eoinjordan/botbuilder/docs/status.md

# Status and assumptions

One place for what has been simulated, checked or assumed. The site, the
recipes and the README do not repeat it. Each recipe carries a short tag
instead: Simulated, Assembly checked, Designed, In analysis, Needs a part or
Not possible.

Builds and parts the owner has printed and checked himself are recorded in
`config/validated.json` and marked on the site with the date. That file is
the only source of such a mark; see [admin.md](admin.md).

## What the tags mean

| Tag | Meaning |
|---|---|
| Simulated | Digitally assembled (`reports/assembly.json`) and run in MuJoCo (`reports/sim.json`). |
| Assembly checked | In the digital assembly only: fit, mass and static balance. |
| Designed | Parts and files as far as they exist for that selection; no analysis numbers. |
| In analysis | Design and analysis in progress on the walkers and two-wheeled builds. |
| Needs a part | Possible once the part the recipe names exists. |
| Not possible | A physical or electrical impossibility, with the reason and the nearest alternative. |

## The biped, as it stood in the README

The robot has never been
assembled or powered. The parts have not been printed as a set. The UNO Q
sketch has not been built or flashed. Dimensions the makers do not publish
are assumed and listed in [docs/assembly.md](assembly.md).

The pages said the same in their own words: the Flash page's commands and
the Control page's real-robot path have been exercised against the virtual
robot (the simulator behind the board's socket) only, and the sketch has not
been built.

## Unverified

- The comb feet: a proposal from simulation. Never printed or loaded; their
  stiffness is a hand calculation and is not in the simulation.
- The round display: its glass diameter, rim thickness, depth and mass, and
  the size of its battery, are assumed. The faces were not analysed on the
  turning head.
- Physical fit of anything: no part has been printed against a servo or a
  camera board.
- The pin holes and studs: no printed one has been tried with a real pin,
  beam or brick. Their nominal dimensions are from secondary sources.
- The other controllers: the masses of the Raspberry Pi boards, the hub's
  battery and the EV3 brick are estimates, and the full-size Pi's hole
  pattern and the EV3's size are not from their makers' pages.
- The turning head: the servo body, shaft position and horn height are
  assumed from SG90 data sheets, the adapter hole pattern is a guess to be
  measured, and no firmware drives it.
- The camera boards: only the ESP32-CAM outline and mass and the ESP32-S3-EYE
  outline are the makers' figures. Lens, button, connector and pin positions,
  board thickness and the other masses are assumed or scaled from pictures.
- The default camera is the ESP-EYE, mounted connector up. That its picture
  is upright with the connector down, so that VFLIP and HMIRROR are needed
  as mounted, is read from the lettering on the board. The sketchbot sketch
  has not been flashed for this robot, and how the board gets its 5 V on
  the robot is not chosen. The plug and cable above the board are not in
  the mass model.
- There is no camera firmware for an ESP32-CAM: see [docs/camera.md](camera.md).
- Every assumed dimension: servo ears, shaft position, horn size, board and
  shield mass, print density and infill.
- Holding torque, backlash, tie slip, flex of the 4 mm plates.
- Floor friction and the contact model, on which the walk and its heading
  drift depend.
- The motion study (docs/motion.md): every result is from the model. Its dead
  band, gear play, series spring, delays and stall currents are estimates;
  the soles are rigid in it.
- Power off: the model's relaxed robot sinks on to the servo travel stops
  (hip pitch 90, knee -90 degrees) and stays on its soles. Where the real
  stops are, and whether they take the weight, is not known. Between hip
  pitch 65 and 75 degrees with level soles the top of each shin grazes the
  torso in the meshes (up to 13 mm3); the model lets it pass. Switched off in
  mid stride the legs meet; where the robot then rests is not predicted.
- The leg clearance rule: checked against the meshes, not on the robot. Its
  4 mm margin is about the size of the play at a sole, so it depends on the
  horn zeros. It covers leg against leg only. Its cost on the microcontroller
  (double arithmetic) has not been measured, and the sketch must be built
  without fused multiply-add for the firmware to agree with the reference.
- The hold command `H` and `ERR CLEAR`: in the reference, the host-compiled
  core and the page; the sketch that carries them has not been built.
- Turning: the step difference does not steer the model reliably. The jump:
  a hop in the model; never to be tried before the robot has stood and
  walked.
- Servo direction and zero in the calibration table.
- The sketch: not built, not flashed. `Serial` as the header UART, relax by
  zero duty and the `String` Bridge function are to be checked at first build.
- Stall currents, and how the Braccio shield shares power with the UNO Q.

## The configurator's data

Maker figures and their sources are in `config/bases.json` and
`config/hardware.json`; every figure there is marked published (with the
URL), assumed (with the reason) or not verified. From the first pass over
the makers' documentation:

- EV3 brick dimensions and mass, and EV3 motor torque and stall current, are
  not from a LEGO document.
- The mass of the Raspberry Pi boards, the Build HAT and its outline, the
  51515 hub battery and an M5Stack Core are estimates or missing.
- That the 51515 hub has the same body as the SPIKE Prime hub whose fact
  sheet gives 88 x 56 x 32 mm and 63 g without battery is assumed.
- No specific I2C servo driver board, H-bridge board or TT motor was checked
  against a maker's page. H-bridge pin names follow the chip data sheets.
- Stall currents of the Braccio servos are assumed (2.0 A and 1.0 A); the
  maker publishes none.
- Whether the BALA-C's servos are the Servo Kit 360 part and take a PWM
  signal directly is not established.
- The free PWM pins on the UNO Q under the Braccio shield are candidates
  read from the core's overlay.
- The Pixy2 on an EV3: Charmed Labs documents the LEGO cable and the LEGO
  I2C setting for a regular Pixy2; their EV3 block and Python class have no
  servo call, and whether the Pixy2's own pan-tilt program runs while it
  answers an EV3 is not stated.
- Pixy2 libraries on the UNO Q, the Raspberry Pi and an M5Stack Core were
  not tried.
- The XIAO ESP32S3 Sense head: mount files are being designed.
- Values a builder must measure are marked "measure" in the recipes: the
  M5Stack bracket and adapter hole patterns, the Pixy pan-tilt base, horn
  screws, wheel shafts and the battery size.

## The Microduck-look biped

Report: [microduck-look.md](microduck-look.md). Generated geometry, an
assembly test and a simulation; nothing printed.

- Servo sizes: the case sizes of the SR431 and SR311 are the maker's; the
  shaft position, the mounting ears, the horn and its height above the case
  are assumed, as for the plate biped. The small servo's body is taken from
  SG90 data sheets; M5Stack gives the kit's size only. Two axes were moved
  because of the ears (hip pitch 4.75 mm, ankle 6.5 mm): if the real ears are
  smaller the moves are larger than needed, if larger the servos meet.
- The small servos: the build needs three position servos. M5Stack's Servo
  Kit 180 is one; the owner's units from a BALA-C are continuous-rotation
  servos driven there through an L9110S bridge and are not usable as joints.
- Masses: UNO Q and shield 55 g a stack, camera 8 g, both estimates. Printed
  mass is volume times 1.24 g/cm3 times 0.8 for shells and 0.6 for brackets
  (0.45 for the lower beak). Wiring is not in the model.
- The shells' walls are the source's, scaled; they were not measured part by
  part. The upper head shell prints standing on its face with supports under
  its closed end: not tried.
- Holding torque limit: half of stall, a rule of thumb. Stall currents of the
  Braccio servos are assumed (2.0 A and 1.0 A).
- Joints hang on the servo shafts; only the neck, head roll and beak have a
  second pivot. What a shaft and its plastic horn carry at the hip is not
  known. The hip yaw shaft carries the leg's weight along its axis.
- Joint ranges are from single-joint sweeps from the stand pose plus one
  sweep of both hip rolls together. Other combinations were not swept. No
  leg clearance rule exists for this build and the webs of the two feet can
  meet.
- The simulation collides parts with the floor only, uses rigid parts and an
  ideal position servo (stall torque at a 4 degree error, no dead band, no
  backlash, no supply limit), a 50 Hz command path with one tick of delay,
  and floor friction 0.6. The motion study's fuller servo model
  (docs/motion.md) was not applied to it.
- The gait is open loop and was searched on three variations of the model
  with a small budget. Whether it steps on the real floor is not known.
- The comb feet are the two feet with fingers added by
  `microduck/look/combfeet.py`: 4 mm thick, 10 mm wide, reaching 32 mm past
  the centre line, one rib each. Their stiffness and strength under the
  robot's weight were not calculated; the simulation takes them as rigid. Not
  printed.
- Walking speed on each set of feet (`reports/microduck-look/summary.json`,
  `walking_speed_by_feet`) is one seeded search and one 30 s run for each, in
  the same simple simulation. The stride the search settled on is at the
  small end of its range on both. In the simulation the two feet do not
  collide with each other; for the comb feet the search checks the feet's
  exact meshes at the commanded poses of one gait cycle instead, which is not
  the same as the poses the model reaches.
- With comb feet and both soles down, one hip turned or rolled alone brings
  the fingers together after a few degrees. No rule in any controller stops
  that; the joint table holds the limits of the plain feet.
- Firmware for fifteen joints, for two boards as one controller and for the
  I2C driver: not written. The channel map in
  `config/microduck-look/build.json` is a proposal.
- The UNO Q's header has six PWM pins, all used by a Braccio shield; that a
  second shield cannot share a board follows from the data sheet's pin table,
  not from a trial.
- The camera lies on its side: the picture needs turning a quarter, which the
  camera sketch does not do.
- The original: its servo variant is not named in Pollen Robotics' files; the
  0.96 N m limit in its simulation is above Robotis' stall figure for either
  XL330 at 5 V.
- Licence: the part pack carries no licence of its own. That it is an export
  of Pollen Robotics' model rests on its name, its part list and identical
  triangle counts with the meshes in their repository.
