eoinjordan/botbuilder/docs/images/lego-ev3-pixy2-top.png

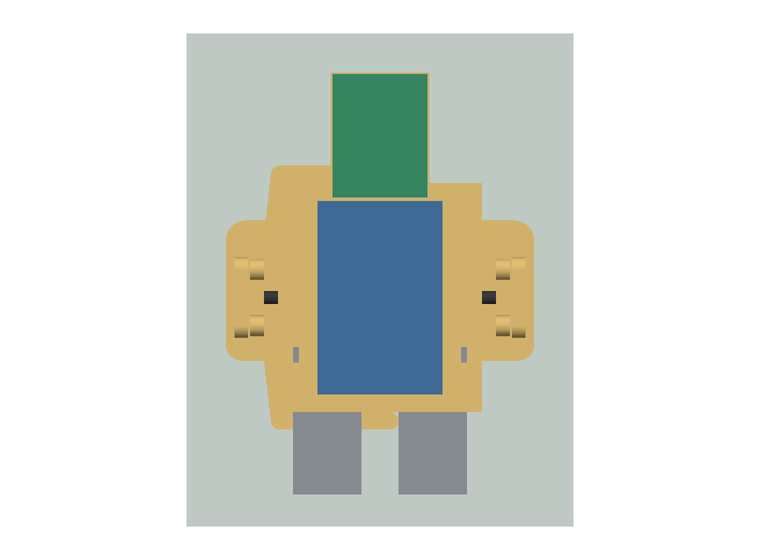
docs/images/lego-ev3-pixy2-top.png
