eoinjordan/botbuilder/site/assets/social-preview.png

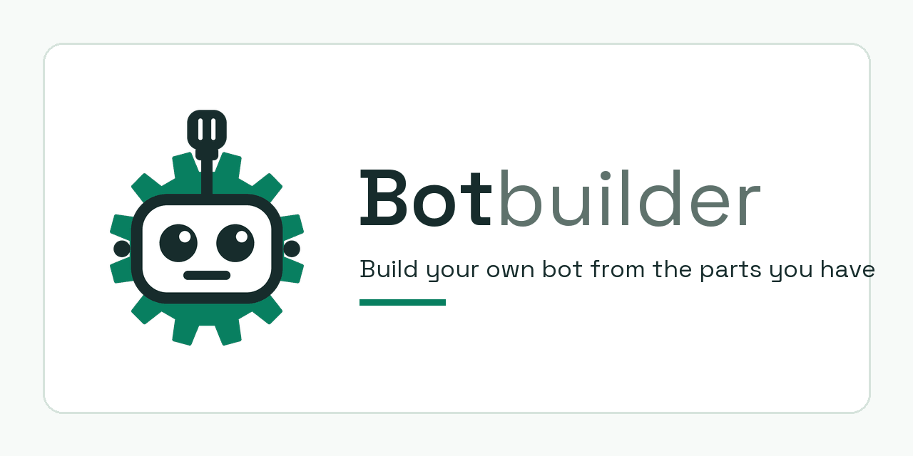
site/assets/social-preview.png
