eoinjordan/botbuilder/stl/thumbs/01_torso_hub51515_cam_esp32cam.png

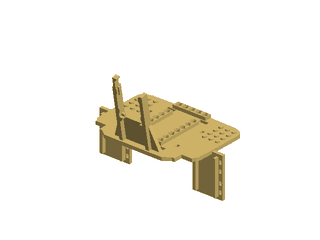
stl/thumbs/01_torso_hub51515_cam_esp32cam.png
