eoinjordan/botbuilder/stl/thumbs/01_torso_unoq_pan_head.png

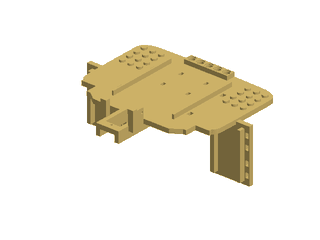
stl/thumbs/01_torso_unoq_pan_head.png
