eoinjordan/botbuilder/stl/thumbs/fit_cam_esp32_s3_eye.png

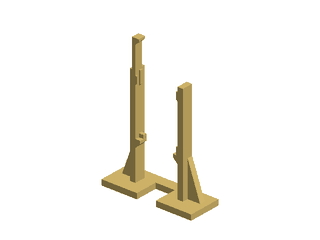
stl/thumbs/fit_cam_esp32_s3_eye.png
