eoinjordan/botbuilder/stl/thumbs/fit_cam_esp_eye.png

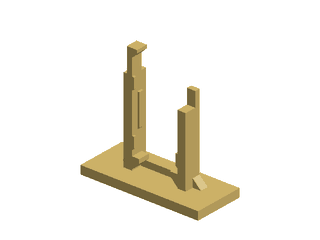
stl/thumbs/fit_cam_esp_eye.png
