eoinjordan/botbuilder/stl/thumbs/fit_horn_drill_blank.png

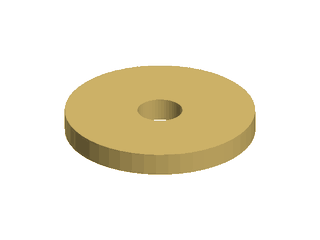
stl/thumbs/fit_horn_drill_blank.png
