eoinjordan/botbuilder/stl/thumbs/fit_lego_compatible_coupon.png

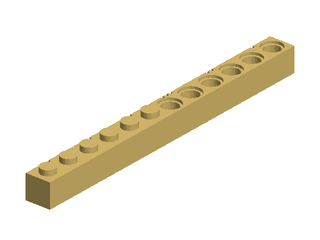
stl/thumbs/fit_lego_compatible_coupon.png
