eoinjordan/botbuilder/stl/thumbs/fit_round_display.png

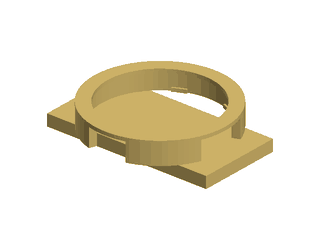
stl/thumbs/fit_round_display.png
