eoinjordan/botbuilder/stl/thumbs/fit_sg90_cradle.png

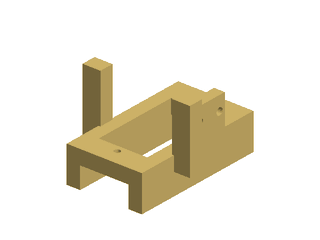
stl/thumbs/fit_sg90_cradle.png
