eoinjordan/botbuilder/stl/thumbs/fit_SR311.png

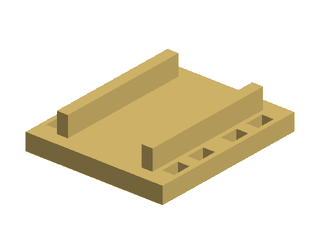
stl/thumbs/fit_SR311.png
