eoinjordan/botbuilder/stl/thumbs/fit_SR431.png

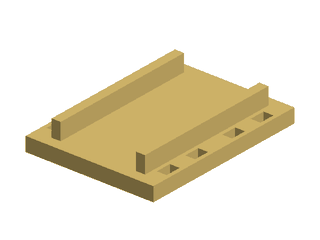
stl/thumbs/fit_SR431.png
