eoinjordan/botbuilder/stl/thumbs/head_pan_platform.png

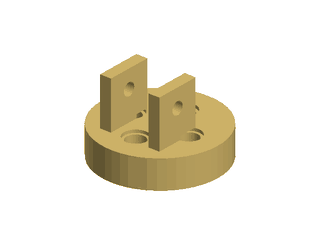
stl/thumbs/head_pan_platform.png
