eoinjordan/botbuilder/stl/thumbs/head_pixy_plate_pixy1.png

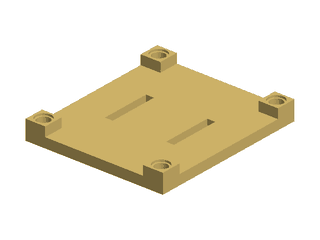
stl/thumbs/head_pixy_plate_pixy1.png
