eoinjordan/botbuilder/stl/thumbs/head_tilt_cradle_esp32cam.png

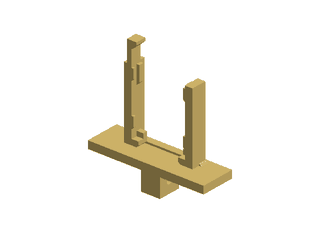
stl/thumbs/head_tilt_cradle_esp32cam.png
