eoinjordan/botbuilder/stl/thumbs/head_tilt_cradle_eyes_above_esp32cam.png

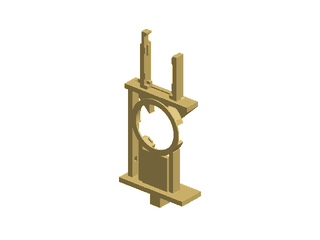
stl/thumbs/head_tilt_cradle_eyes_above_esp32cam.png
