eoinjordan/botbuilder/stl/thumbs/head_tilt_cradle_stack_camera_forward.png

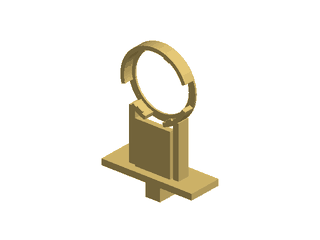
stl/thumbs/head_tilt_cradle_stack_camera_forward.png
