eoinjordan/botbuilder/stl/thumbs/left_hip_roll_pitch_yoke.png

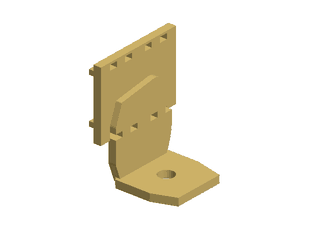
stl/thumbs/left_hip_roll_pitch_yoke.png
