eoinjordan/botbuilder/stl/thumbs/left_shin_comb_foot.png

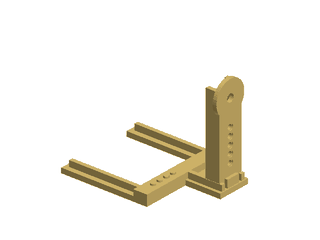
stl/thumbs/left_shin_comb_foot.png
