eoinjordan/botbuilder/stl/thumbs/left_shin_flat_foot.png

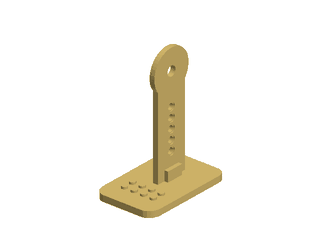
stl/thumbs/left_shin_flat_foot.png
