eoinjordan/botbuilder/stl/thumbs/left_thigh_knee_cradle.png

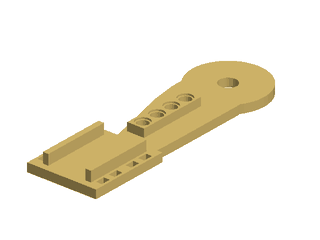
stl/thumbs/left_thigh_knee_cradle.png
