eoinjordan/botbuilder/stl/thumbs/lego/ev3-pixy2/camera_head_pantilt.png

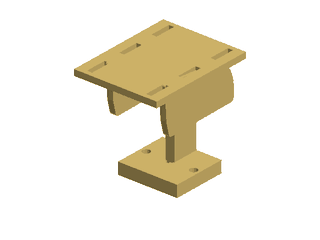
stl/thumbs/lego/ev3-pixy2/camera_head_pantilt.png
