eoinjordan/botbuilder/stl/thumbs/lego/ev3-pixy2/chassis.png

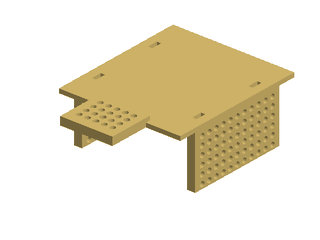
stl/thumbs/lego/ev3-pixy2/chassis.png
