eoinjordan/botbuilder/stl/thumbs/lego/ev3-pixy2/fit_coupon.png

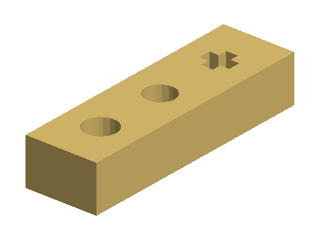
stl/thumbs/lego/ev3-pixy2/fit_coupon.png
