eoinjordan/botbuilder/stl/thumbs/lego/ev3-pixy2/left_leg.png

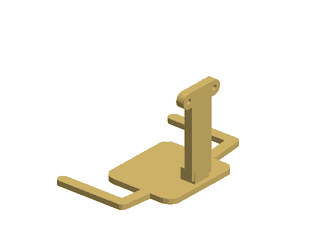
stl/thumbs/lego/ev3-pixy2/left_leg.png
