eoinjordan/botbuilder/stl/thumbs/lego/ev3-pixy2/right_leg.png

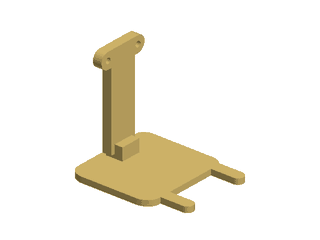
stl/thumbs/lego/ev3-pixy2/right_leg.png
