eoinjordan/botbuilder/stl/thumbs/lego/hub-51515/chassis.png

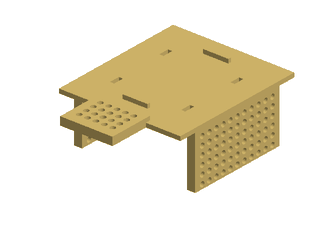
stl/thumbs/lego/hub-51515/chassis.png
