eoinjordan/botbuilder/stl/thumbs/lego/wheeled/driver_plate.png

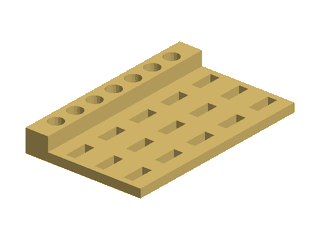
stl/thumbs/lego/wheeled/driver_plate.png
