eoinjordan/botbuilder/stl/thumbs/lego/wheeled/fit_bore_cross.png

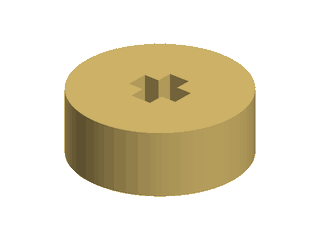
stl/thumbs/lego/wheeled/fit_bore_cross.png
