eoinjordan/botbuilder/stl/thumbs/lego/wheeled/fit_bore_tt.png

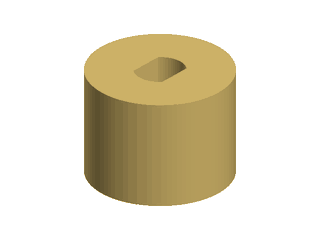
stl/thumbs/lego/wheeled/fit_bore_tt.png
