eoinjordan/botbuilder/stl/thumbs/lego/wheeled/fit_servo_cradle.png

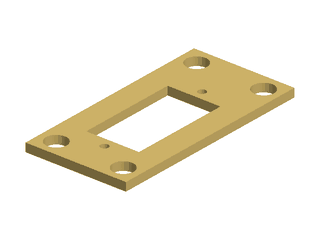
stl/thumbs/lego/wheeled/fit_servo_cradle.png
