eoinjordan/botbuilder/stl/thumbs/lego/wheeled/fit_tt_cradle.png

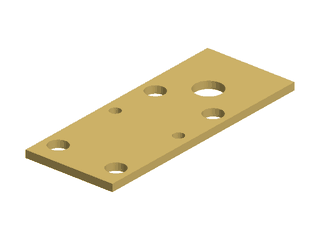
stl/thumbs/lego/wheeled/fit_tt_cradle.png
