eoinjordan/botbuilder/stl/thumbs/lego/wheeled/hub_tpu_cross_d56.png

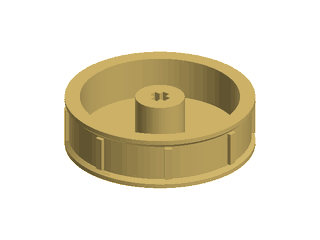
stl/thumbs/lego/wheeled/hub_tpu_cross_d56.png
