eoinjordan/botbuilder/stl/thumbs/lego/wheeled/idler_hub.png

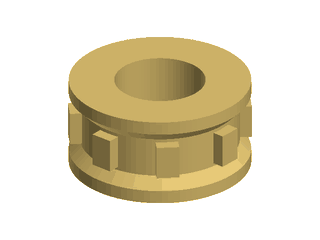
stl/thumbs/lego/wheeled/idler_hub.png
