eoinjordan/botbuilder/stl/thumbs/lego/wheeled/idler_tyre_tpu.png

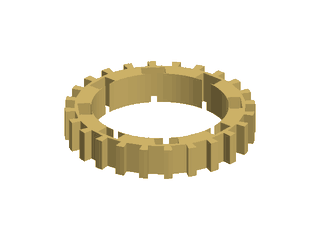
stl/thumbs/lego/wheeled/idler_tyre_tpu.png
