eoinjordan/botbuilder/stl/thumbs/lego/wheeled/post_d43.png

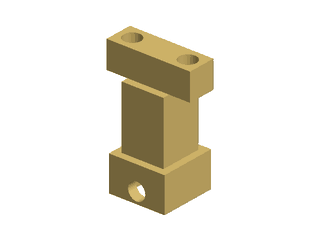
stl/thumbs/lego/wheeled/post_d43.png
