eoinjordan/botbuilder/stl/thumbs/lego/wheeled/tip_idler_fork.png

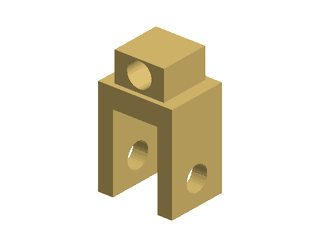
stl/thumbs/lego/wheeled/tip_idler_fork.png
