eoinjordan/botbuilder/stl/thumbs/lego/wheeled/tyre_tpu_d43.png

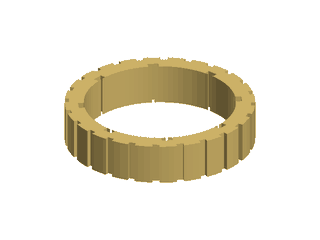
stl/thumbs/lego/wheeled/tyre_tpu_d43.png
