eoinjordan/botbuilder/stl/thumbs/microduck-look/beak_jaw.png

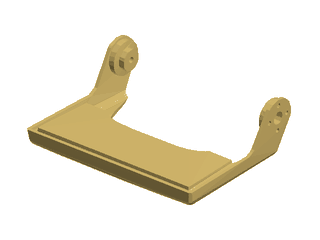
stl/thumbs/microduck-look/beak_jaw.png
