eoinjordan/botbuilder/stl/thumbs/microduck-look/beak_top.png

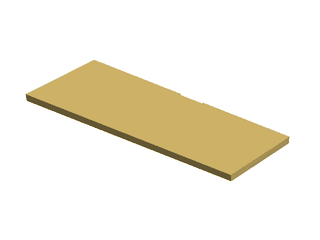
stl/thumbs/microduck-look/beak_top.png
