eoinjordan/botbuilder/stl/thumbs/microduck-look/body_left.png

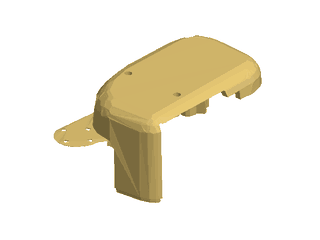
stl/thumbs/microduck-look/body_left.png
