eoinjordan/botbuilder/stl/thumbs/microduck-look/body_right.png

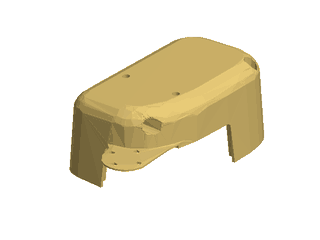
stl/thumbs/microduck-look/body_right.png
