eoinjordan/botbuilder/stl/thumbs/microduck-look/fit_eye_esp_eye.png

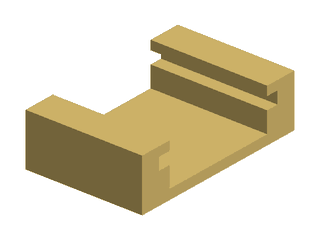
stl/thumbs/microduck-look/fit_eye_esp_eye.png
