eoinjordan/botbuilder/stl/thumbs/microduck-look/fit_M5_180.png

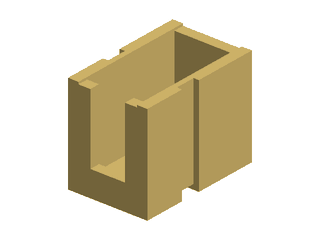
stl/thumbs/microduck-look/fit_M5_180.png
