eoinjordan/botbuilder/stl/thumbs/microduck-look/fit_SR311.png

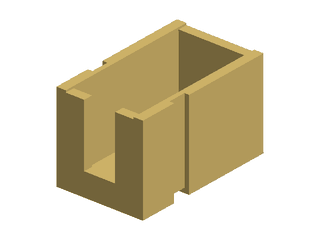
stl/thumbs/microduck-look/fit_SR311.png
