eoinjordan/botbuilder/stl/thumbs/microduck-look/fit_SR431.png

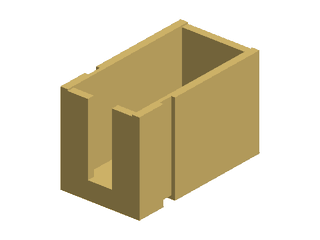
stl/thumbs/microduck-look/fit_SR431.png
