eoinjordan/botbuilder/stl/thumbs/microduck-look/head_base.png

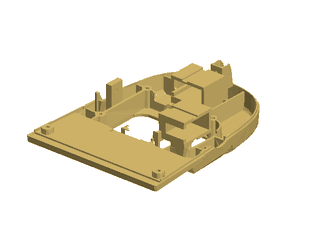
stl/thumbs/microduck-look/head_base.png
