eoinjordan/botbuilder/stl/thumbs/microduck-look/head_face.png

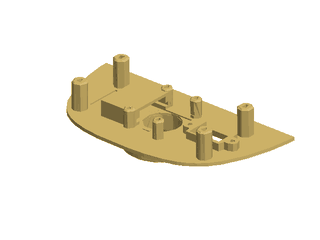
stl/thumbs/microduck-look/head_face.png
