eoinjordan/botbuilder/stl/thumbs/microduck-look/head_pitch_yoke.png

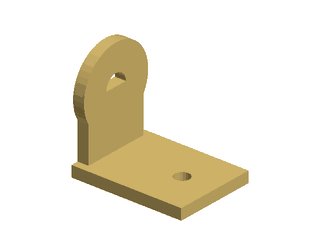
stl/thumbs/microduck-look/head_pitch_yoke.png
