eoinjordan/botbuilder/stl/thumbs/microduck-look/head_top.png

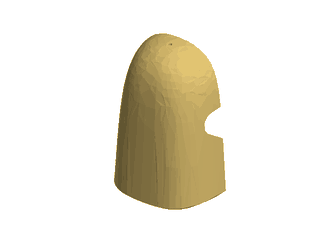
stl/thumbs/microduck-look/head_top.png
