eoinjordan/botbuilder/stl/thumbs/microduck-look/head_yaw_carrier.png

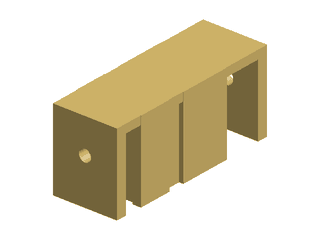
stl/thumbs/microduck-look/head_yaw_carrier.png
