eoinjordan/botbuilder/stl/thumbs/microduck-look/left_foot.png

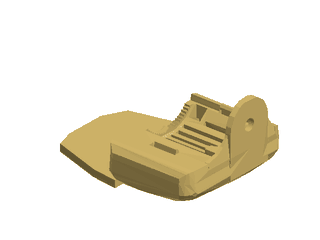
stl/thumbs/microduck-look/left_foot.png
