eoinjordan/botbuilder/stl/thumbs/microduck-look/left_foot_comb.png

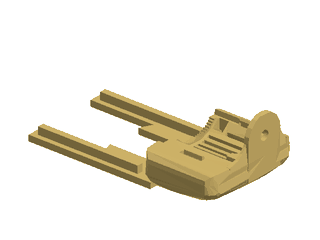
stl/thumbs/microduck-look/left_foot_comb.png
