eoinjordan/botbuilder/stl/thumbs/microduck-look/left_hip_roll.png

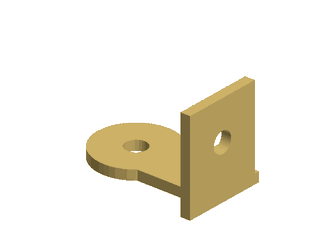
stl/thumbs/microduck-look/left_hip_roll.png
