eoinjordan/botbuilder/stl/thumbs/microduck-look/left_hip_yaw.png

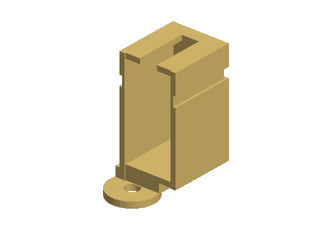
stl/thumbs/microduck-look/left_hip_yaw.png
