eoinjordan/botbuilder/stl/thumbs/microduck-look/left_shin.png

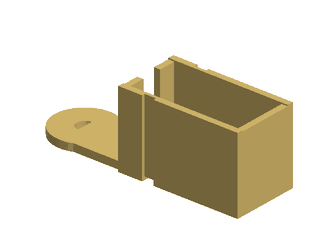
stl/thumbs/microduck-look/left_shin.png
