eoinjordan/botbuilder/stl/thumbs/microduck-look/left_thigh.png

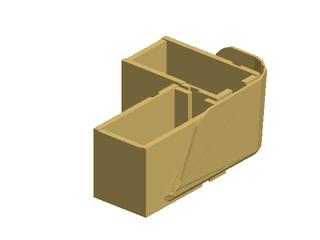
stl/thumbs/microduck-look/left_thigh.png
