eoinjordan/botbuilder/stl/thumbs/microduck-look/neck.png

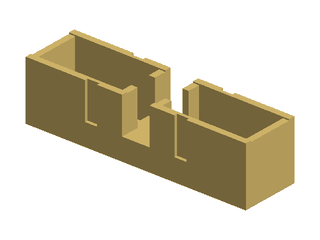
stl/thumbs/microduck-look/neck.png
