eoinjordan/botbuilder/stl/thumbs/microduck-look/right_foot.png

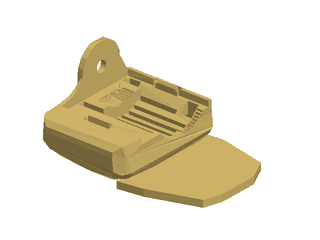
stl/thumbs/microduck-look/right_foot.png
