eoinjordan/botbuilder/stl/thumbs/microduck-look/right_foot_comb.png

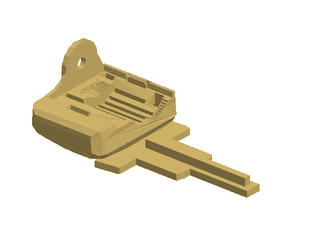
stl/thumbs/microduck-look/right_foot_comb.png
