eoinjordan/botbuilder/stl/thumbs/microduck-look/right_hip_roll.png

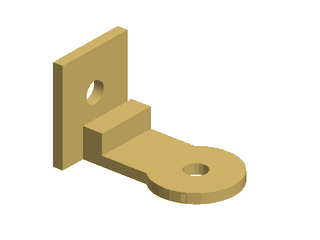
stl/thumbs/microduck-look/right_hip_roll.png
