eoinjordan/botbuilder/stl/thumbs/microduck-look/right_shin.png

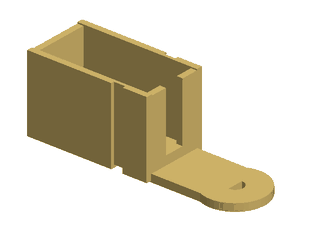
stl/thumbs/microduck-look/right_shin.png
