eoinjordan/botbuilder/stl/thumbs/microduck-look/right_thigh.png

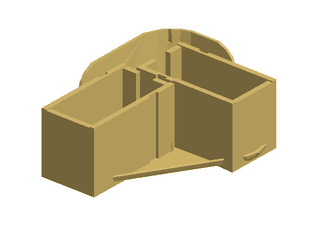
stl/thumbs/microduck-look/right_thigh.png
