eoinjordan/botbuilder/stl/thumbs/microduck-look/trunk_frame.png

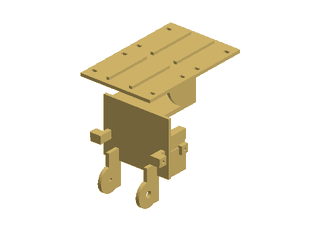
stl/thumbs/microduck-look/trunk_frame.png
