eoinjordan/botbuilder/stl/thumbs/right_hip_roll_pitch_yoke.png

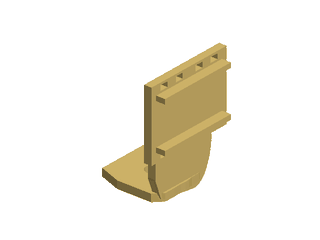
stl/thumbs/right_hip_roll_pitch_yoke.png
