eoinjordan/botbuilder/stl/thumbs/right_shin_comb_foot.png

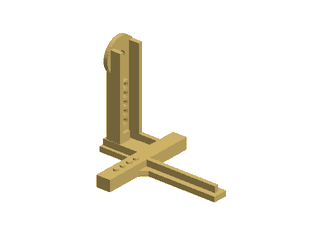
stl/thumbs/right_shin_comb_foot.png
