eoinjordan/botbuilder/docs/components/aa.png

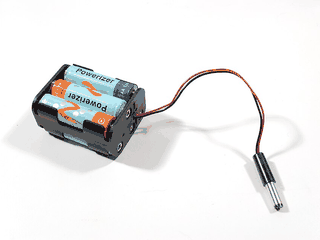
docs/components/aa.png
