eoinjordan/botbuilder/docs/components/angular_motor.png

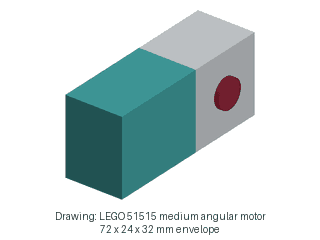
docs/components/angular_motor.png
