eoinjordan/botbuilder/docs/components/ball.png

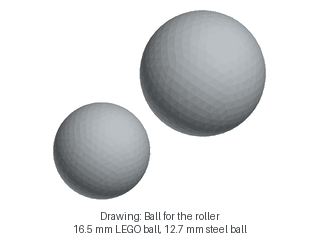
docs/components/ball.png
