eoinjordan/botbuilder/docs/components/braccio_shield.png

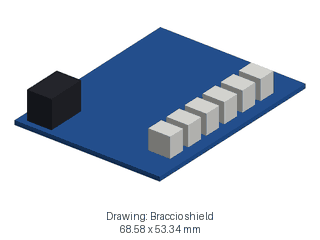
docs/components/braccio_shield.png
