eoinjordan/botbuilder/docs/components/cable_tie.png

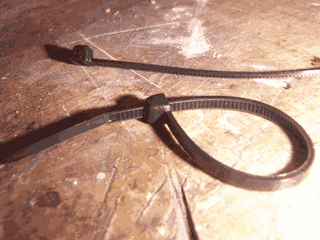
docs/components/cable_tie.png
