eoinjordan/botbuilder/docs/components/camera_none.png

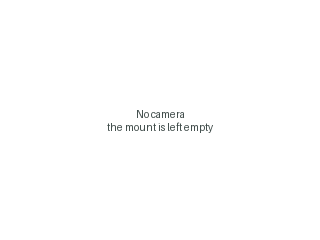
docs/components/camera_none.png
