eoinjordan/botbuilder/docs/components/esp32_s3_eye.png

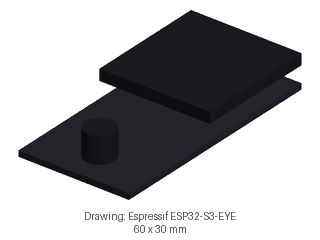
docs/components/esp32_s3_eye.png
