eoinjordan/botbuilder/docs/components/esp32cam.png

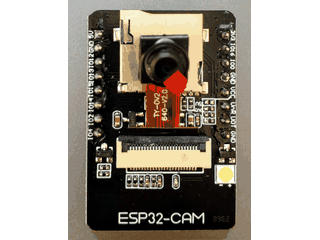
docs/components/esp32cam.png
