eoinjordan/botbuilder/docs/components/esp_eye.png

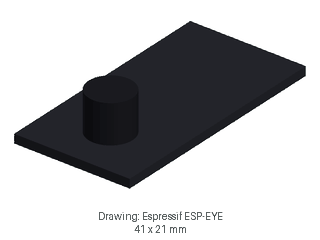
docs/components/esp_eye.png
