eoinjordan/botbuilder/docs/components/ev3_brick.png

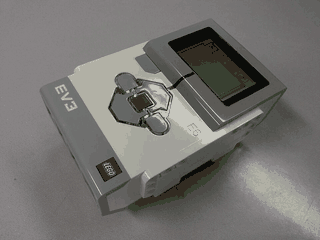
docs/components/ev3_brick.png
