eoinjordan/botbuilder/docs/components/ev3_large_motor.png

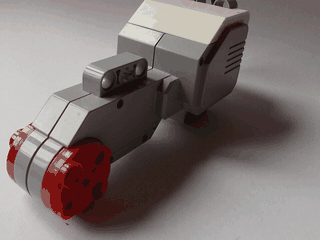
docs/components/ev3_large_motor.png
