eoinjordan/botbuilder/docs/components/ev3_medium_motor.png

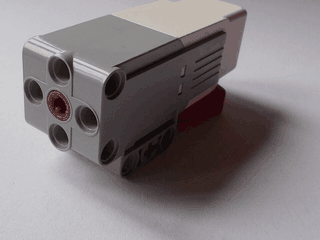
docs/components/ev3_medium_motor.png
