eoinjordan/botbuilder/docs/components/hbridge.png

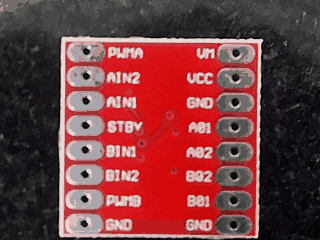
docs/components/hbridge.png
