eoinjordan/botbuilder/docs/components/hub51515.png

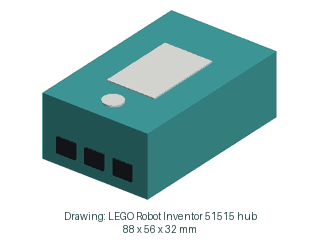
docs/components/hub51515.png
