eoinjordan/botbuilder/docs/components/lego_wheel.png

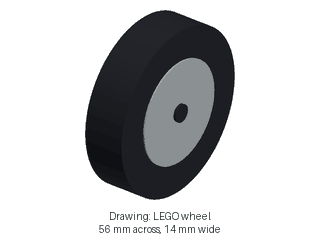
docs/components/lego_wheel.png
