eoinjordan/botbuilder/docs/components/lipo.png

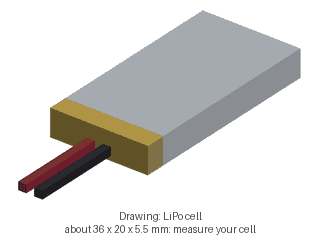
docs/components/lipo.png
