eoinjordan/botbuilder/docs/components/m5_360.png

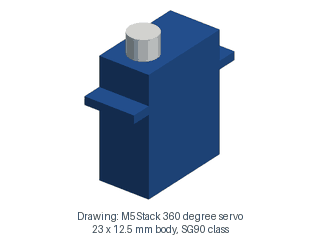
docs/components/m5_360.png
