eoinjordan/botbuilder/docs/components/m5core.png

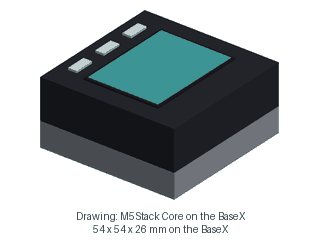
docs/components/m5core.png
