eoinjordan/botbuilder/docs/components/o_ring.png

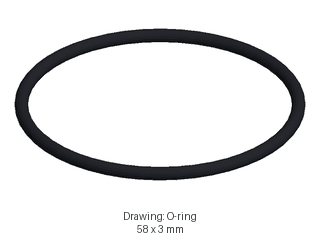
docs/components/o_ring.png
