eoinjordan/botbuilder/docs/components/pca9685.png

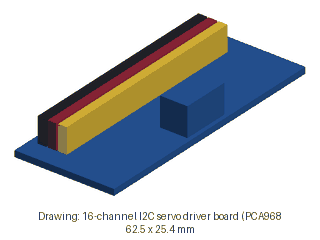
docs/components/pca9685.png
