eoinjordan/botbuilder/docs/components/pi_full.png

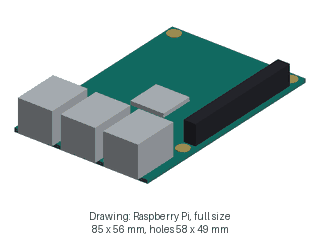
docs/components/pi_full.png
