eoinjordan/botbuilder/docs/components/pi_zero_2w.png

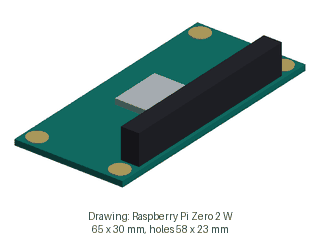
docs/components/pi_zero_2w.png
