eoinjordan/botbuilder/docs/components/picam2.png

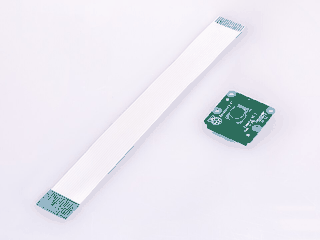
docs/components/picam2.png
