eoinjordan/botbuilder/docs/components/pixy2.png

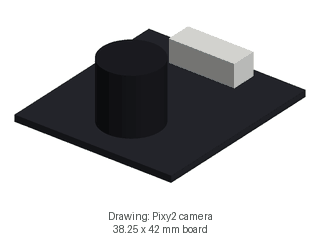
docs/components/pixy2.png
