eoinjordan/botbuilder/docs/components/pixy_pantilt.png

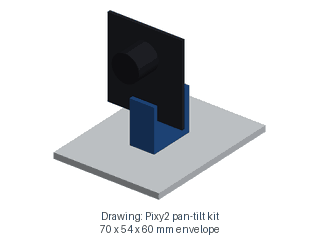
docs/components/pixy_pantilt.png
