eoinjordan/botbuilder/docs/components/power_bank.png

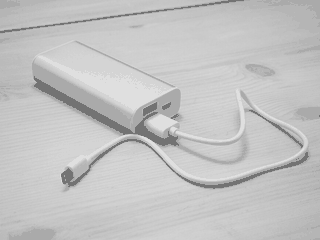
docs/components/power_bank.png
