eoinjordan/botbuilder/docs/components/ribbon.png

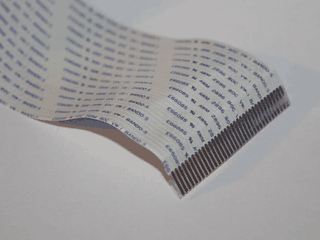
docs/components/ribbon.png
