eoinjordan/botbuilder/docs/components/round_display.png

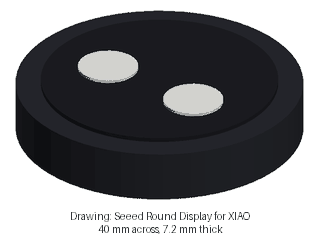
docs/components/round_display.png
