eoinjordan/botbuilder/docs/components/screws.png

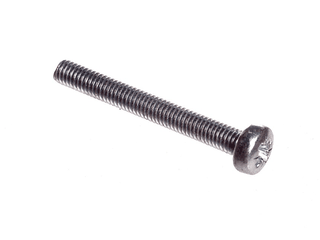
docs/components/screws.png
