eoinjordan/botbuilder/docs/components/servo_horn.png

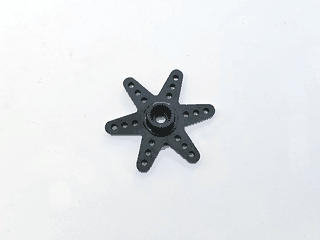
docs/components/servo_horn.png
