eoinjordan/botbuilder/docs/components/sg90.png

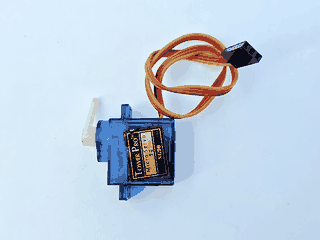
docs/components/sg90.png
