eoinjordan/botbuilder/docs/components/sr311.png

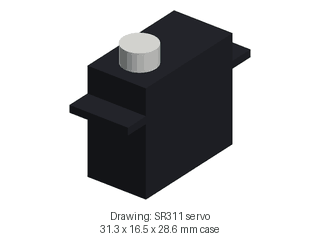
docs/components/sr311.png
