eoinjordan/botbuilder/docs/components/supply.png

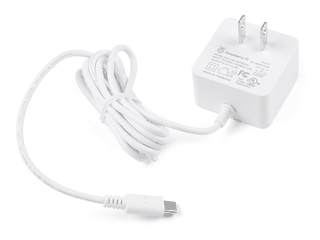
docs/components/supply.png
