eoinjordan/botbuilder/docs/components/switch.png

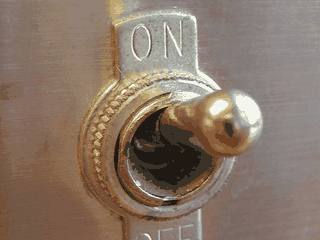
docs/components/switch.png
