eoinjordan/botbuilder/docs/components/technic_axle.png

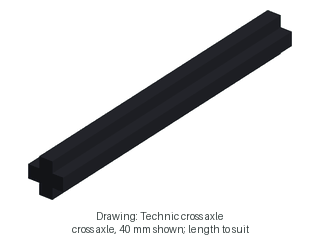
docs/components/technic_axle.png
