eoinjordan/botbuilder/docs/components/technic_beam.png

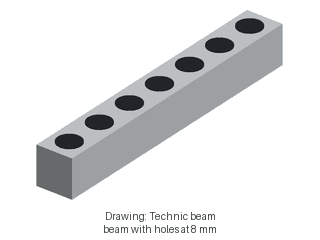
docs/components/technic_beam.png
