eoinjordan/botbuilder/docs/components/technic_bush.png

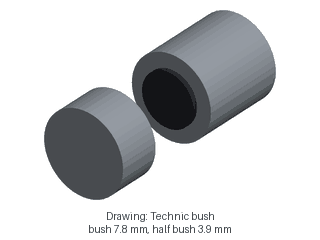
docs/components/technic_bush.png
