eoinjordan/botbuilder/docs/components/technic_pin.png

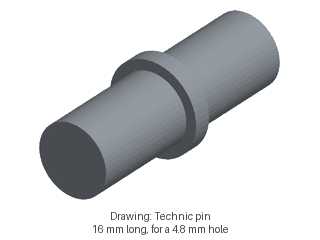
docs/components/technic_pin.png
