eoinjordan/botbuilder/docs/components/tt_motor.png

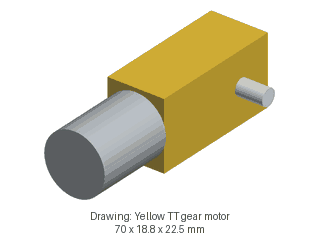
docs/components/tt_motor.png
