eoinjordan/botbuilder/docs/components/tt_wheel.png

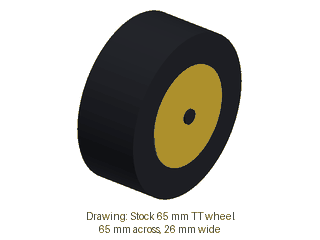
docs/components/tt_wheel.png
