eoinjordan/botbuilder/docs/components/unoq.png

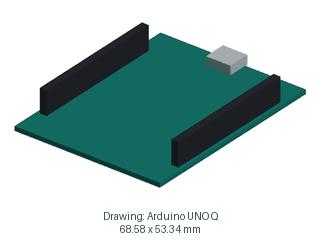
docs/components/unoq.png
