eoinjordan/botbuilder/docs/components/wheels_back.png

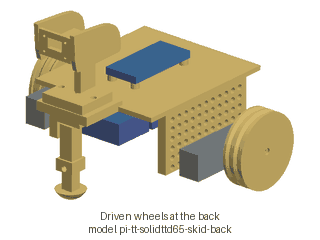
docs/components/wheels_back.png
