eoinjordan/botbuilder/docs/components/wheels_front.png

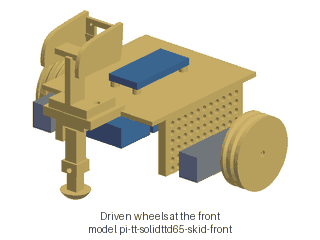
docs/components/wheels_front.png
