eoinjordan/botbuilder/docs/components/xiao_sense.png

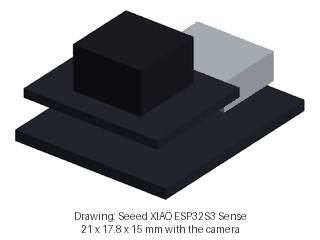
docs/components/xiao_sense.png
