eoinjordan/botbuilder/stl/01_torso_unoq_eyes_below_esp_eye.stl

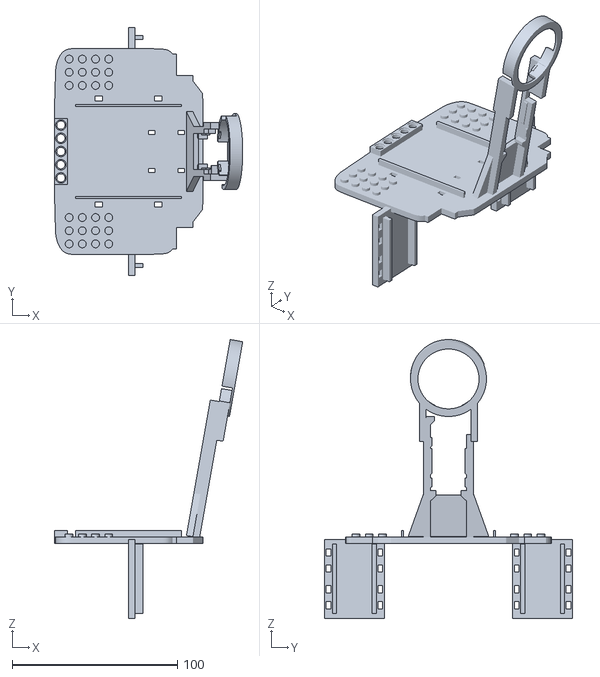
[picture p144: CAD file, 2026-11-12]
stl/01_torso_unoq_eyes_below_esp_eye.stl
114.2 x 150.5 x 169.1
