eoinjordan/botbuilder/stl/lego/ev3-pixy2/camera_head_pantilt.stl

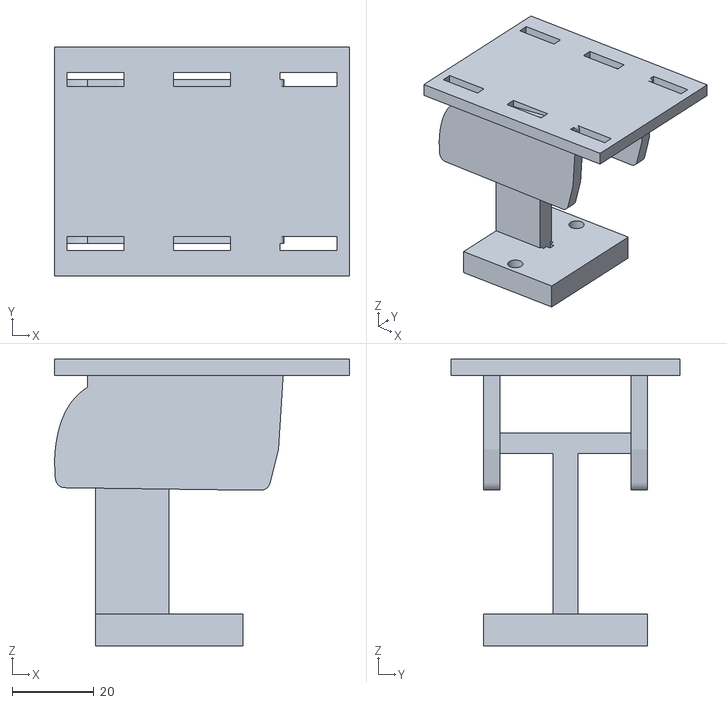
[picture p145: CAD file, 2026-11-11]
stl/lego/ev3-pixy2/camera_head_pantilt.stl
72.0 x 56.0 x 70.0
