eoinjordan/botbuilder/stl/lego/hub-51515/gear_16t_print_6.stl

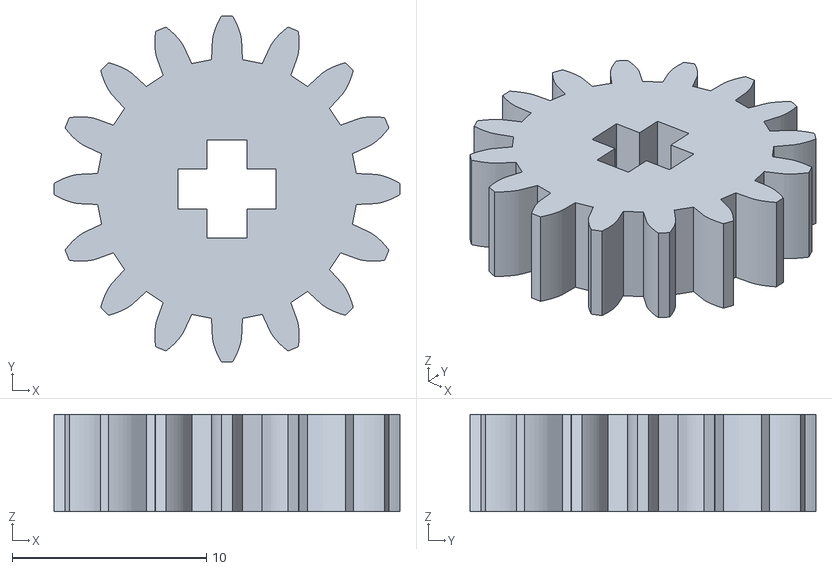
[picture p146: CAD file, 2026-11-11]
stl/lego/hub-51515/gear_16t_print_6.stl
17.8 x 17.8 x 5.00
