eoinjordan/botbuilder/stl/lego/pi-zero-2w-51515/camera_head.stl

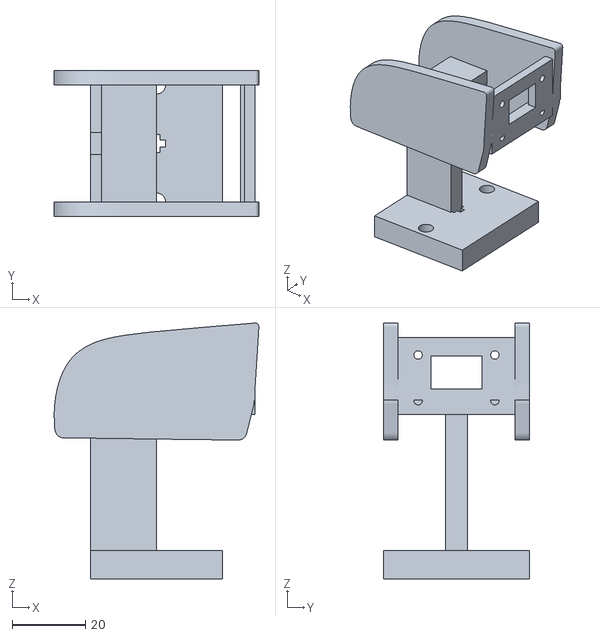
[picture p147: CAD file, 2026-11-11]
stl/lego/pi-zero-2w-51515/camera_head.stl
56.0 x 40.0 x 70.0
