eoinjordan/botbuilder/stl/lego/wheeled/tyre_tpu_d56.stl

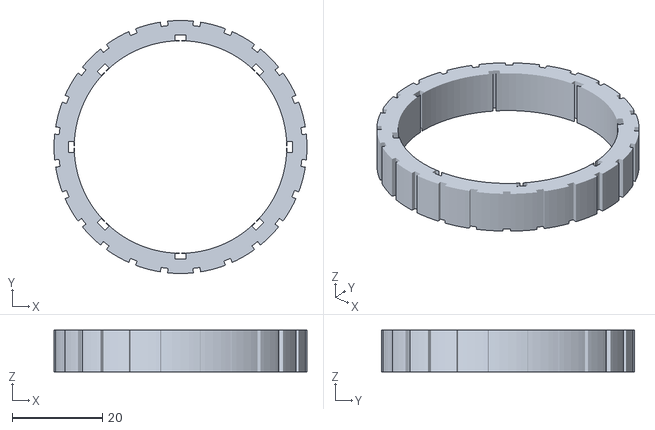
[picture p148: CAD file, 2026-11-11]
stl/lego/wheeled/tyre_tpu_d56.stl
56.0 x 56.0 x 9.20
