eoinjordan/botbuilder/stl/microduck-look/right_foot_comb.stl

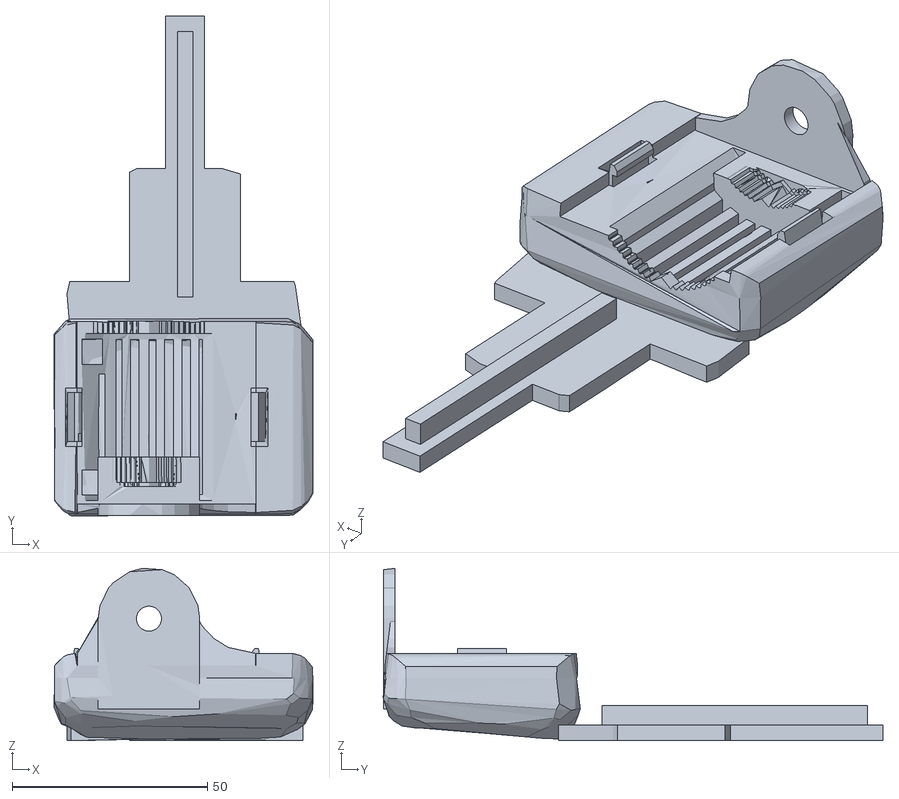
[picture p149: CAD file, 2026-11-12]
stl/microduck-look/right_foot_comb.stl
66.3 x 128.1 x 44.1
