eoinjordan/botbuilder/stl/lego/ev3-pixy2/crank_print_4.stl

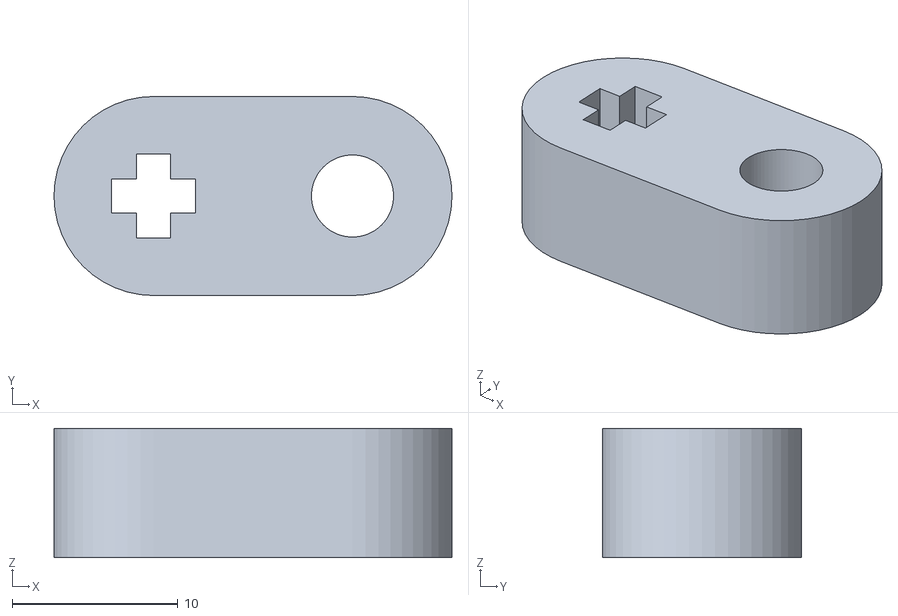
[picture p151: CAD file, 2026-11-11]
stl/lego/ev3-pixy2/crank_print_4.stl
24.0 x 12.0 x 7.80
