eoinjordan/botbuilder/stl/lego/hub-51515/camera_head.stl

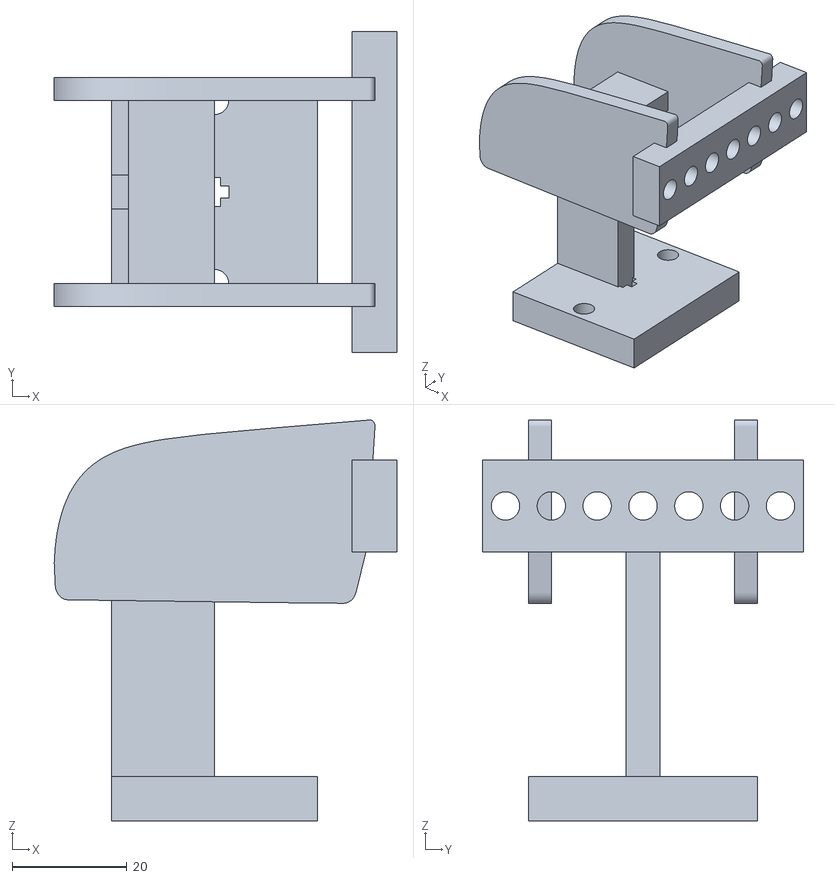
[picture p152: CAD file, 2026-11-11]
stl/lego/hub-51515/camera_head.stl
59.8 x 56.0 x 70.0
