eoinjordan/botbuilder/stl/lego/wheeled/tip_ball_16p5.stl

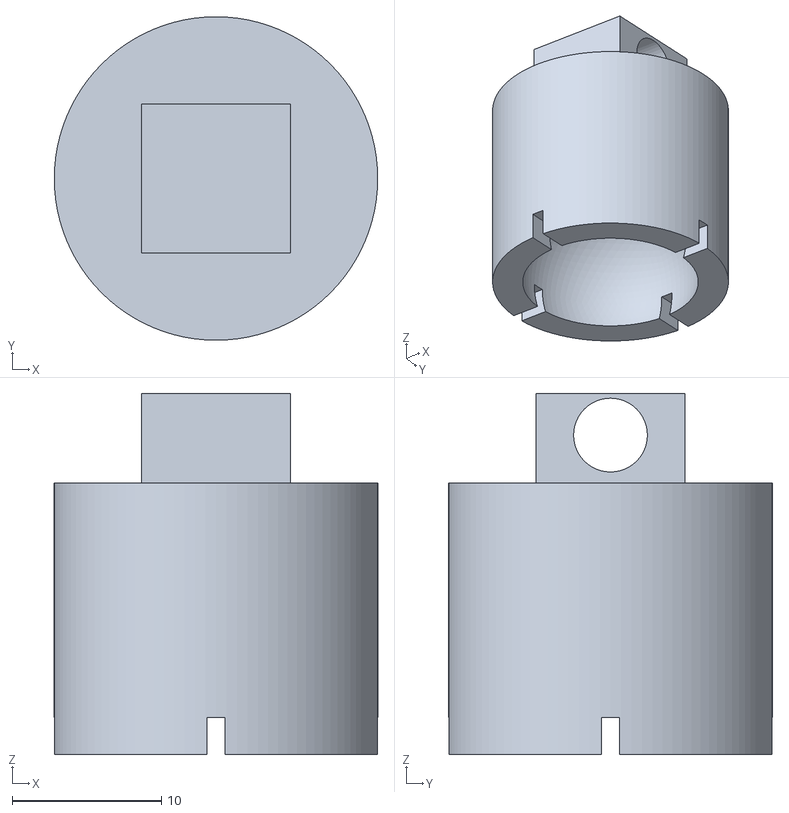
[picture p153: CAD file, 2026-11-11]
stl/lego/wheeled/tip_ball_16p5.stl
21.7 x 21.7 x 24.2
