eoinjordan/botbuilder/stl/microduck-look/left_foot_comb.stl

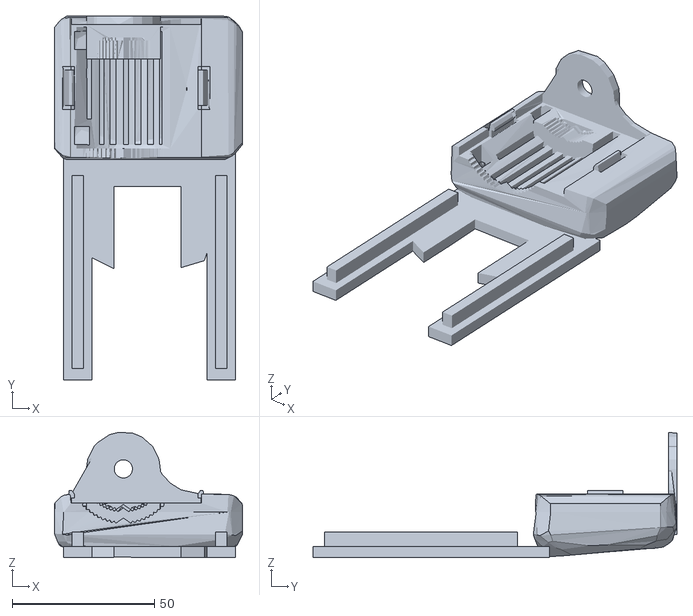
[picture p154: CAD file, 2026-11-12]
stl/microduck-look/left_foot_comb.stl
66.3 x 128.1 x 44.1
