eoinjordan/botbuilder/stl/fit_cam_esp_eye.stl

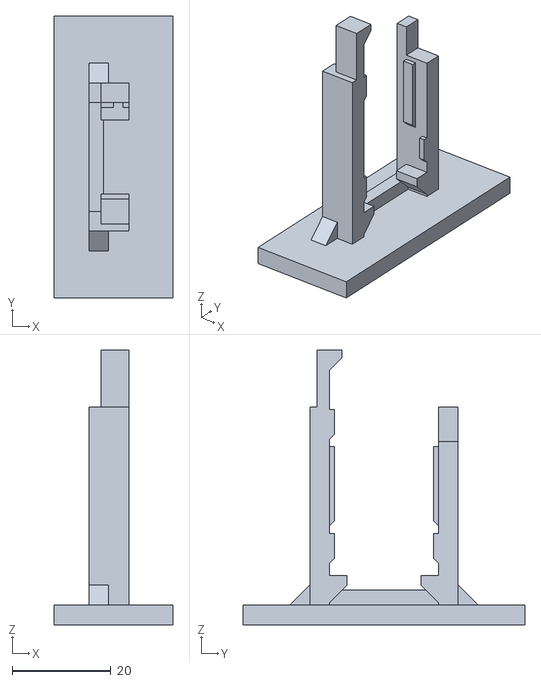
[picture p155: CAD file, 2026-11-12]
stl/fit_cam_esp_eye.stl
24.0 x 57.0 x 55.5
