eoinjordan/botbuilder/stl/lego/ev3-pixy2/chassis.stl

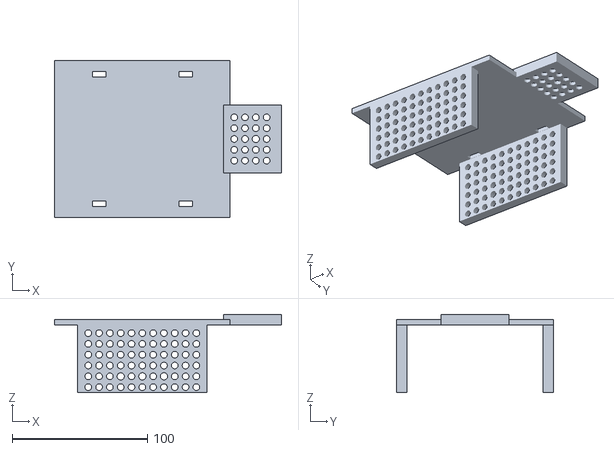
[picture p156: CAD file, 2026-11-11]
stl/lego/ev3-pixy2/chassis.stl
168.0 x 116.0 x 57.8
