eoinjordan/botbuilder/stl/lego/hub-51515/chassis.stl

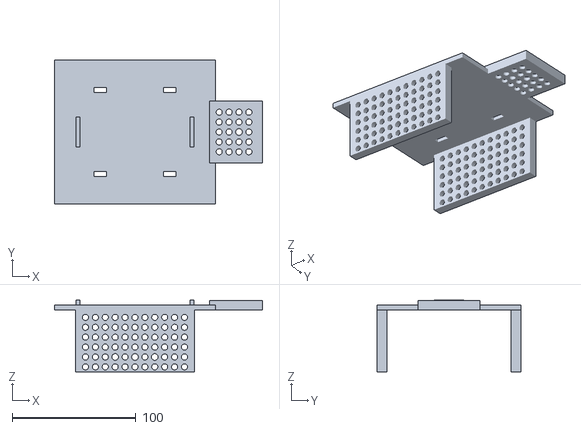
[picture p157: CAD file, 2026-11-11]
stl/lego/hub-51515/chassis.stl
168.0 x 116.0 x 57.9
