eoinjordan/botbuilder/stl/lego/pi-zero-2w-51515/left_leg.stl

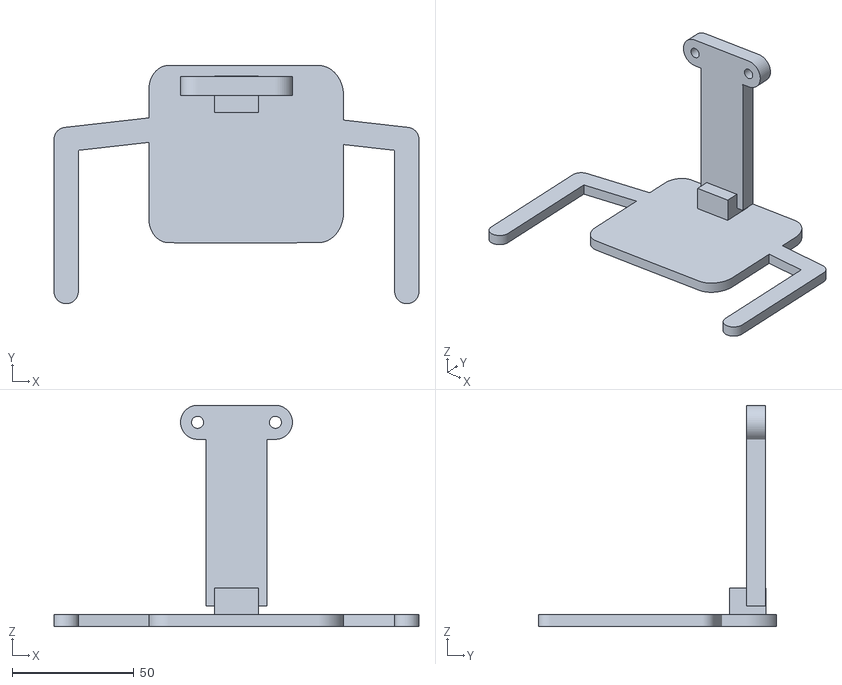
[picture p158: CAD file, 2026-11-11]
stl/lego/pi-zero-2w-51515/left_leg.stl
150.0 x 98.0 x 91.0
