eoinjordan/botbuilder/stl/microduck-look/head_base.stl

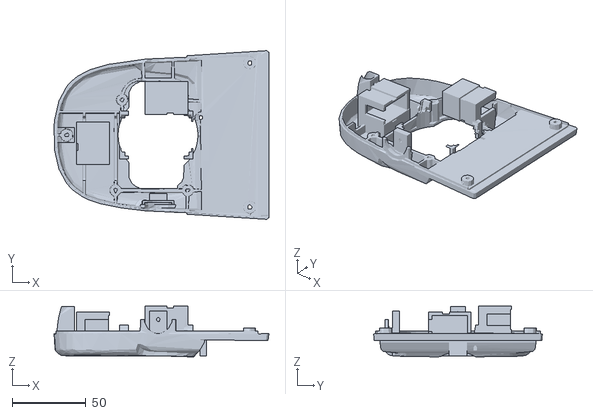
[picture p160: CAD file, 2026-11-11]
stl/microduck-look/head_base.stl
145.4 x 114.1 x 34.3
