eoinjordan/botbuilder/stl/head_tilt_cradle_eyes_above_esp_eye.stl

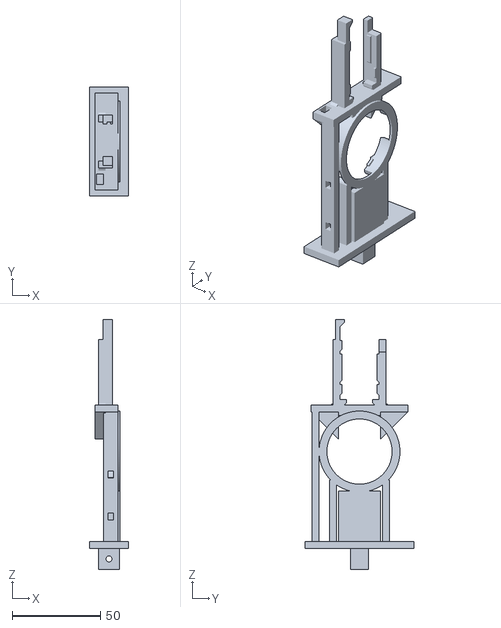
[picture p161: CAD file, 2026-11-12]
stl/head_tilt_cradle_eyes_above_esp_eye.stl
22.0 x 62.0 x 142.0
