eoinjordan/botbuilder/stl/lego/pi-zero-2w-51515/right_leg.stl

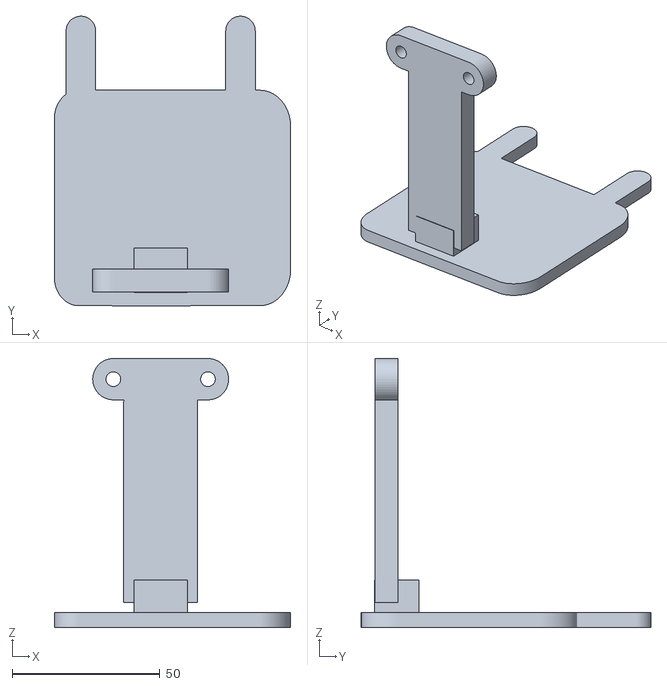
[picture p162: CAD file, 2026-11-11]
stl/lego/pi-zero-2w-51515/right_leg.stl
80.0 x 98.0 x 91.0
