eoinjordan/botbuilder/stl/lego/wheeled/idler_tyre_tpu.stl

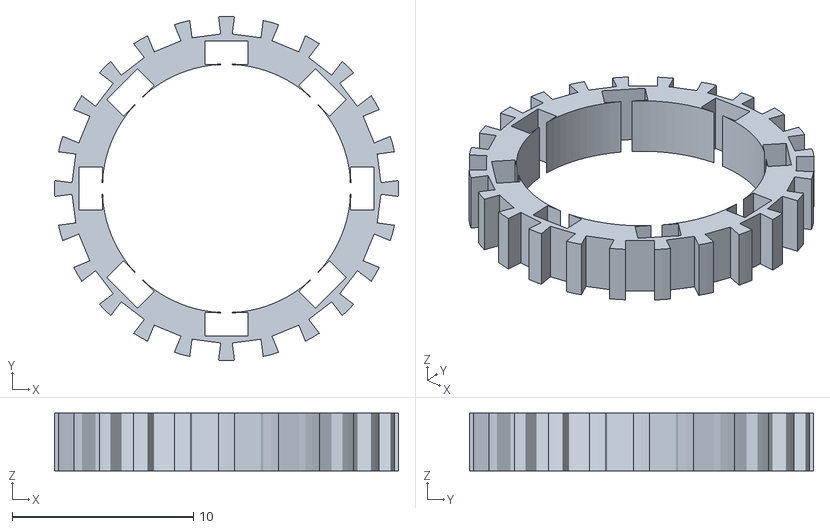
[picture p163: CAD file, 2026-11-11]
stl/lego/wheeled/idler_tyre_tpu.stl
19.0 x 19.0 x 3.20
