eoinjordan/botbuilder/stl/microduck-look/beak_top.stl

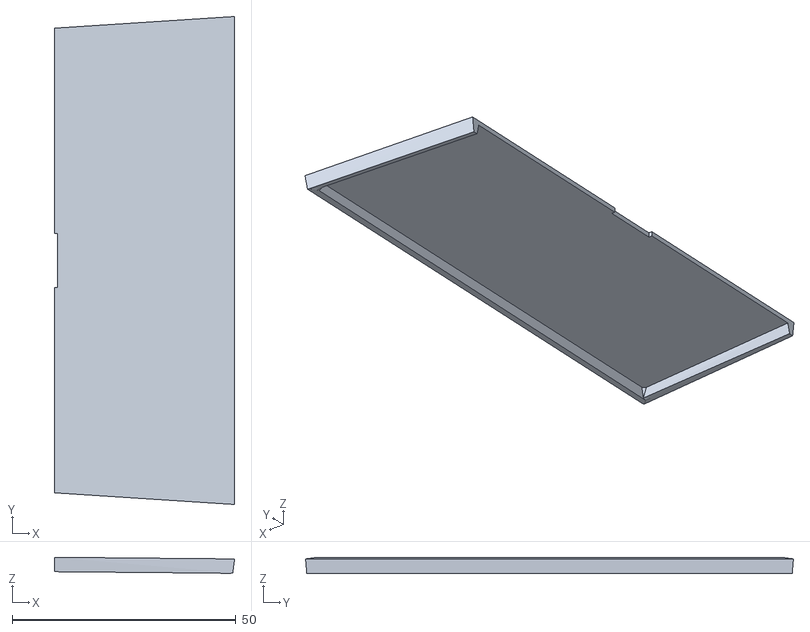
[picture p164: CAD file, 2026-11-11]
stl/microduck-look/beak_top.stl
40.3 x 109.2 x 3.67
