eoinjordan/botbuilder/stl/lego/pi-zero-2w-51515/chassis.stl

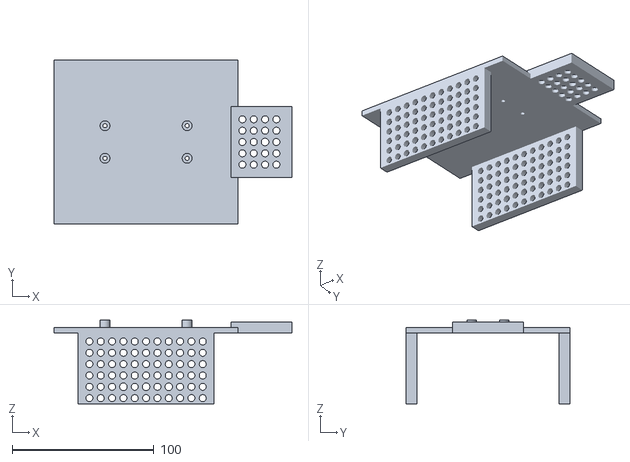
[picture p166: CAD file, 2026-11-11]
stl/lego/pi-zero-2w-51515/chassis.stl
168.0 x 116.0 x 59.0
