eoinjordan/botbuilder/stl/lego/wheeled/post_d56.stl

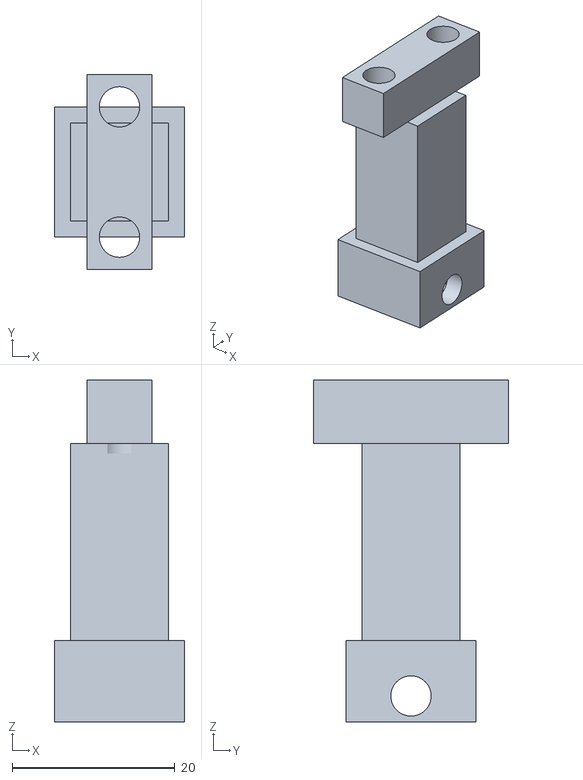
[picture p167: CAD file, 2026-11-11]
stl/lego/wheeled/post_d56.stl
16.0 x 24.0 x 42.0
