eoinjordan/botbuilder/stl/microduck-look/fit_horn_SR431.stl

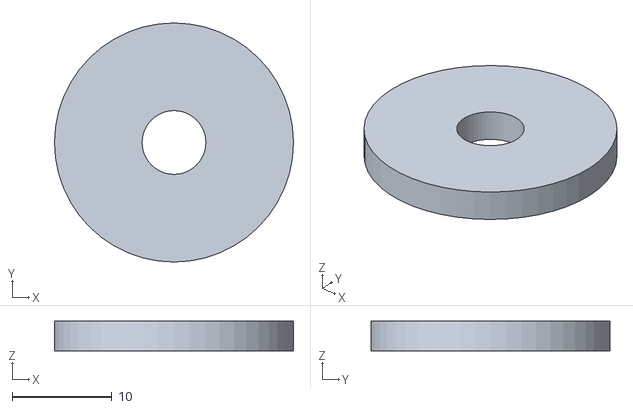
[picture p168: CAD file, 2026-11-11]
stl/microduck-look/fit_horn_SR431.stl
24.0 x 24.0 x 3.00
