eoinjordan/botbuilder/stl/head_tilt_cradle_eyes_below_esp_eye.stl

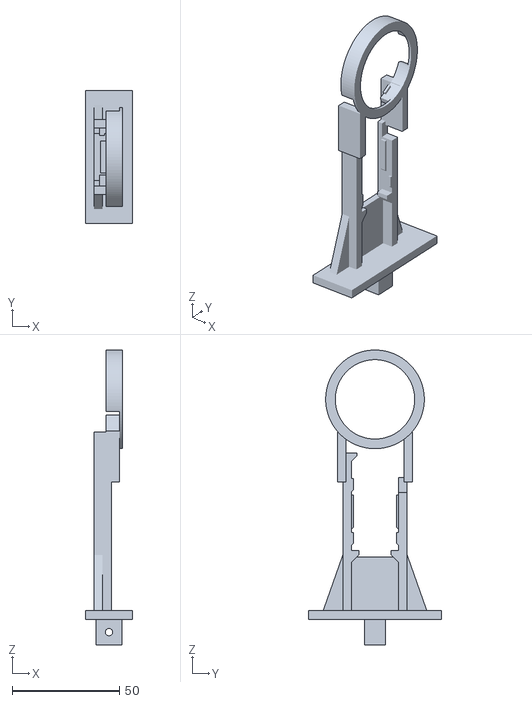
[picture p169: CAD file, 2026-11-12]
stl/head_tilt_cradle_eyes_below_esp_eye.stl
22.0 x 62.0 x 137.5
