eoinjordan/botbuilder/stl/lego/ev3-pixy2/fit_coupon.stl

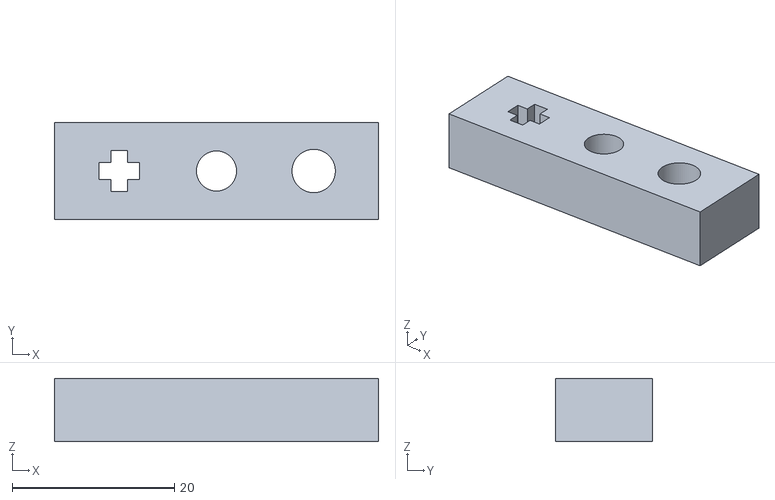
[picture p170: CAD file, 2026-11-11]
stl/lego/ev3-pixy2/fit_coupon.stl
40.0 x 12.0 x 7.80
