eoinjordan/botbuilder/stl/lego/wheeled/hub_tpu_tt_d65.stl

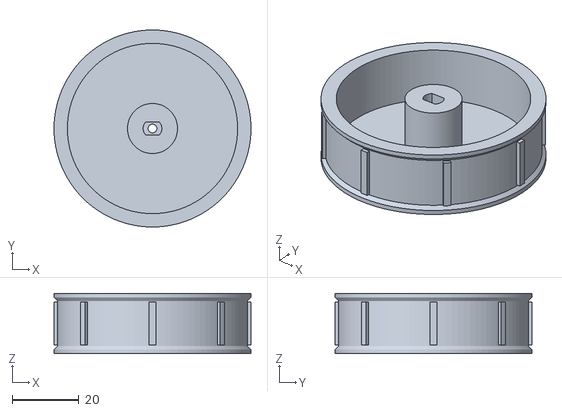
[picture p171: CAD file, 2026-11-11]
stl/lego/wheeled/hub_tpu_tt_d65.stl
59.0 x 59.0 x 18.0
