eoinjordan/botbuilder/stl/microduck-look/neck.stl

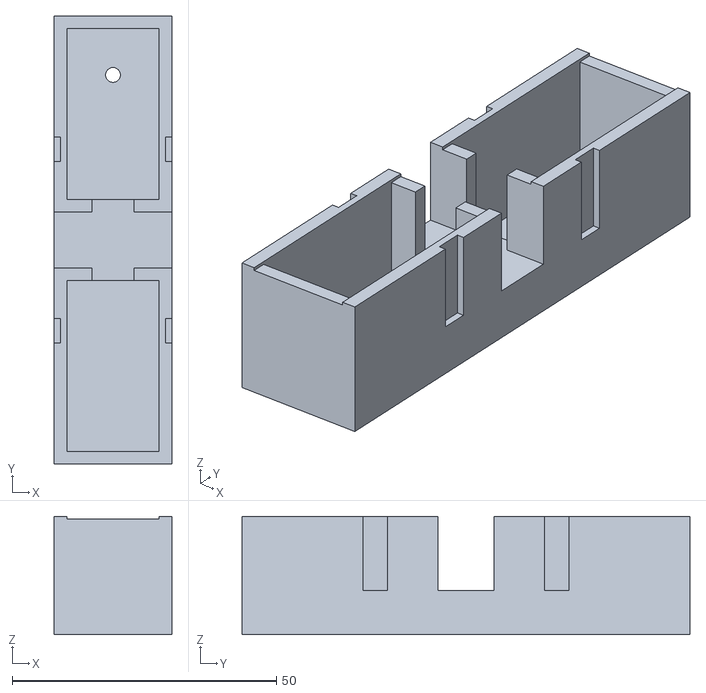
[picture p172: CAD file, 2026-11-11]
stl/microduck-look/neck.stl
22.3 x 84.8 x 22.4
