eoinjordan/botbuilder/stl/01_torso_unoq_cam_esp_eye.stl

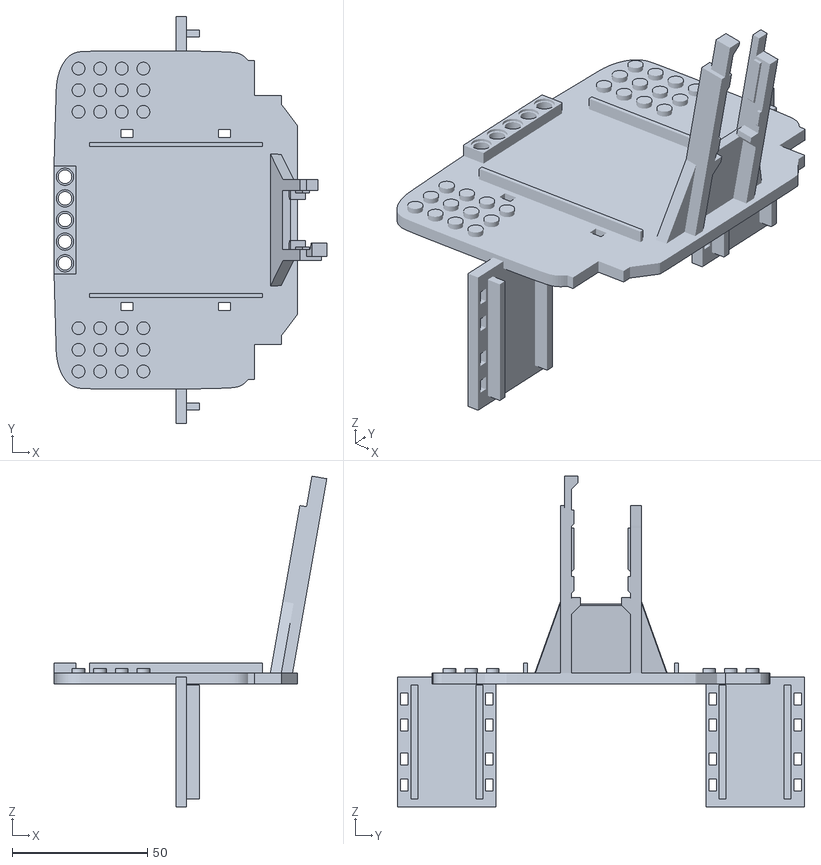
[picture p173: CAD file, 2026-11-12]
stl/01_torso_unoq_cam_esp_eye.stl
100.8 x 150.5 x 122.3
