eoinjordan/botbuilder/stl/lego/wheeled/driver_plate.stl

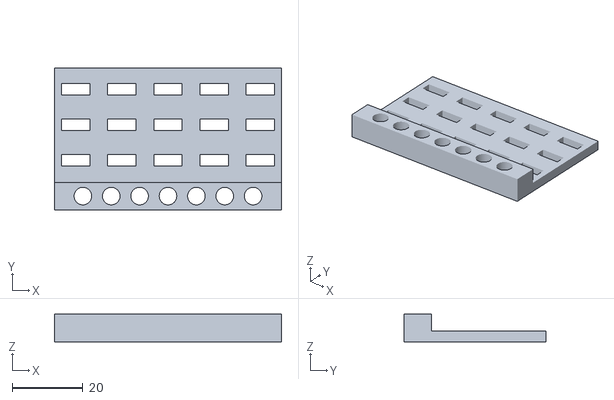
[picture p174: CAD file, 2026-11-11]
stl/lego/wheeled/driver_plate.stl
64.0 x 40.0 x 7.80
