eoinjordan/botbuilder/stl/microduck-look/body_right.stl

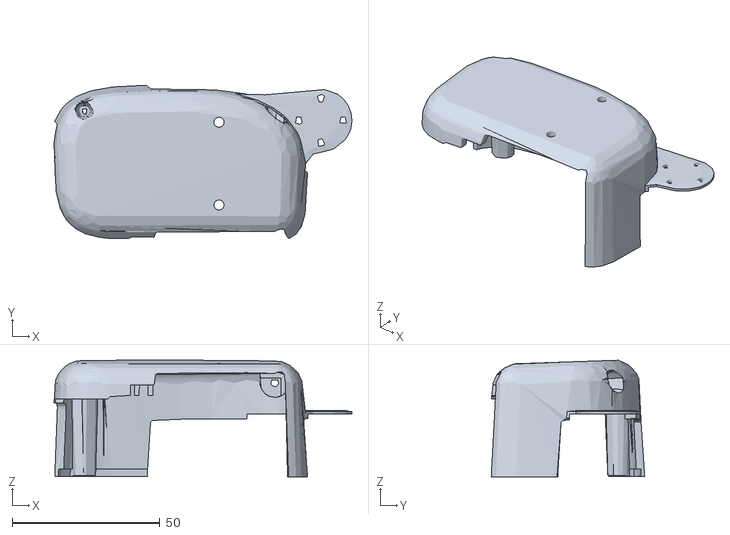
[picture p175: CAD file, 2026-11-11]
stl/microduck-look/body_right.stl
100.9 x 52.0 x 39.5
