eoinjordan/botbuilder/stl/head_tilt_cradle_esp_eye.stl

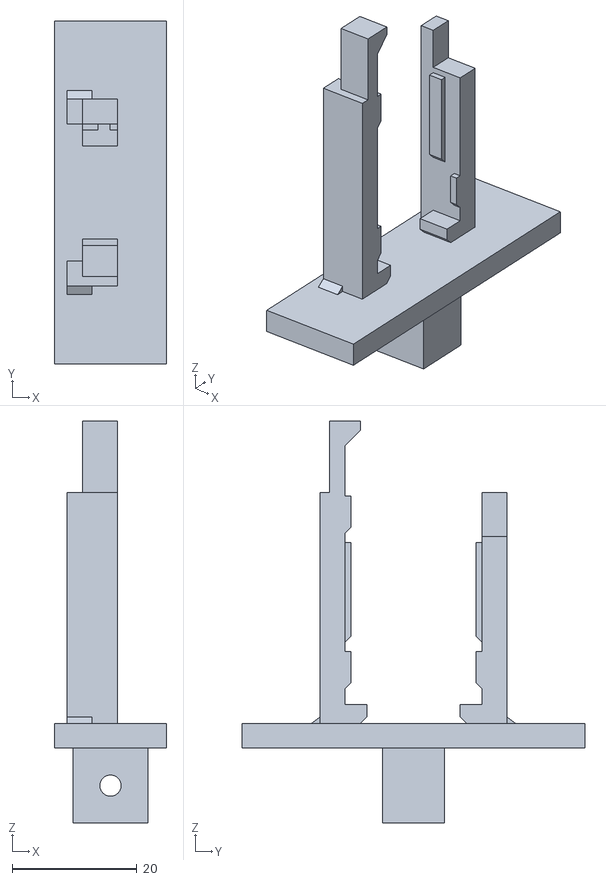
[picture p176: CAD file, 2026-11-12]
stl/head_tilt_cradle_esp_eye.stl
18.0 x 55.0 x 64.5
