eoinjordan/botbuilder/stl/lego/wheeled/fit_servo_cradle.stl

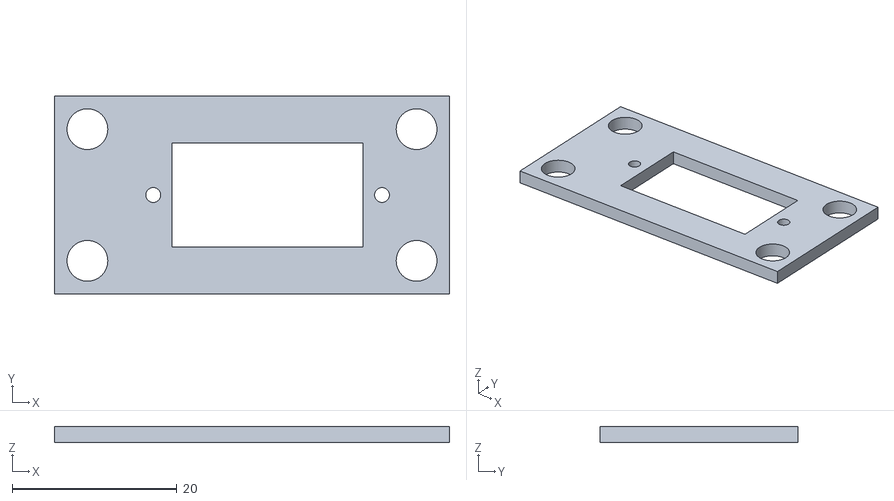
[picture p177: CAD file, 2026-11-11]
stl/lego/wheeled/fit_servo_cradle.stl
48.0 x 24.0 x 2.00
