eoinjordan/botbuilder/stl/microduck-look/fit_SR311.stl

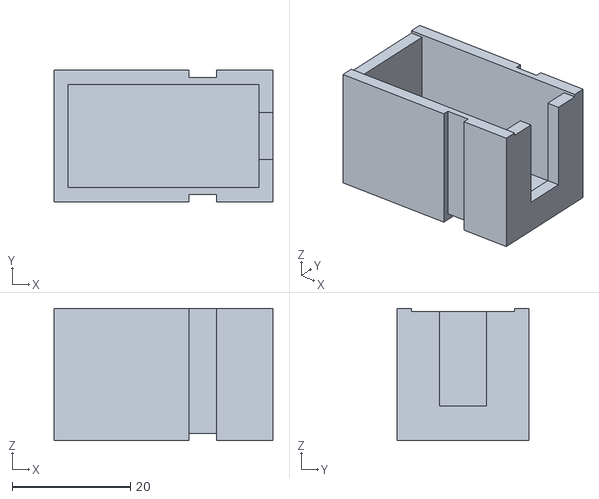
[picture p178: CAD file, 2026-11-11]
stl/microduck-look/fit_SR311.stl
37.1 x 22.3 x 22.4
