eoinjordan/botbuilder/stl/01_torso_unoq_eyes_above_esp_eye.stl

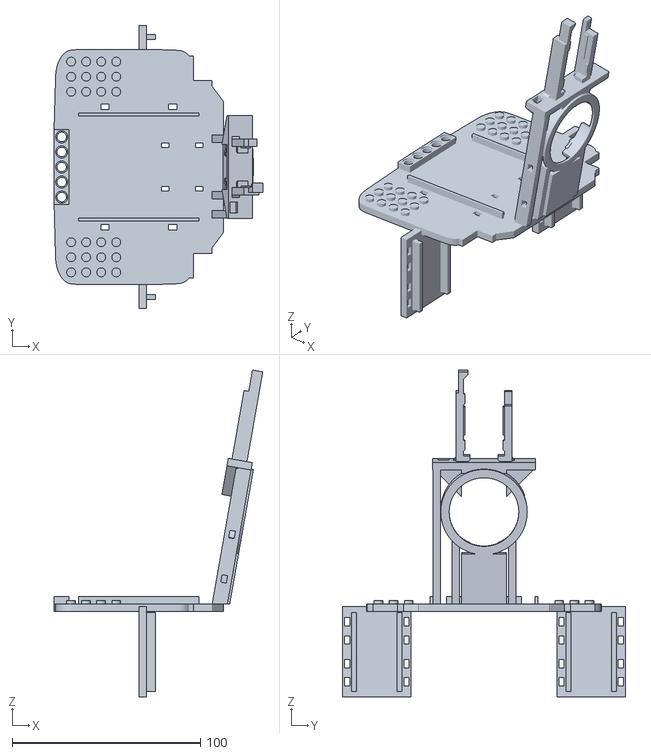
[picture p179: CAD file, 2026-11-12]
stl/01_torso_unoq_eyes_above_esp_eye.stl
110.9 x 150.5 x 173.8
