eoinjordan/botbuilder/stl/lego/wheeled/hub_tpu_cross_d43.stl

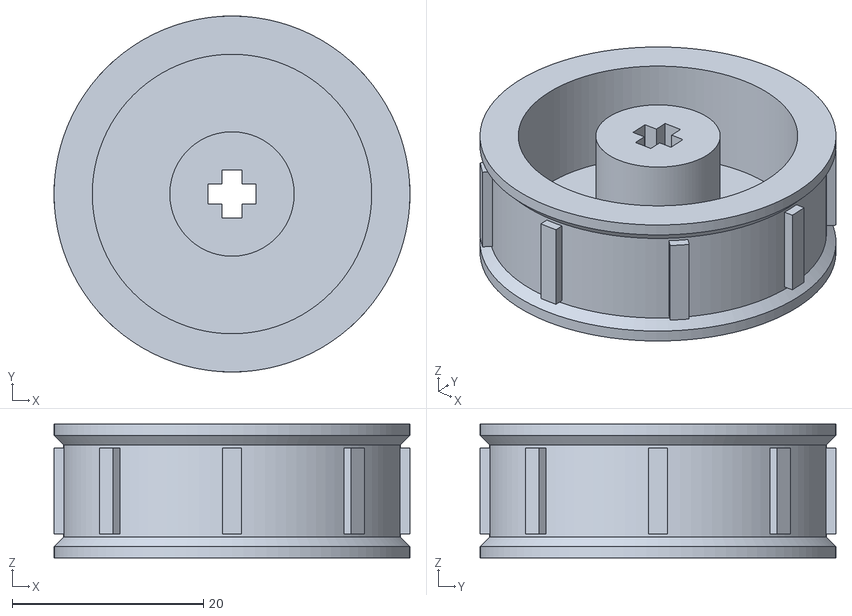
[picture p180: CAD file, 2026-11-11]
stl/lego/wheeled/hub_tpu_cross_d43.stl
37.2 x 37.2 x 14.0
