eoinjordan/botbuilder/stl/microduck-look/fit_horn_M5_180.stl

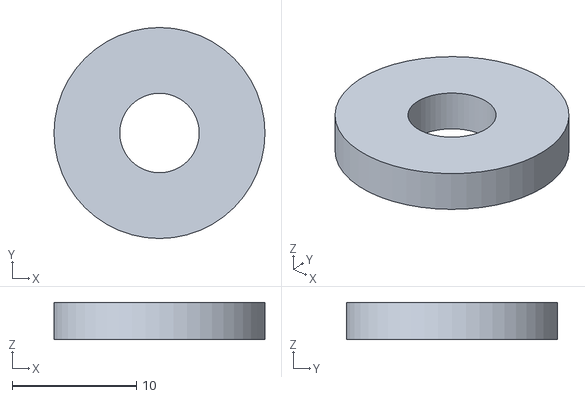
[picture p181: CAD file, 2026-11-11]
stl/microduck-look/fit_horn_M5_180.stl
17.0 x 17.0 x 3.00
