eoinjordan/botbuilder/stl/lego/wheeled/idler_hub.stl

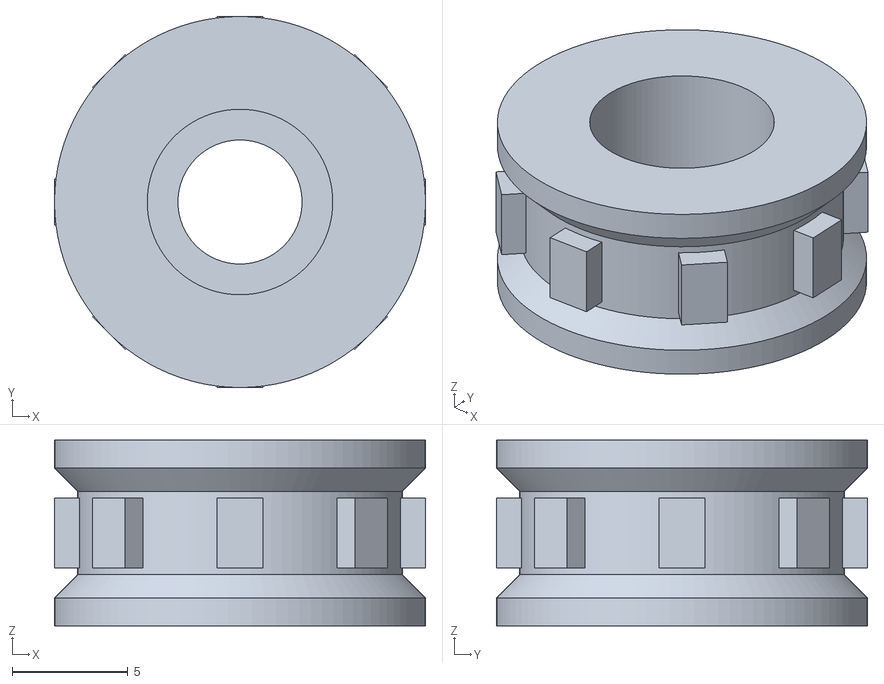
[picture p182: CAD file, 2026-11-11]
stl/lego/wheeled/idler_hub.stl
16.0 x 16.0 x 8.00
