eoinjordan/botbuilder/stl/microduck-look/fit_horn_SR311.stl

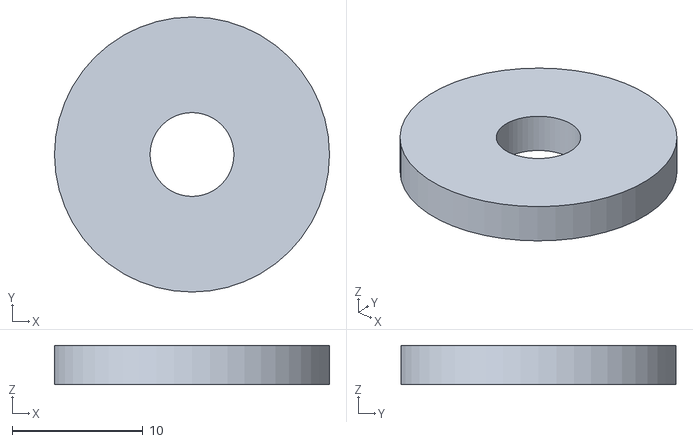
[picture p183: CAD file, 2026-11-11]
stl/microduck-look/fit_horn_SR311.stl
21.0 x 21.0 x 3.00
