eoinjordan/botbuilder/stl/lego/wheeled/hub_tpu_horn_d56.stl

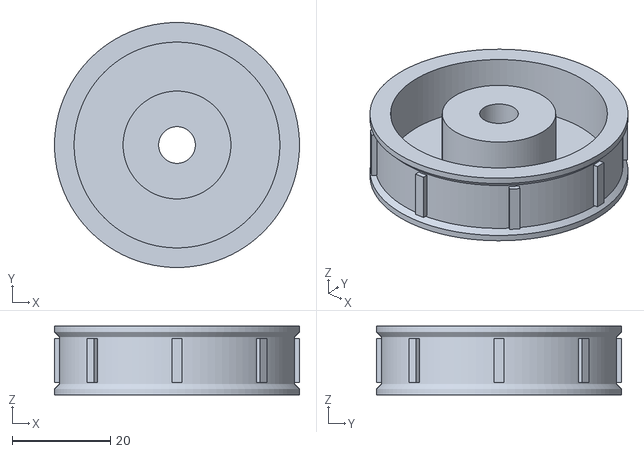
[picture p184: CAD file, 2026-11-11]
stl/lego/wheeled/hub_tpu_horn_d56.stl
50.0 x 50.0 x 14.0
