eoinjordan/botbuilder/stl/microduck-look/head_pitch_yoke.stl

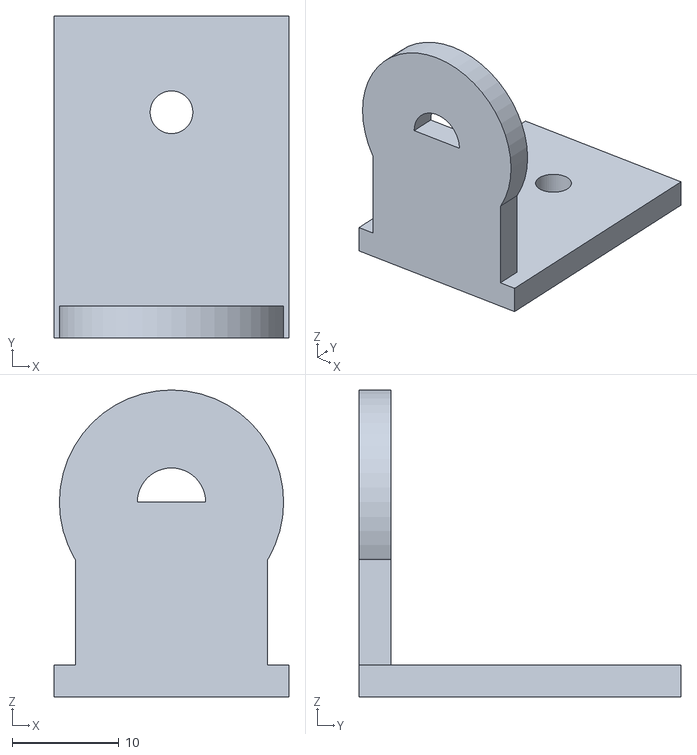
[picture p185: CAD file, 2026-11-11]
stl/microduck-look/head_pitch_yoke.stl
22.0 x 30.1 x 28.8
