eoinjordan/botbuilder/stl/microduck-look/left_thigh.stl

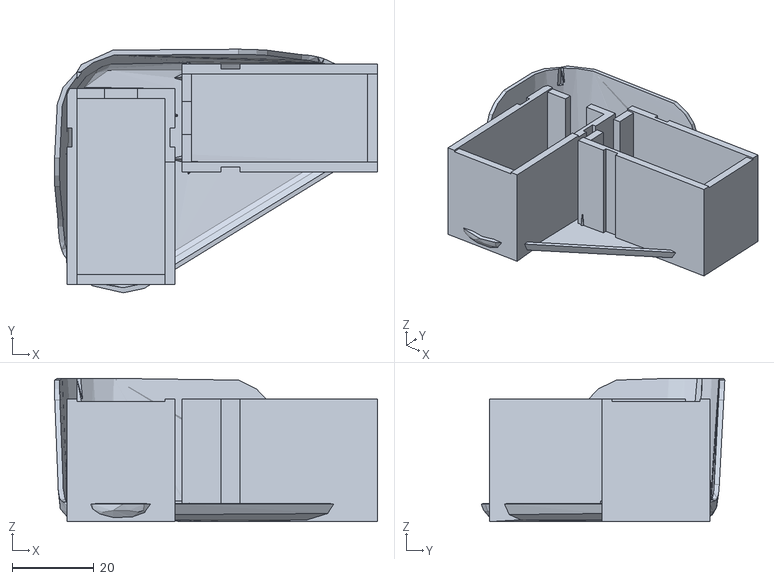
[picture p186: CAD file, 2026-11-11]
stl/microduck-look/left_thigh.stl
78.9 x 59.5 x 35.0
