eoinjordan/botbuilder/stl/01_torso_unoq_eyes_below_esp32cam.stl

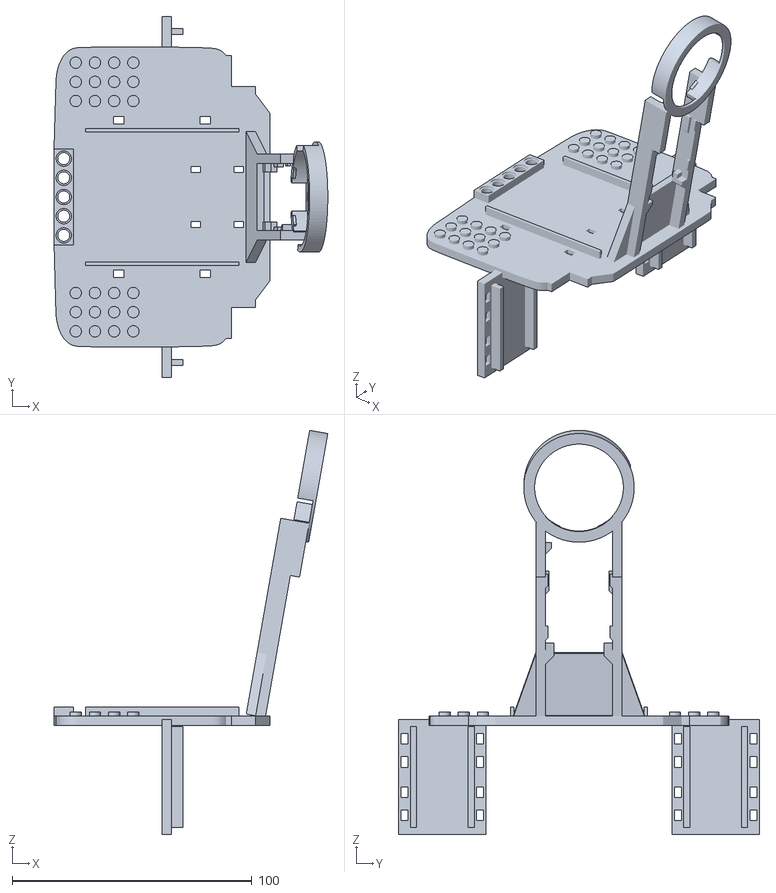
[picture p187: CAD file, 2026-11-11]
stl/01_torso_unoq_eyes_below_esp32cam.stl
114.1 x 150.5 x 168.6
