eoinjordan/botbuilder/stl/microduck-look/right_foot.stl

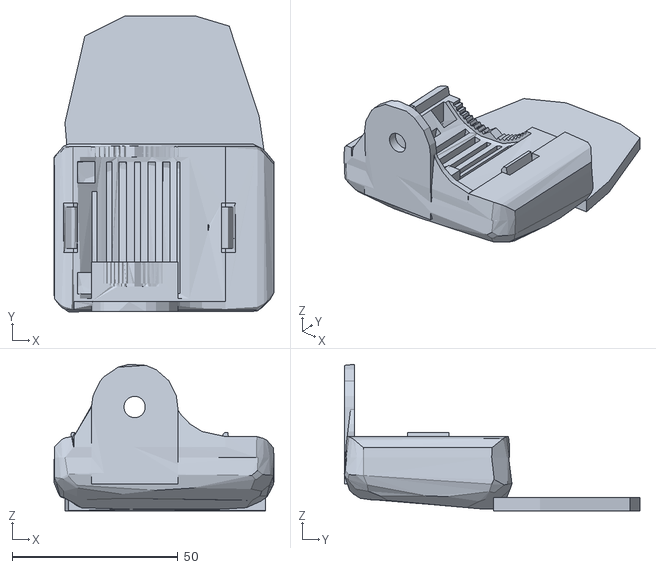
[picture p189: CAD file, 2026-11-11]
stl/microduck-look/right_foot.stl
66.3 x 89.1 x 44.1
