eoinjordan/botbuilder/stl/lego/wheeled/tip_ball_12p7.stl

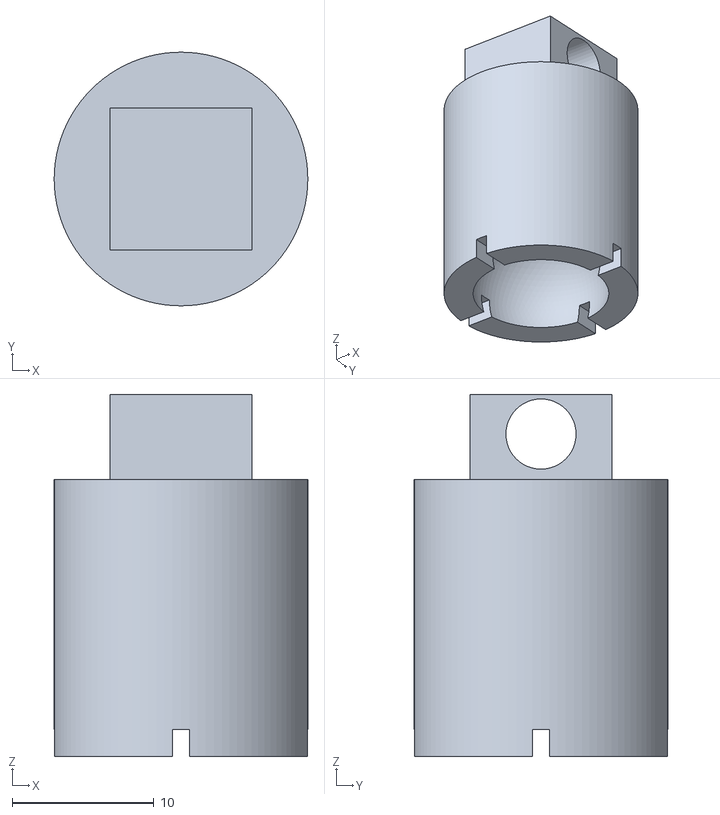
[picture p190: CAD file, 2026-11-11]
stl/lego/wheeled/tip_ball_12p7.stl
17.9 x 17.9 x 25.5
