eoinjordan/botbuilder/stl/microduck-look/left_hip_roll.stl

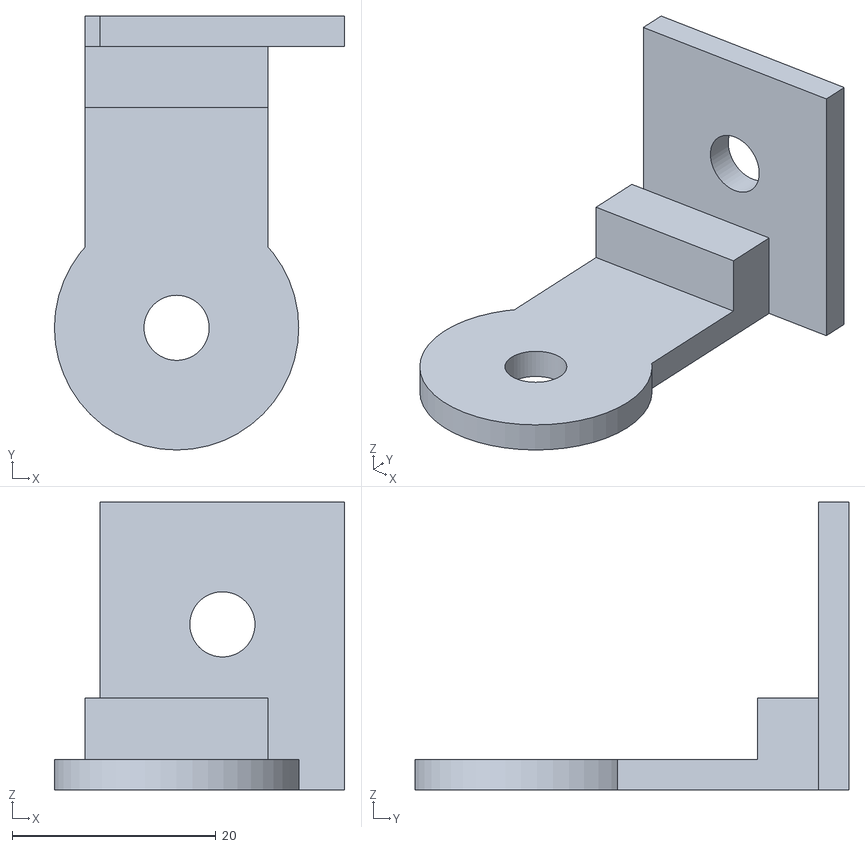
[picture p191: CAD file, 2026-11-11]
stl/microduck-look/left_hip_roll.stl
28.5 x 42.6 x 28.2
