eoinjordan/botbuilder/stl/lego/wheeled/wheel_band_tt_d65.stl

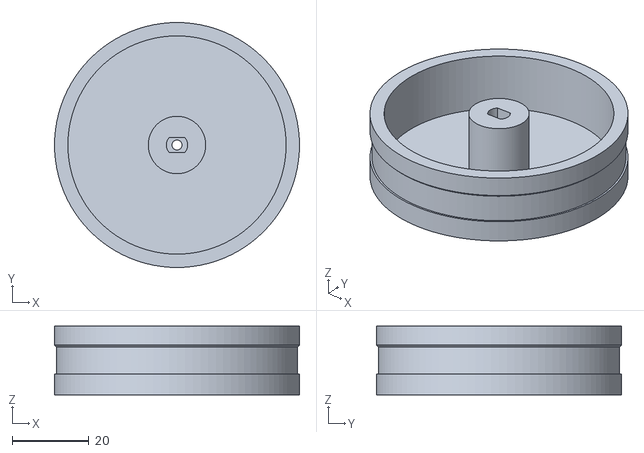
[picture p192: CAD file, 2026-11-11]
stl/lego/wheeled/wheel_band_tt_d65.stl
64.0 x 64.0 x 18.0
