eoinjordan/botbuilder/stl/microduck-look/right_hip_yaw.stl

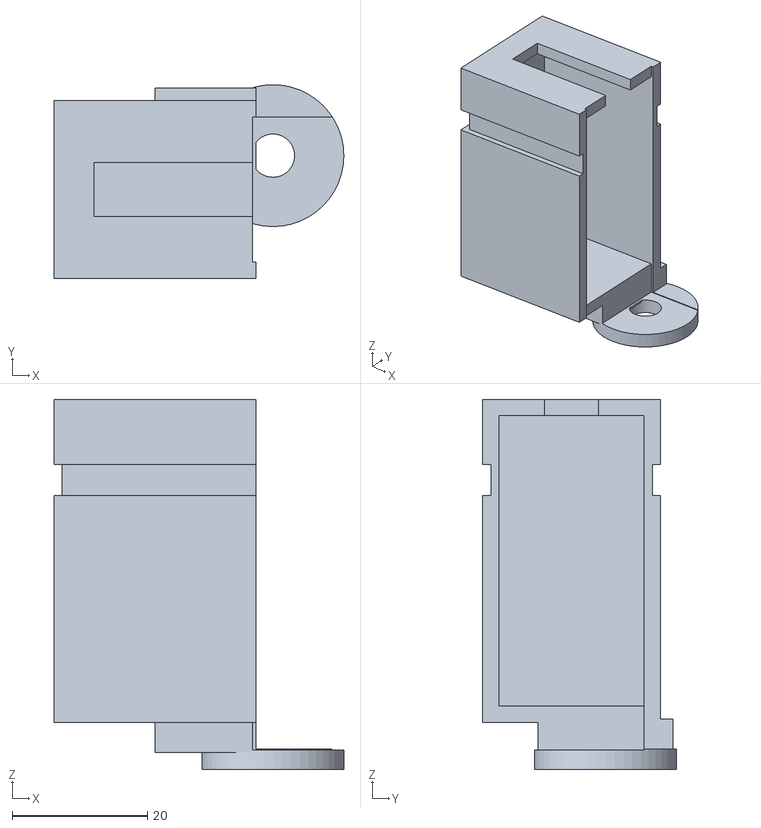
[picture p193: CAD file, 2026-11-11]
stl/microduck-look/right_hip_yaw.stl
42.9 x 28.6 x 54.8
