eoinjordan/botbuilder/stl/right_shin_flat_foot.stl

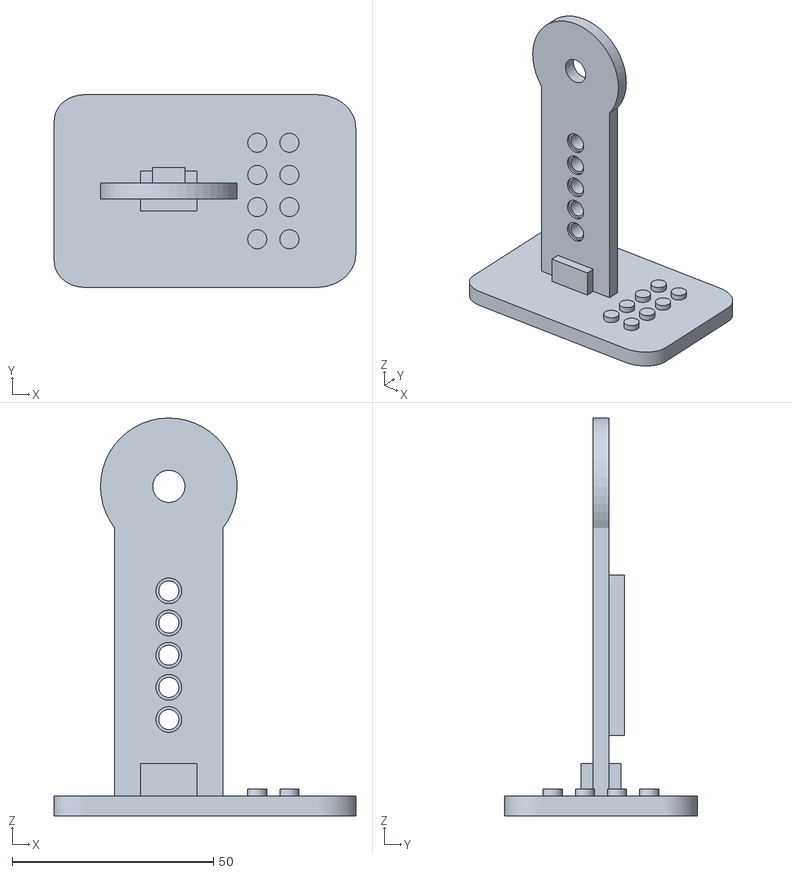
[picture p194: CAD file, 2026-11-11]
stl/right_shin_flat_foot.stl
75.0 x 48.0 x 99.0
