eoinjordan/botbuilder/stl/fit_round_display.stl

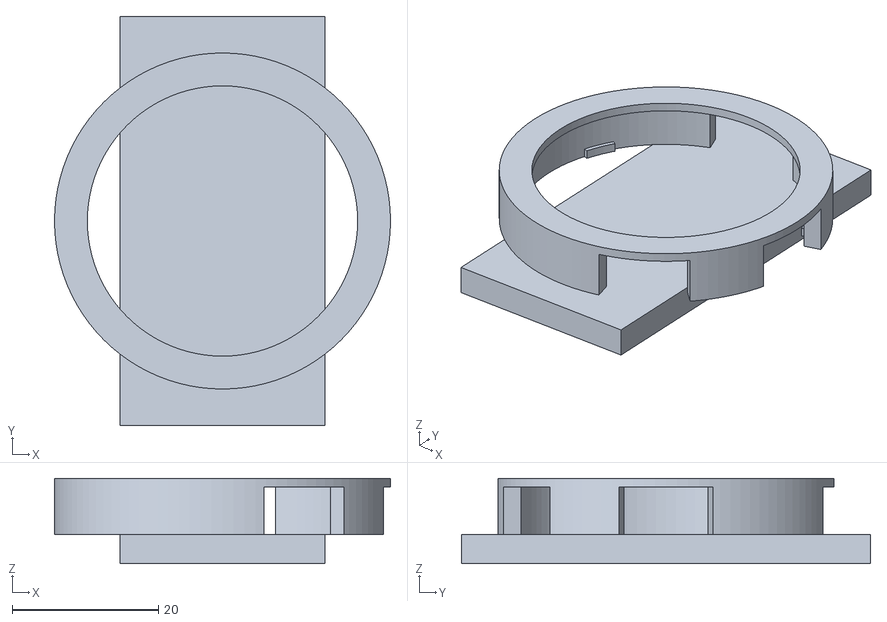
[picture p195: CAD file, 2026-11-11]
stl/fit_round_display.stl
46.0 x 56.0 x 11.7
