eoinjordan/botbuilder/stl/lego/wheeled/fit_bore_cross.stl

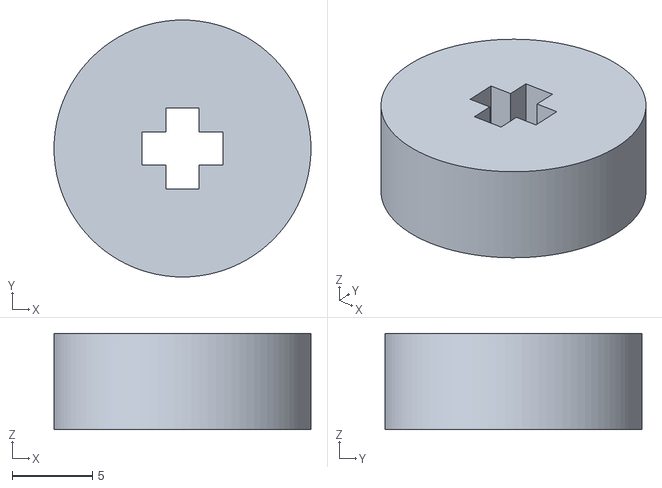
[picture p196: CAD file, 2026-11-11]
stl/lego/wheeled/fit_bore_cross.stl
16.0 x 16.0 x 6.00
