eoinjordan/botbuilder/stl/microduck-look/head_top.stl

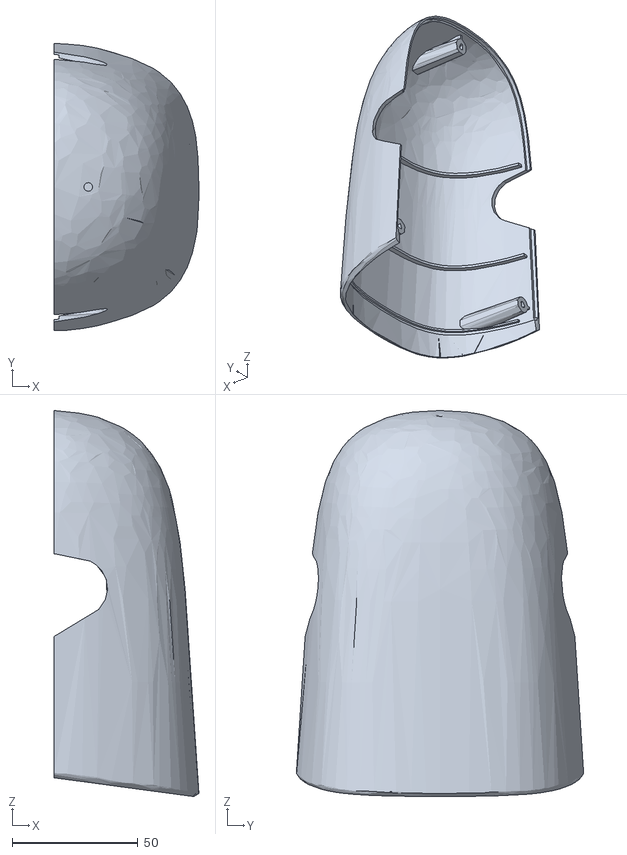
[picture p197: CAD file, 2026-11-11]
stl/microduck-look/head_top.stl
57.6 x 114.1 x 153.4
