eoinjordan/botbuilder/stl/fit_SR311.stl

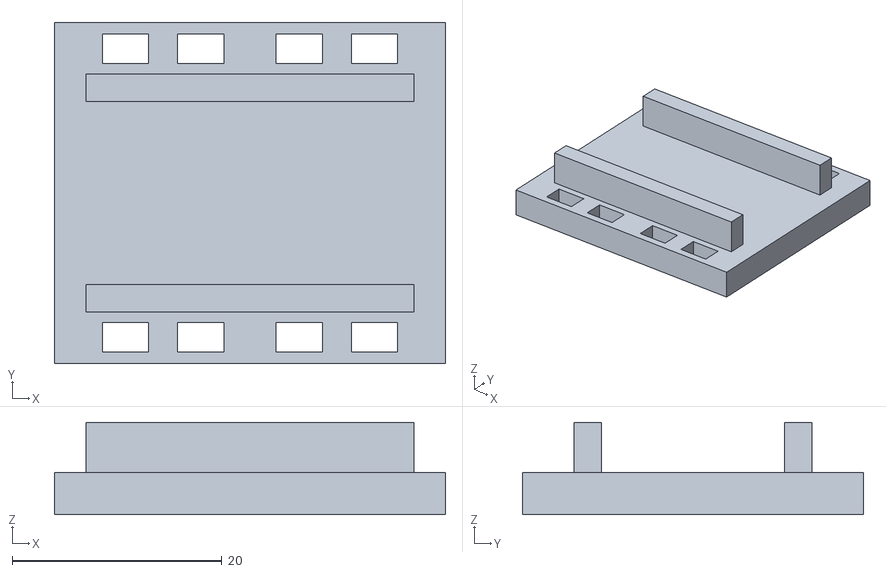
[picture p198: CAD file, 2026-11-11]
stl/fit_SR311.stl
37.3 x 32.5 x 8.80
