eoinjordan/botbuilder/stl/lego/wheeled/wheel_band_cross_d56.stl

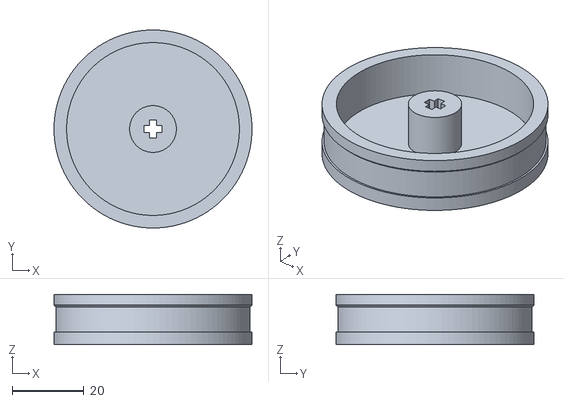
[picture p199: CAD file, 2026-11-11]
stl/lego/wheeled/wheel_band_cross_d56.stl
55.0 x 55.0 x 14.0
