eoinjordan/botbuilder/stl/microduck-look/head_yaw_carrier.stl

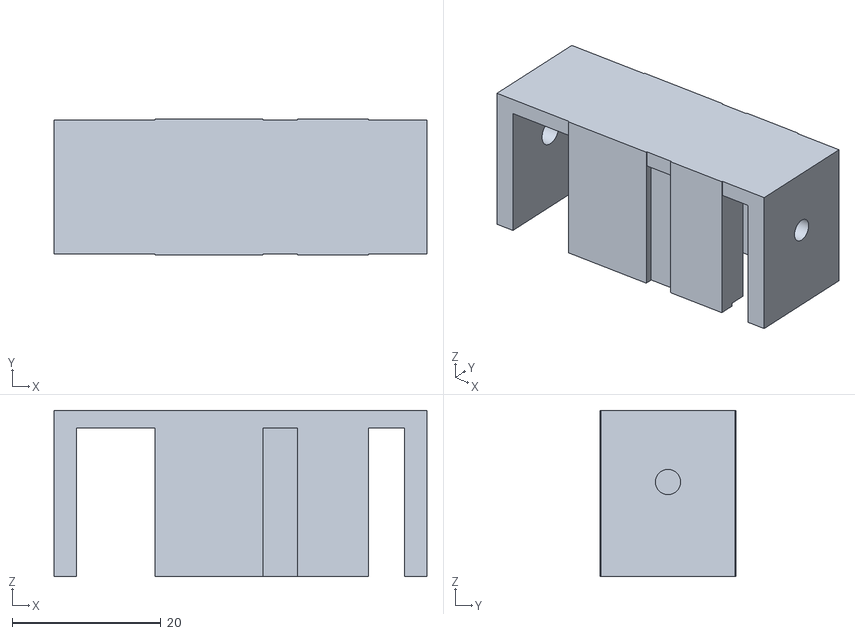
[picture p200: CAD file, 2026-11-11]
stl/microduck-look/head_yaw_carrier.stl
50.2 x 18.3 x 22.4
