eoinjordan/botbuilder/stl/fit_SR431.stl

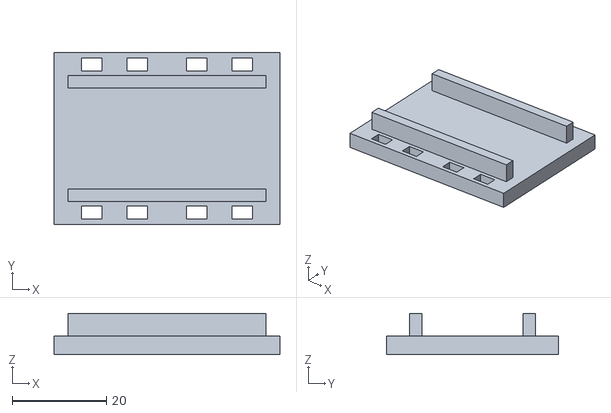
[picture p201: CAD file, 2026-11-11]
stl/fit_SR431.stl
48.0 x 36.5 x 8.80
