eoinjordan/botbuilder/stl/lego/wheeled/wheel_solid_horn_d56.stl

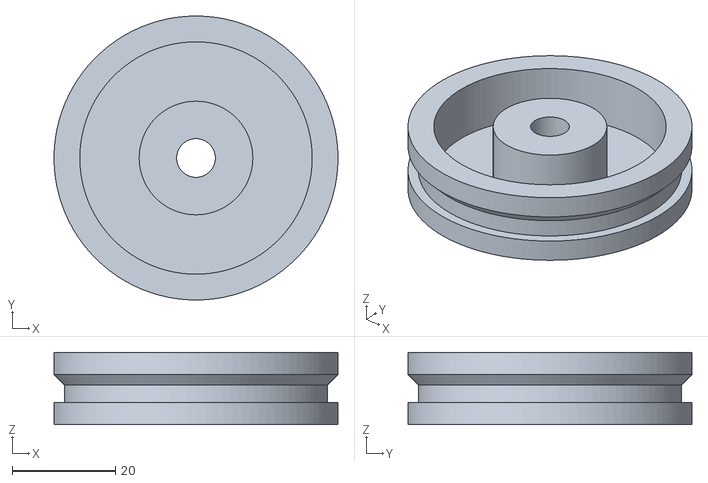
[picture p202: CAD file, 2026-11-11]
stl/lego/wheeled/wheel_solid_horn_d56.stl
55.0 x 55.0 x 14.0
