eoinjordan/botbuilder/stl/microduck-look/fit_SR431.stl

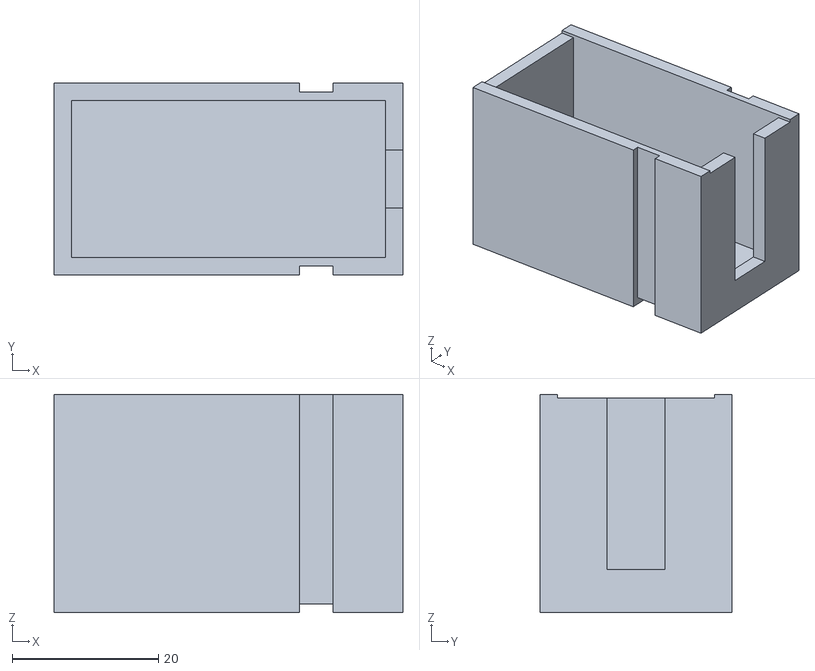
[picture p203: CAD file, 2026-11-11]
stl/microduck-look/fit_SR431.stl
47.8 x 26.3 x 29.9
