eoinjordan/botbuilder/stl/head_tilt_cradle_stack_camera_forward.stl

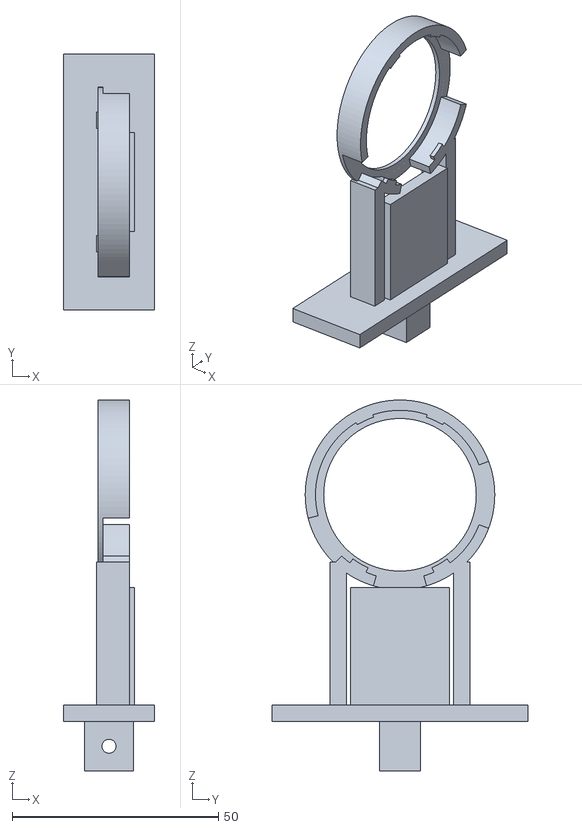
[picture p204: CAD file, 2026-11-11]
stl/head_tilt_cradle_stack_camera_forward.stl
22.0 x 62.0 x 90.0
