eoinjordan/botbuilder/stl/microduck-look/left_shin.stl

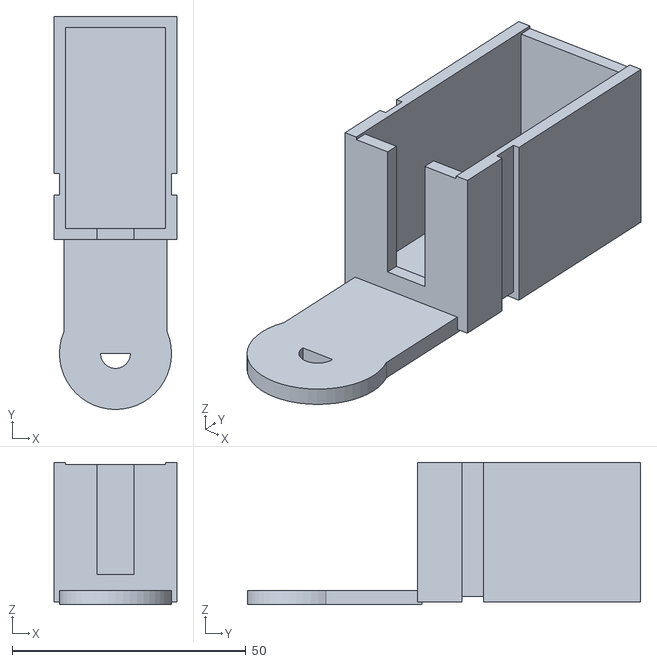
[picture p206: CAD file, 2026-11-11]
stl/microduck-look/left_shin.stl
26.3 x 84.2 x 30.5
