eoinjordan/botbuilder/stl/fit_horn_drill_blank.stl

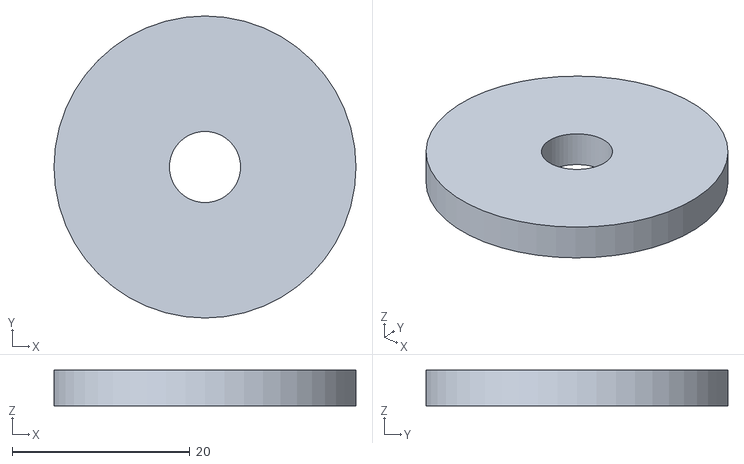
[picture p207: CAD file, 2026-11-11]
stl/fit_horn_drill_blank.stl
34.0 x 34.0 x 4.00
