eoinjordan/botbuilder/stl/lego/wheeled/servo_cradle_print_2.stl

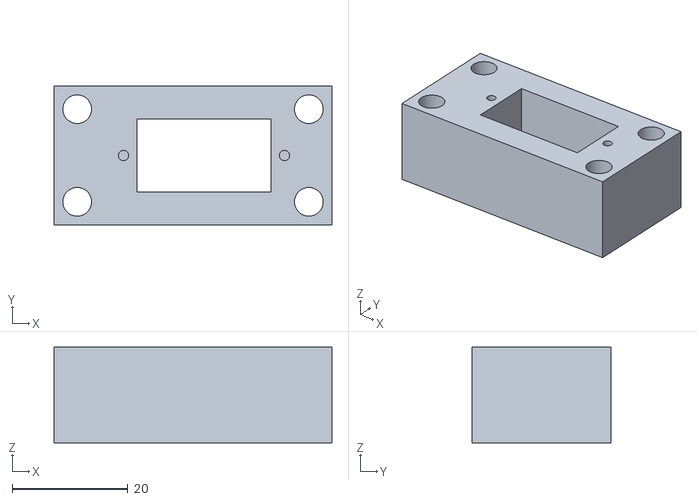
[picture p208: CAD file, 2026-11-11]
stl/lego/wheeled/servo_cradle_print_2.stl
48.0 x 24.0 x 16.5
