eoinjordan/botbuilder/stl/microduck-look/fit_eye_esp_eye.stl

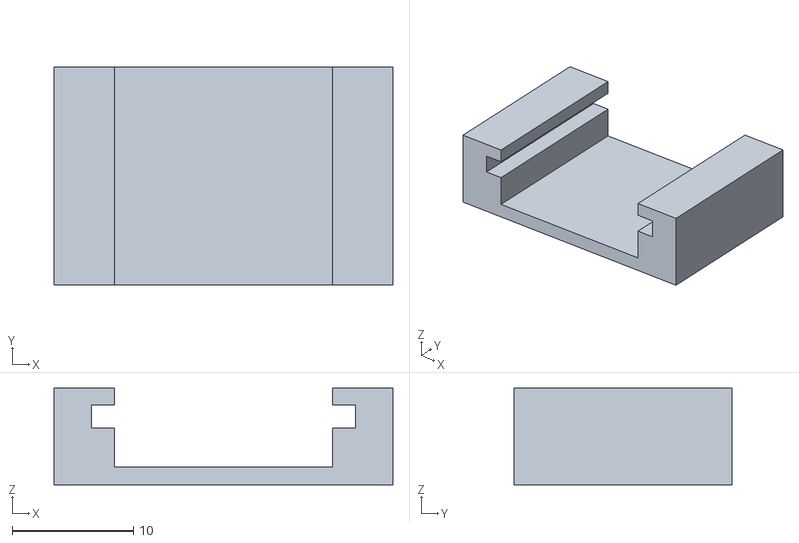
[picture p209: CAD file, 2026-11-11]
stl/microduck-look/fit_eye_esp_eye.stl
28.0 x 18.0 x 8.00
