eoinjordan/botbuilder/stl/left_thigh_knee_cradle.stl

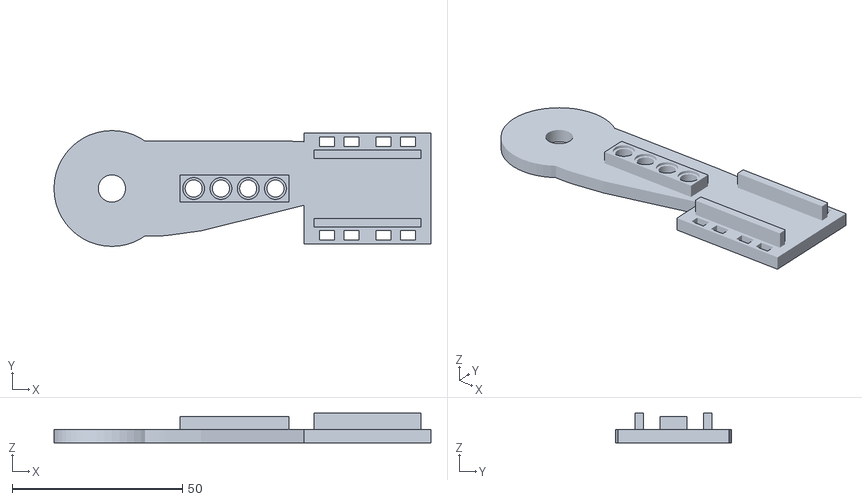
[picture p210: CAD file, 2026-11-11]
stl/left_thigh_knee_cradle.stl
110.7 x 34.0 x 8.80
