eoinjordan/botbuilder/stl/lego/wheeled/wheel_band_cross_d43.stl

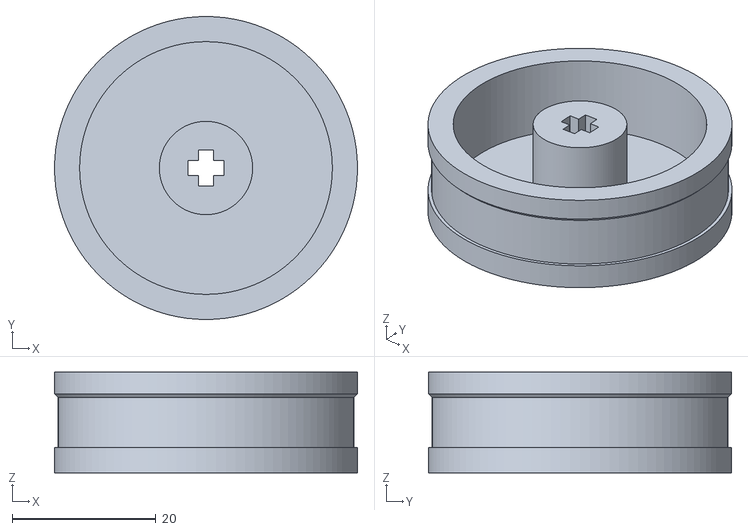
[picture p211: CAD file, 2026-11-11]
stl/lego/wheeled/wheel_band_cross_d43.stl
42.2 x 42.2 x 14.0
