eoinjordan/botbuilder/stl/head_pixy_plate_pixy1.stl

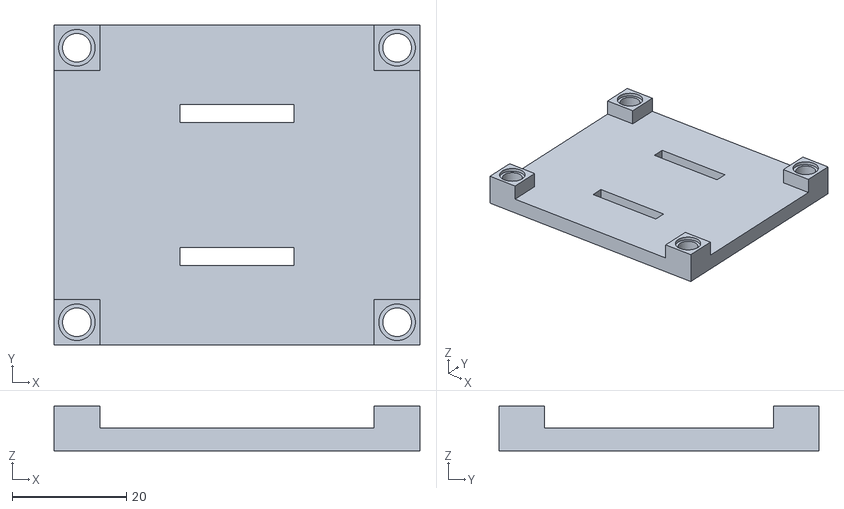
[picture p212: CAD file, 2026-11-11]
stl/head_pixy_plate_pixy1.stl
64.0 x 56.0 x 7.80
