eoinjordan/botbuilder/stl/lego/wheeled/tt_cradle_print_2.stl

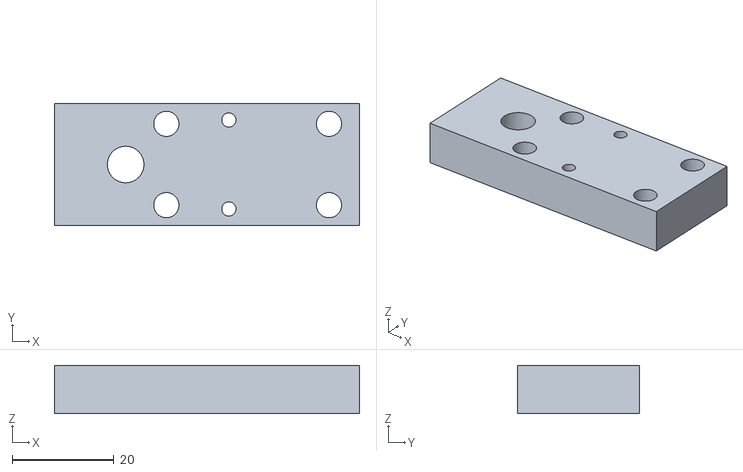
[picture p213: CAD file, 2026-11-11]
stl/lego/wheeled/tt_cradle_print_2.stl
60.0 x 24.0 x 9.50
