eoinjordan/botbuilder/stl/lego/wheeled/tyre_tpu_d43.stl

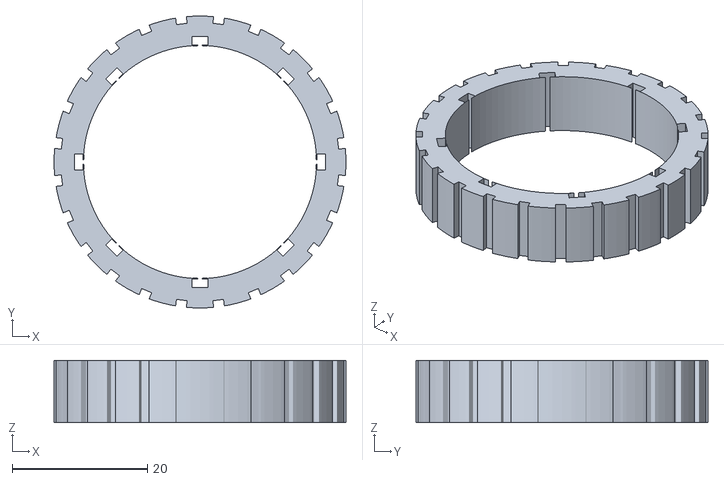
[picture p214: CAD file, 2026-11-11]
stl/lego/wheeled/tyre_tpu_d43.stl
43.2 x 43.2 x 9.20
