eoinjordan/botbuilder/stl/right_hip_roll_pitch_yoke.stl

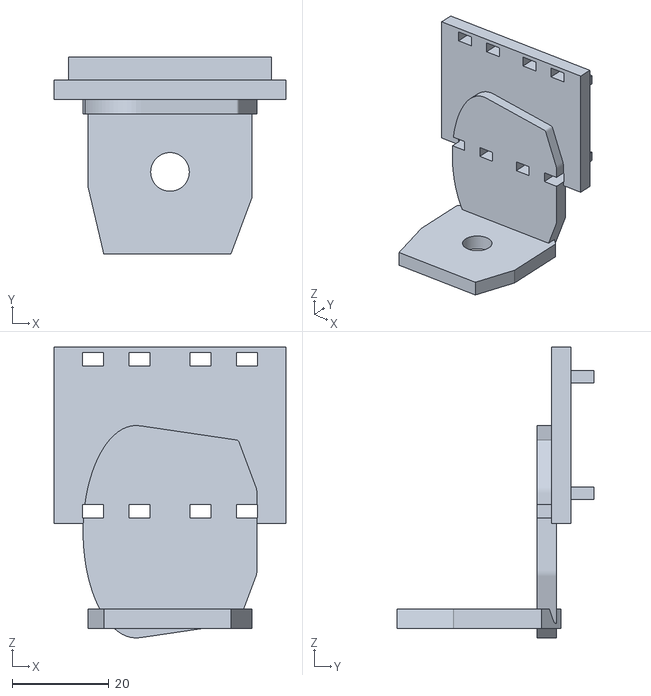
[picture p215: CAD file, 2026-11-11]
stl/right_hip_roll_pitch_yoke.stl
48.0 x 40.8 x 60.2
