eoinjordan/botbuilder/stl/01_torso_unoq_pan_head.stl

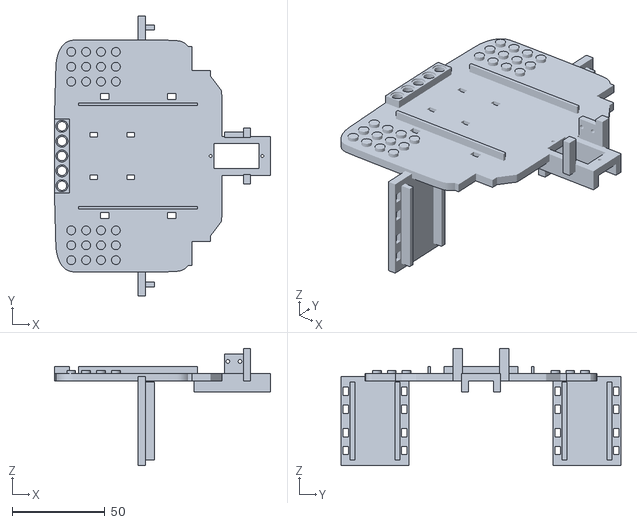
[picture p216: CAD file, 2026-11-11]
stl/01_torso_unoq_pan_head.stl
116.2 x 150.5 x 63.0
