eoinjordan/botbuilder/stl/lego/wheeled/fit_tt_cradle.stl

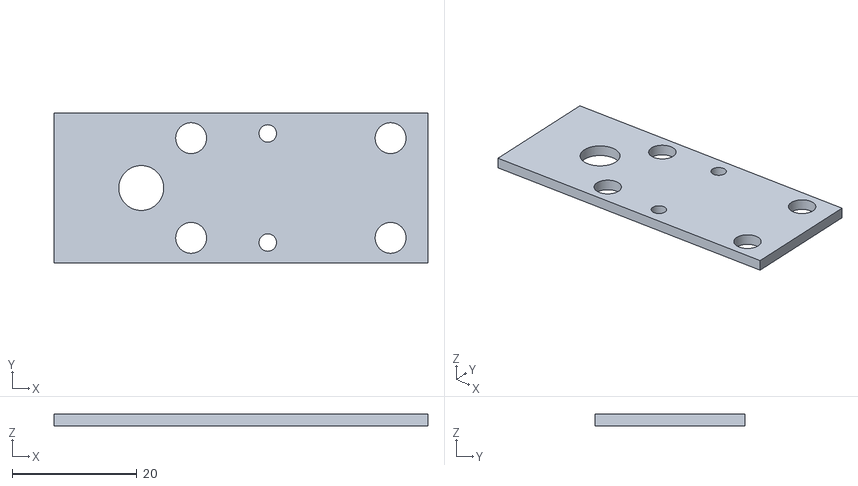
[picture p217: CAD file, 2026-11-11]
stl/lego/wheeled/fit_tt_cradle.stl
60.0 x 24.0 x 2.00
