eoinjordan/botbuilder/stl/head_tilt_cradle_esp32_s3_eye.stl

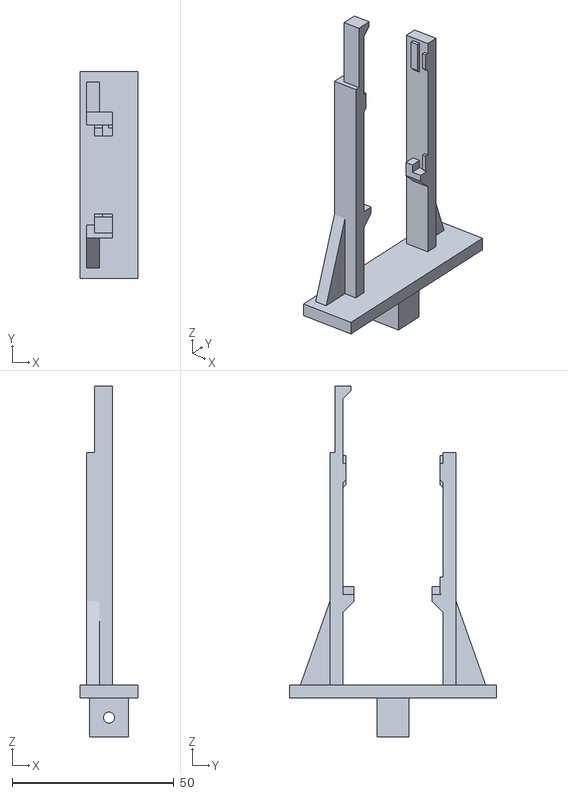
[picture p218: CAD file, 2026-11-11]
stl/head_tilt_cradle_esp32_s3_eye.stl
18.0 x 64.0 x 108.5
