eoinjordan/botbuilder/stl/lego/wheeled/tyre_tpu_d65.stl

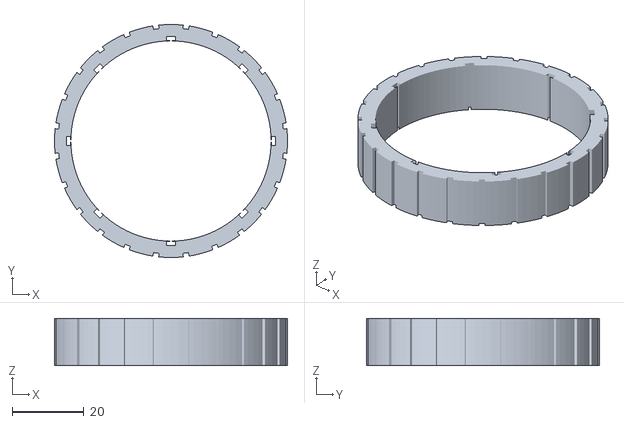
[picture p219: CAD file, 2026-11-11]
stl/lego/wheeled/tyre_tpu_d65.stl
65.0 x 65.0 x 13.2
