eoinjordan/botbuilder/stl/microduck-look/beak_jaw.stl

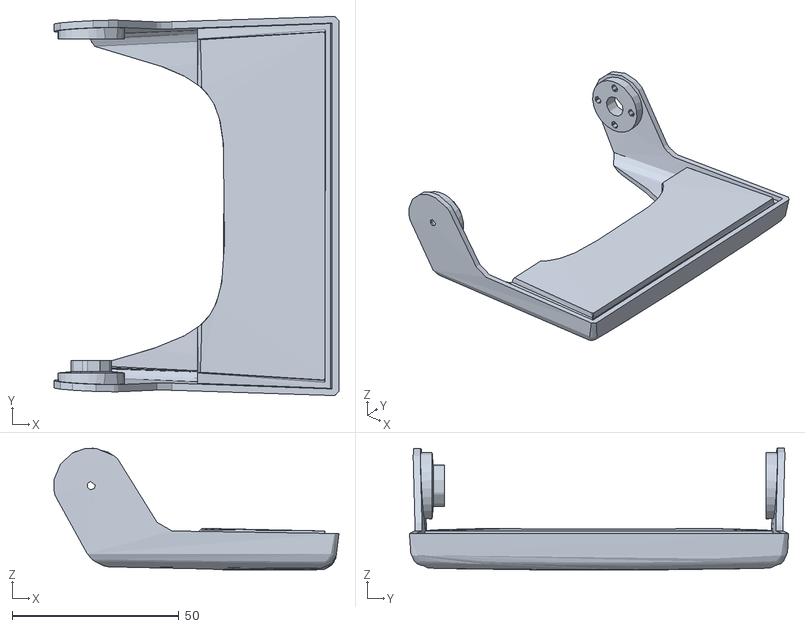
[picture p220: CAD file, 2026-11-11]
stl/microduck-look/beak_jaw.stl
85.4 x 113.6 x 36.5
