eoinjordan/botbuilder/stl/head_tilt_cradle_esp32cam.stl

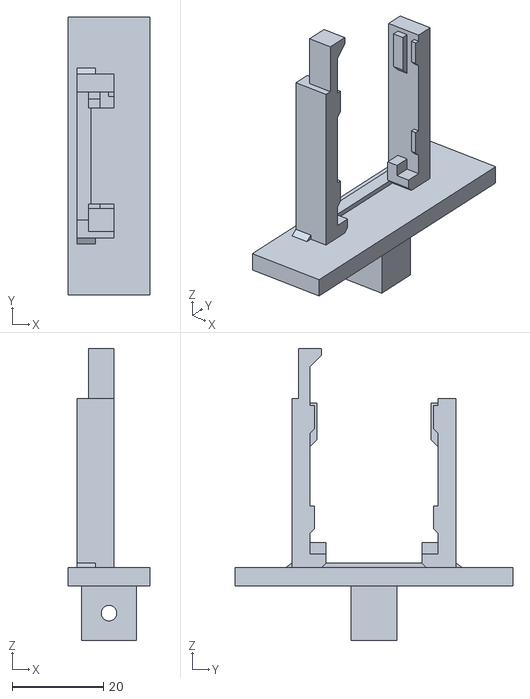
[picture p221: CAD file, 2026-11-11]
stl/head_tilt_cradle_esp32cam.stl
18.0 x 61.0 x 64.0
