eoinjordan/botbuilder/stl/lego/wheeled/tip_skid.stl

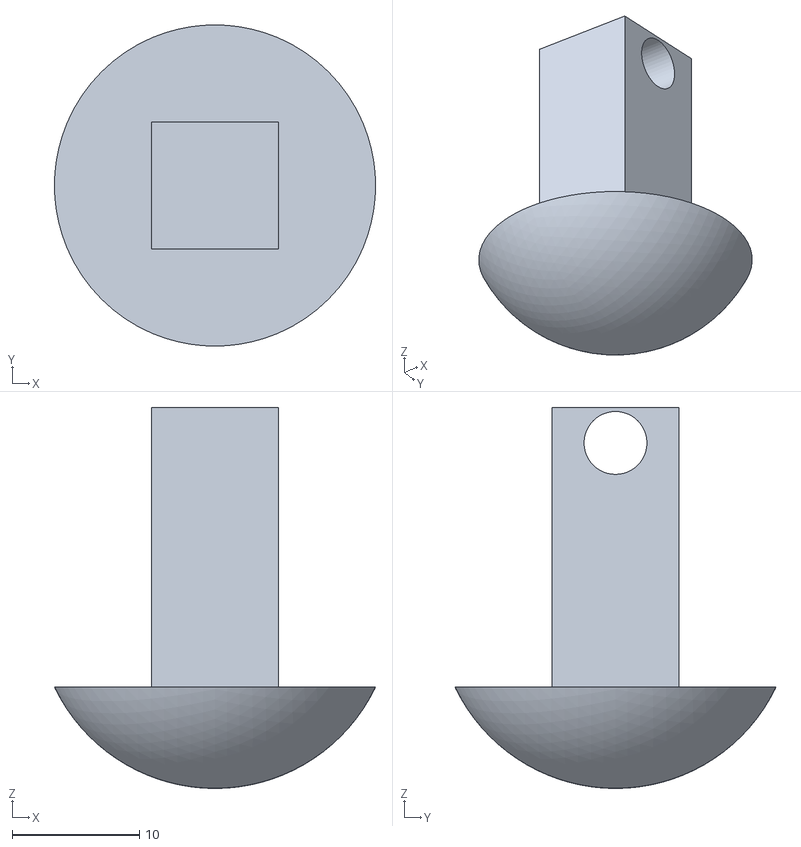
[picture p222: CAD file, 2026-11-11]
stl/lego/wheeled/tip_skid.stl
25.3 x 25.3 x 30.0
