eoinjordan/botbuilder/stl/microduck-look/head_face.stl

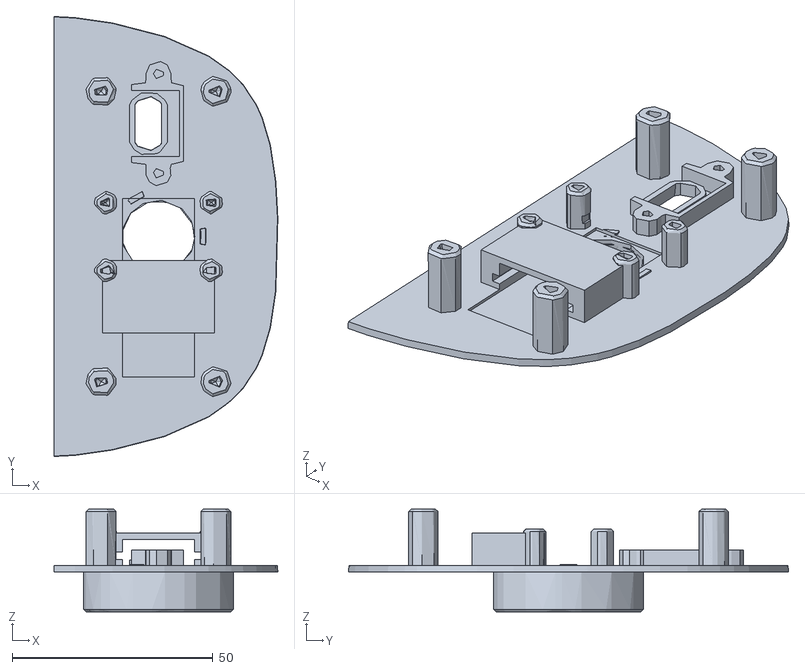
[picture p223: CAD file, 2026-11-11]
stl/microduck-look/head_face.stl
55.7 x 109.6 x 25.6
