eoinjordan/botbuilder/stl/fit_lego_compatible_coupon.stl

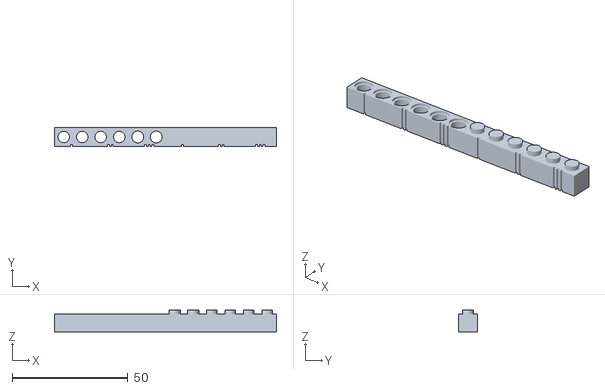
[picture p224: CAD file, 2026-11-11]
stl/fit_lego_compatible_coupon.stl
96.0 x 8.00 x 9.50
