eoinjordan/botbuilder/stl/lego/wheeled/post_d43.stl

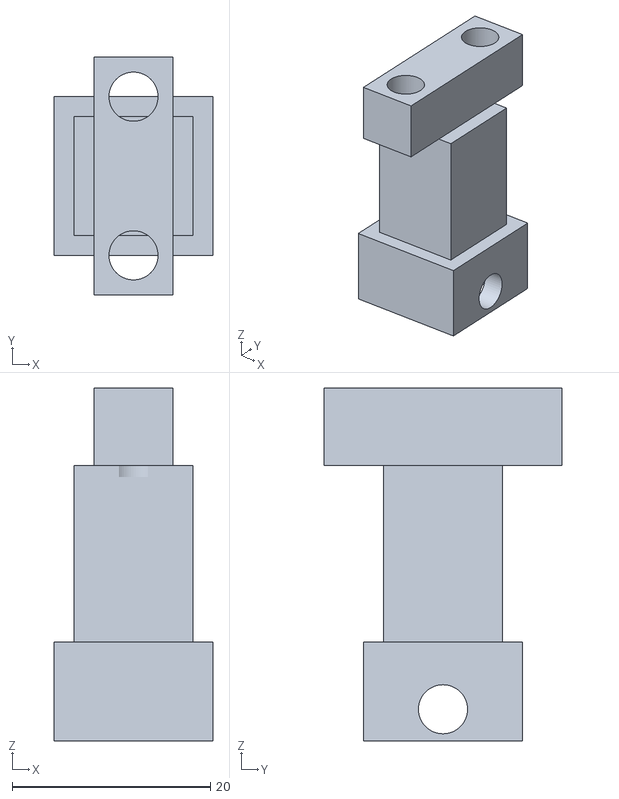
[picture p225: CAD file, 2026-11-11]
stl/lego/wheeled/post_d43.stl
16.0 x 24.0 x 35.6
