eoinjordan/botbuilder/stl/microduck-look/body_left.stl

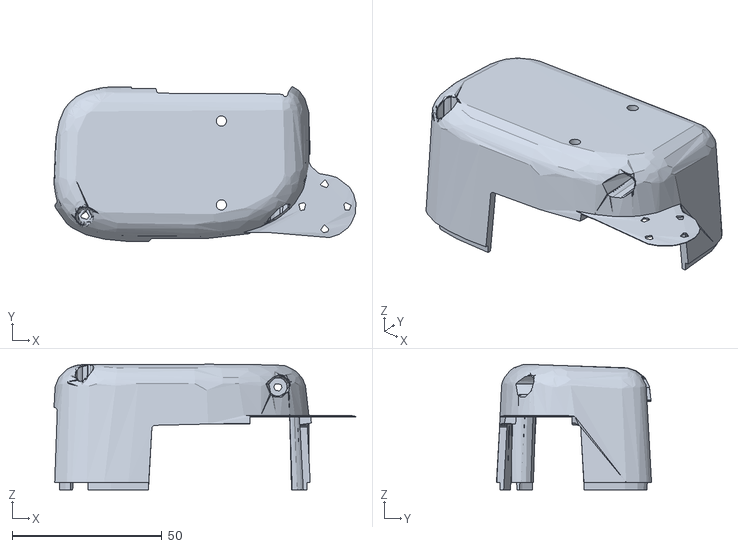
[picture p226: CAD file, 2026-11-11]
stl/microduck-look/body_left.stl
100.8 x 51.8 x 41.9
