eoinjordan/botbuilder/stl/fit_sg90_cradle.stl

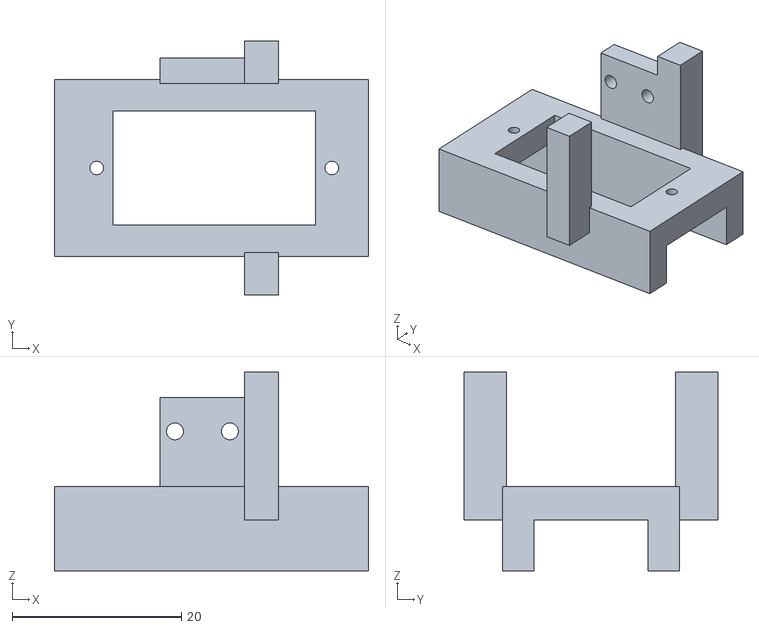
[picture p227: CAD file, 2026-11-11]
stl/fit_sg90_cradle.stl
37.2 x 30.0 x 23.5
