eoinjordan/botbuilder/stl/lego/wheeled/fit_bore_tt.stl

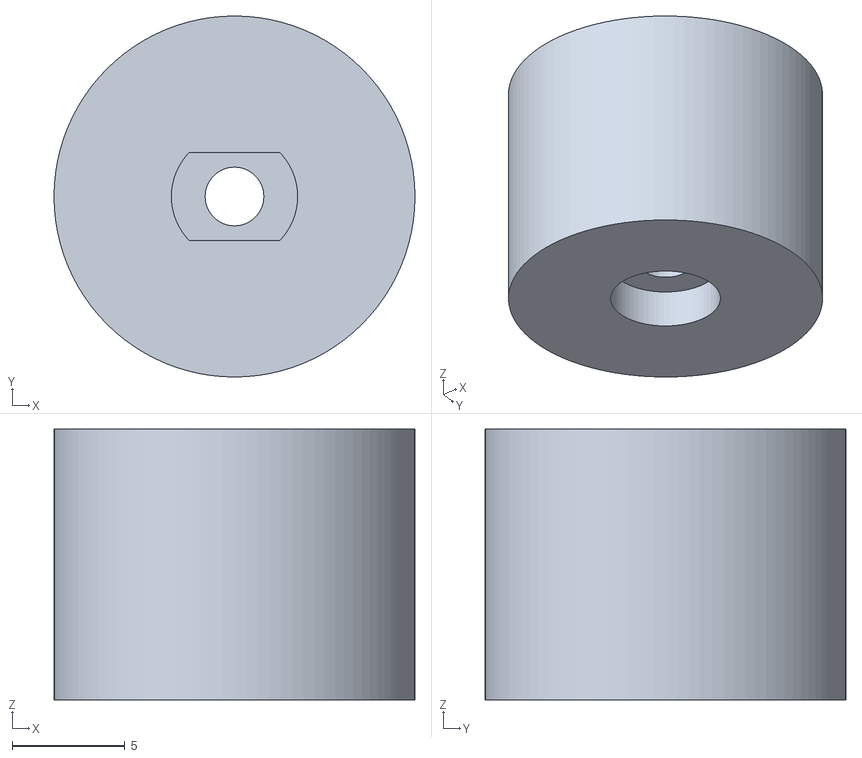
[picture p228: CAD file, 2026-11-11]
stl/lego/wheeled/fit_bore_tt.stl
16.0 x 16.0 x 12.0
