eoinjordan/botbuilder/stl/microduck-look/trunk_frame.stl

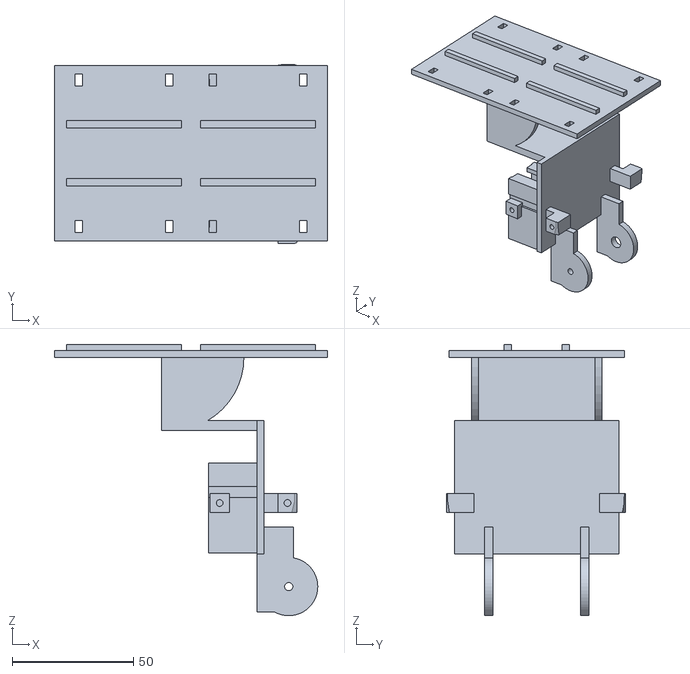
[picture p229: CAD file, 2026-11-11]
stl/microduck-look/trunk_frame.stl
112.7 x 73.9 x 112.0
