eoinjordan/botbuilder/stl/lego/wheeled/post_d65.stl

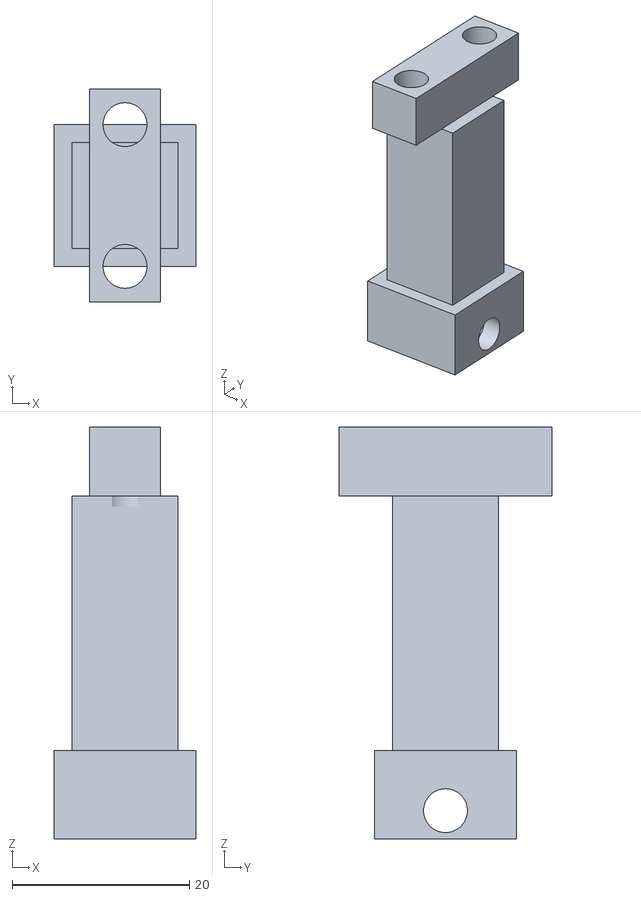
[picture p230: CAD file, 2026-11-11]
stl/lego/wheeled/post_d65.stl
16.0 x 24.0 x 46.5
