eoinjordan/botbuilder/stl/microduck-look/fit_M5_180.stl

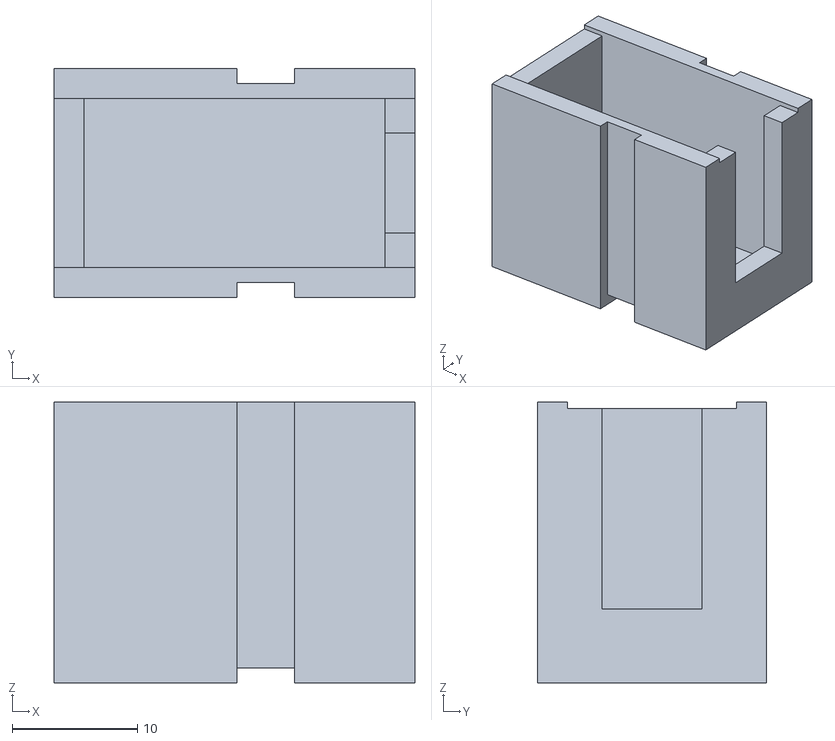
[picture p231: CAD file, 2026-11-11]
stl/microduck-look/fit_M5_180.stl
28.8 x 18.3 x 22.4
