eoinjordan/botbuilder/stl/head_pan_platform.stl

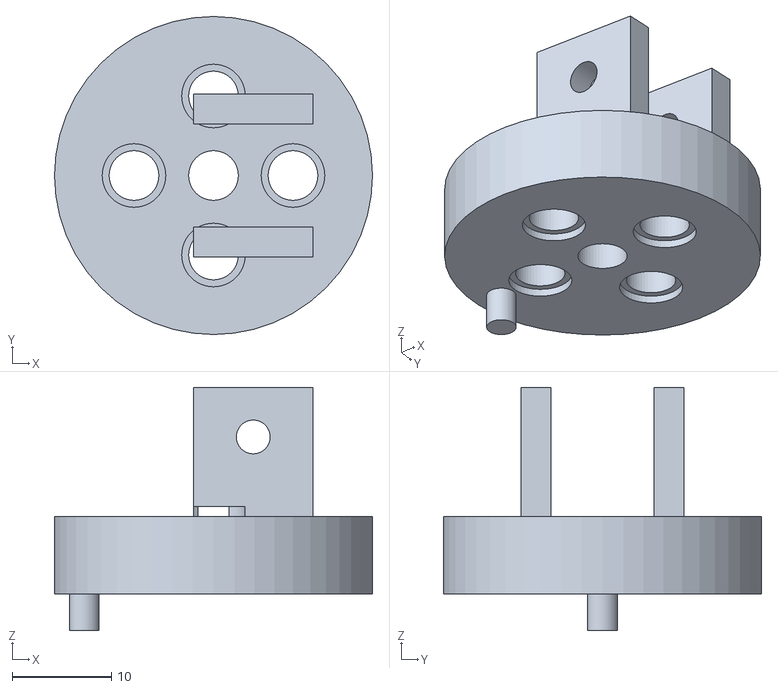
[picture p232: CAD file, 2026-11-11]
stl/head_pan_platform.stl
32.0 x 32.0 x 24.5
