eoinjordan/botbuilder/stl/lego/wheeled/tip_idler_fork.stl

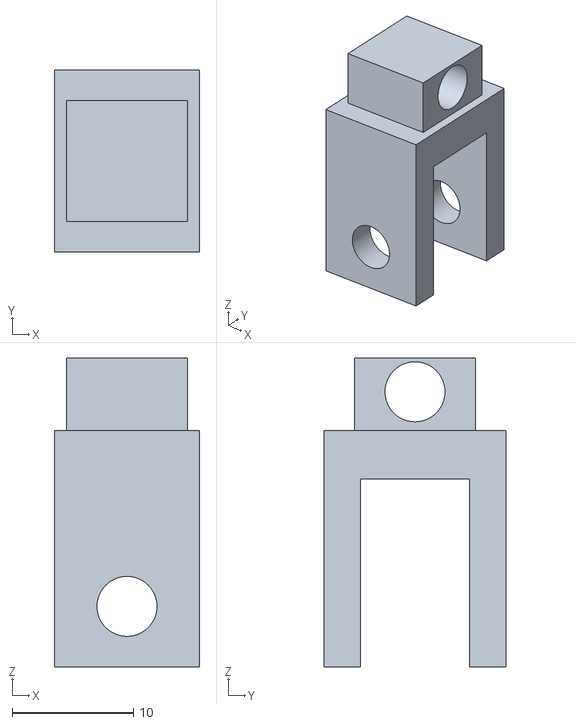
[picture p233: CAD file, 2026-11-11]
stl/lego/wheeled/tip_idler_fork.stl
12.0 x 15.0 x 25.5
