eoinjordan/botbuilder/stl/lego/wheeled/wheel_solid_tt_d65.stl

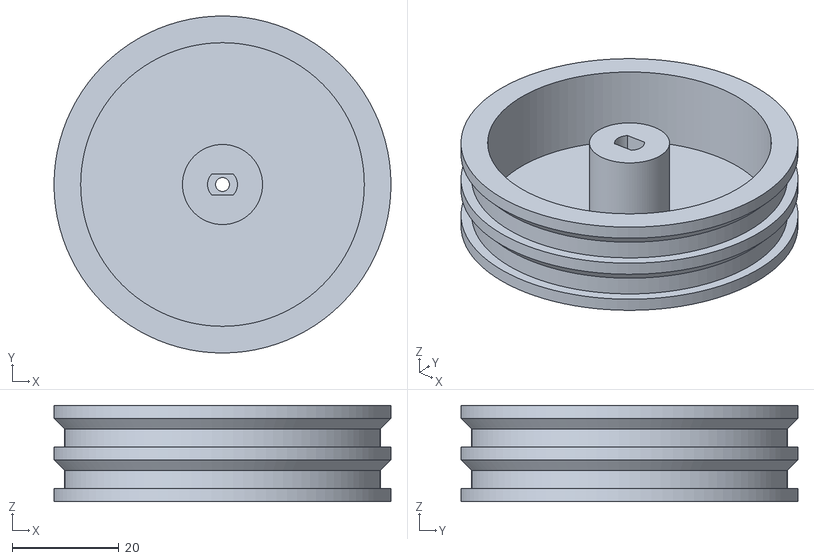
[picture p235: CAD file, 2026-11-11]
stl/lego/wheeled/wheel_solid_tt_d65.stl
63.2 x 63.2 x 18.0
