eoinjordan/botbuilder/stl/01_torso_hub51515_cam_esp32cam.stl

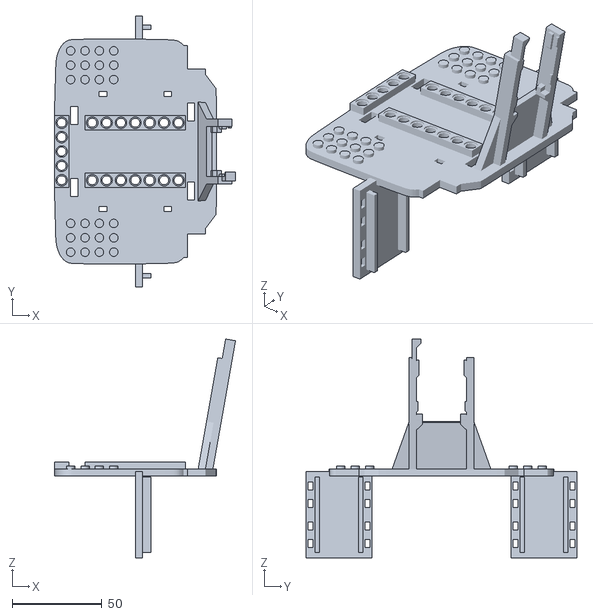
[picture p236: CAD file, 2026-11-11]
stl/01_torso_hub51515_cam_esp32cam.stl
100.7 x 150.5 x 121.8
