eoinjordan/botbuilder/stl/lego/wheeled/wheel_solid_cross_d43.stl

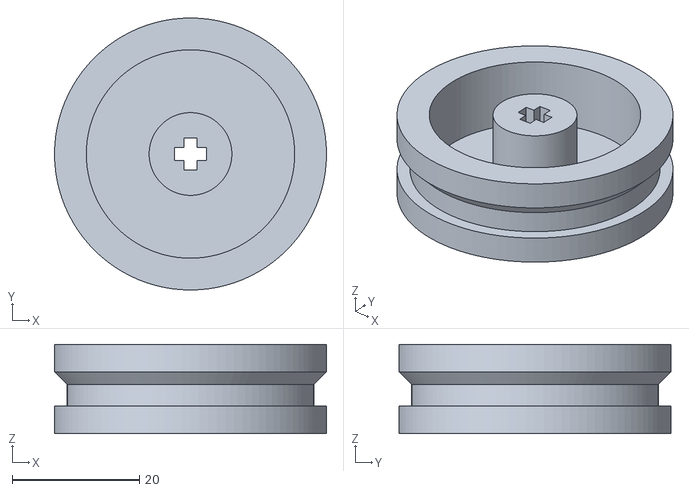
[picture p237: CAD file, 2026-11-11]
stl/lego/wheeled/wheel_solid_cross_d43.stl
42.8 x 42.8 x 14.0
