eoinjordan/botbuilder/stl/head_tilt_cradle_eyes_above_esp32cam.stl

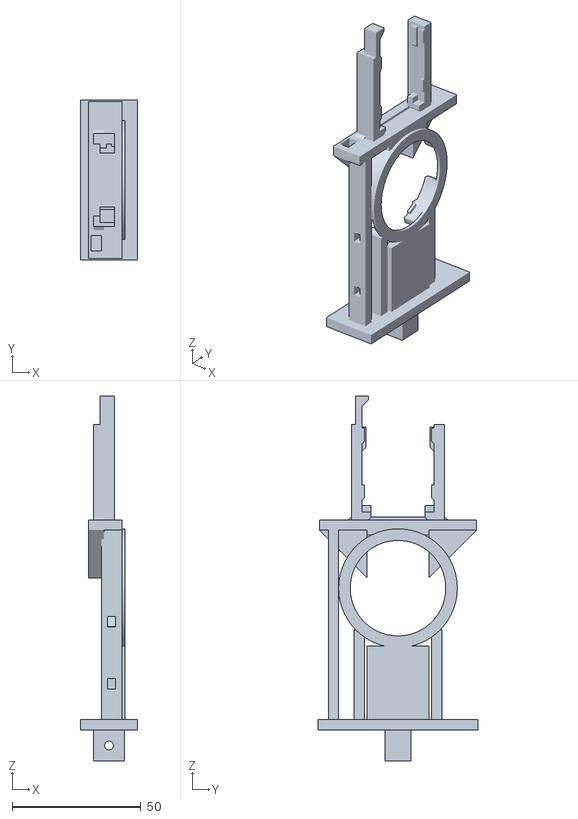
[picture p238: CAD file, 2026-11-11]
stl/head_tilt_cradle_eyes_above_esp32cam.stl
22.0 x 62.0 x 141.5
