eoinjordan/botbuilder/stl/01_torso_unoq_cam_esp32_s3_eye.stl

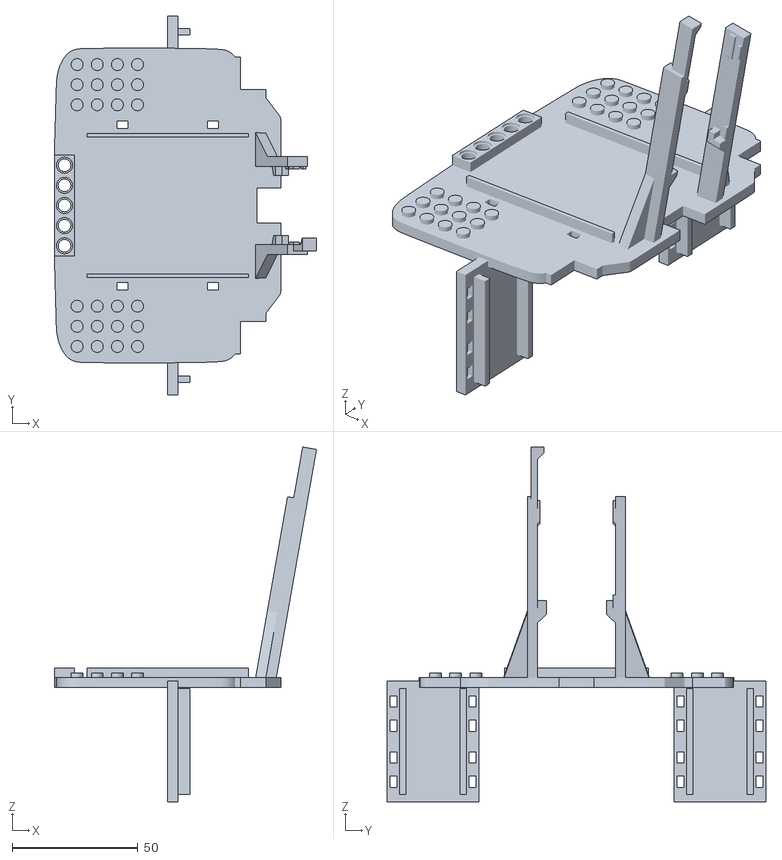
[picture p239: CAD file, 2026-11-11]
stl/01_torso_unoq_cam_esp32_s3_eye.stl
104.1 x 150.5 x 141.0
