eoinjordan/botbuilder/stl/head_pixy_plate_pixy2.stl

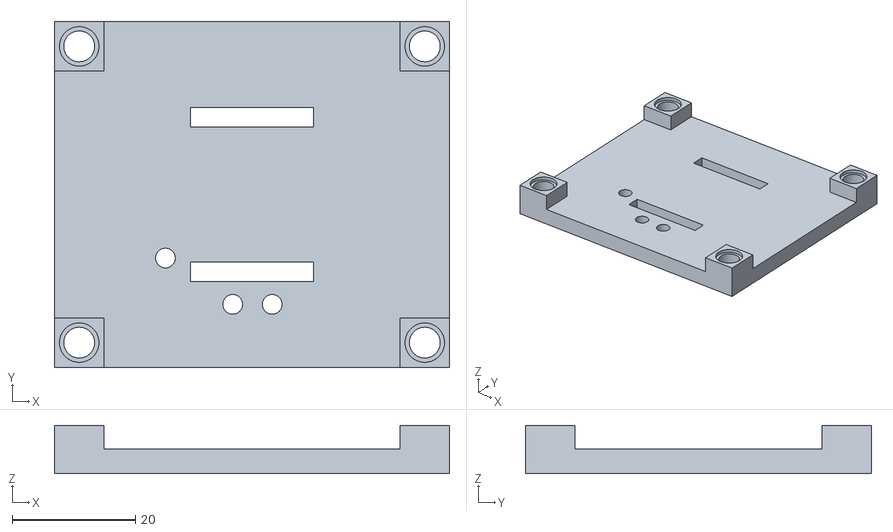
[picture p240: CAD file, 2026-11-11]
stl/head_pixy_plate_pixy2.stl
64.0 x 56.0 x 7.80
