eoinjordan/botbuilder/stl/right_shin_comb_foot.stl

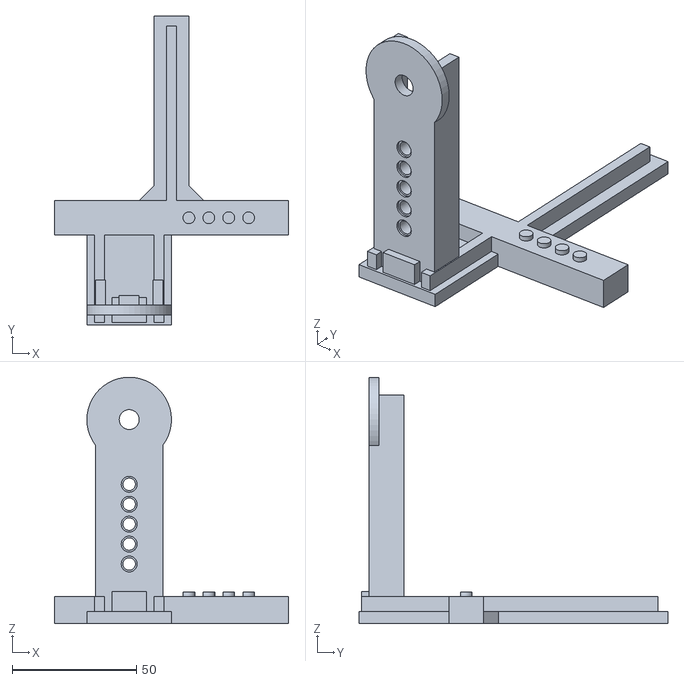
[picture p241: CAD file, 2026-11-11]
stl/right_shin_comb_foot.stl
94.0 x 124.0 x 99.0
