eoinjordan/botbuilder/stl/fit_cam_esp32_s3_eye.stl

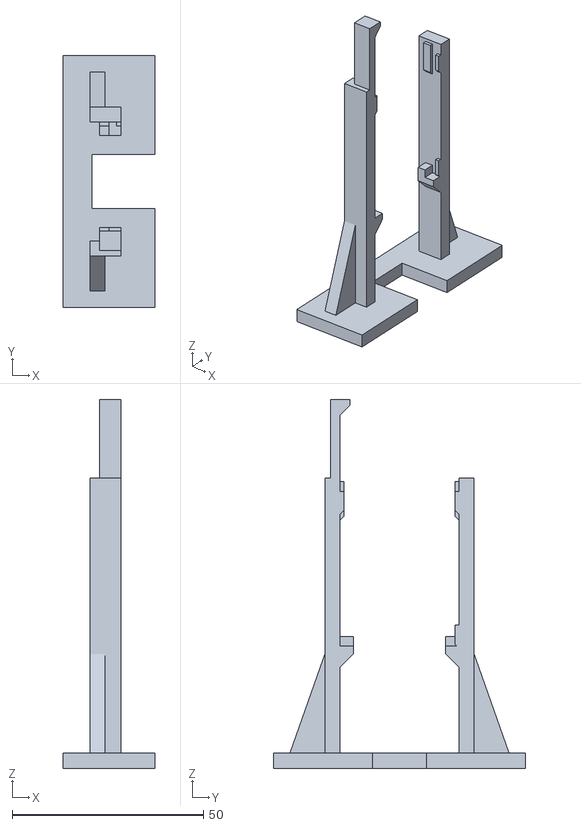
[picture p242: CAD file, 2026-11-11]
stl/fit_cam_esp32_s3_eye.stl
24.0 x 66.0 x 96.5
