eoinjordan/botbuilder/stl/fit_cam_esp32cam.stl

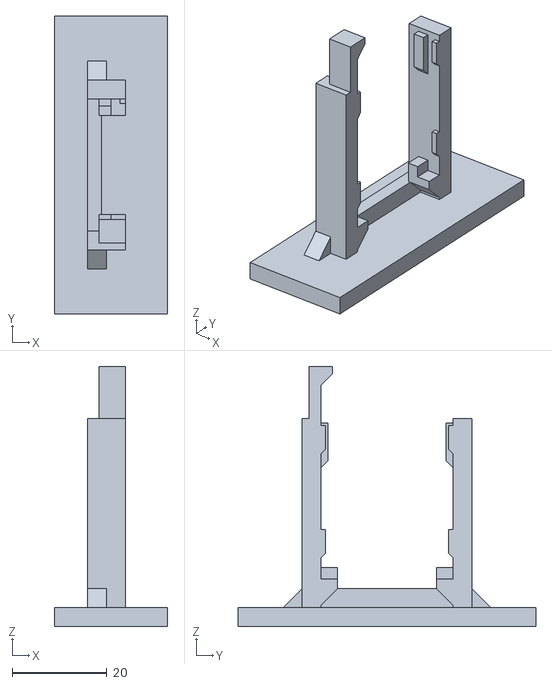
[picture p243: CAD file, 2026-11-11]
stl/fit_cam_esp32cam.stl
24.0 x 63.0 x 55.0
