eoinjordan/botbuilder/(list of files, cad)

Other CAD files:
stl/01_torso_pi_zero_2w_cam_esp_eye.stl
stl/01_torso_unoq_stack_camera_forward.stl
stl/01_torso_pi_zero_2w_cam_esp32cam.stl
stl/lego/wheeled/fit_bore_horn.stl
stl/01_torso_unoq_cam_esp32cam.stl
stl/microduck-look/right_hip_roll.stl
stl/microduck-look/right_thigh.stl
stl/microduck-look/right_shin.stl
stl/microduck-look/left_foot.stl
stl/01_torso_pi_cam_esp32cam.stl
stl/microduck-look/left_hip_yaw.stl
stl/01_torso_unoq_eyes_above_esp32cam.stl
stl/left_shin_flat_foot.stl
stl/right_thigh_knee_cradle.stl
stl/head_tilt_cradle_eyes_below_esp32cam.stl
stl/left_hip_roll_pitch_yoke.stl
