eoinjordan/botbuilder/docs/images/build-duck.png

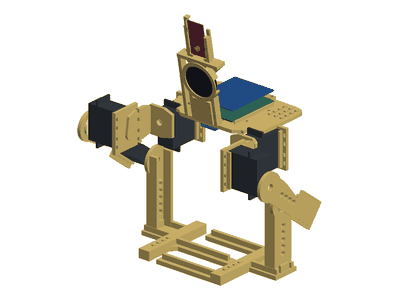
docs/images/build-duck.png
