eoinjordan/botbuilder/docs/images/build-ev3-walker.png

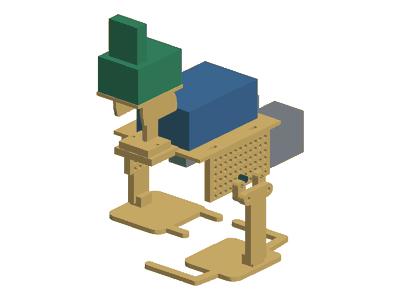
docs/images/build-ev3-walker.png
