eoinjordan/botbuilder/docs/images/build-hub-walker.png

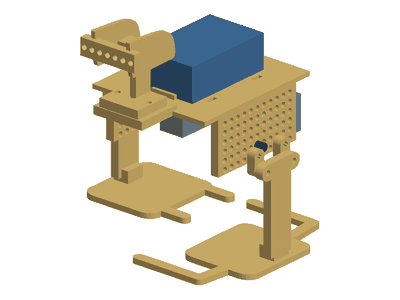
docs/images/build-hub-walker.png
