eoinjordan/botbuilder/docs/images/build-look.png

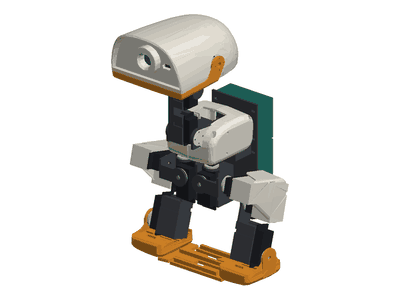
docs/images/build-look.png
