eoinjordan/botbuilder/docs/images/build-pi-rover.png

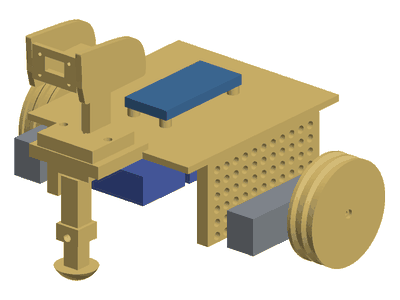
docs/images/build-pi-rover.png
