eoinjordan/botbuilder/docs/images/build-pi-walker.png

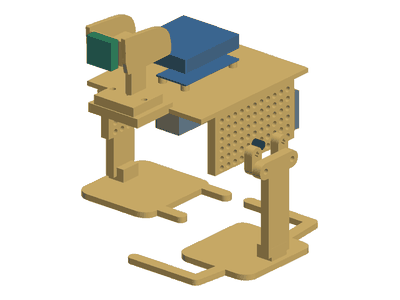
docs/images/build-pi-walker.png
