eoinjordan/botbuilder/stl/thumbs/lego/ev3-pixy2/crank_print_4.png

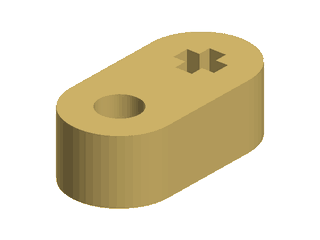
stl/thumbs/lego/ev3-pixy2/crank_print_4.png
