eoinjordan/botbuilder/stl/thumbs/lego/ev3-pixy2/gear_16t_print_6.png

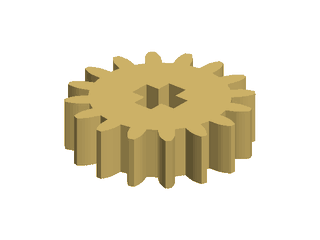
stl/thumbs/lego/ev3-pixy2/gear_16t_print_6.png
