eoinjordan/botbuilder/stl/thumbs/lego/wheeled/servo_cradle_print_2.png

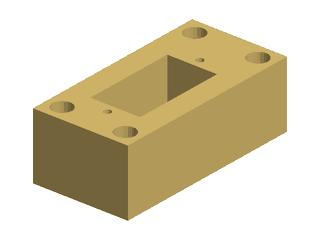
stl/thumbs/lego/wheeled/servo_cradle_print_2.png
