eoinjordan/botbuilder/stl/thumbs/lego/wheeled/tt_cradle_print_2.png

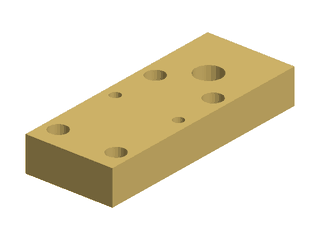
stl/thumbs/lego/wheeled/tt_cradle_print_2.png
