eoinjordan/botbuilder/robot/microduck.urdf

<?xml version="1.0"?>
<!-- Generated by scripts/generate_description.py. Do not edit. -->
<robot name="microduck_braccio_unoq">
  <material name="print"><color rgba="0.93 0.80 0.47 1"/></material>
  <material name="servo"><color rgba="0.24 0.26 0.29 1"/></material>
  <material name="horn"><color rgba="0.88 0.89 0.90 1"/></material>
  <material name="board"><color rgba="0.08 0.47 0.43 1"/></material>
  <material name="shield"><color rgba="0.16 0.35 0.63 1"/></material>
  <material name="camera"><color rgba="0.59 0.16 0.24 1"/></material>
  <material name="display"><color rgba="0.12 0.12 0.14 1"/></material>
  <material name="battery"><color rgba="0.35 0.43 0.78 1"/></material>
  <link name="torso">
    <inertial><origin xyz="0.0187028 -0.000166447 0.000522261" rpy="0 0 0"/><mass value="0.26567"/><inertia ixx="0.000772098" ixy="1.40578e-06" ixz="-5.67017e-05" iyy="0.000412183" iyz="1.98714e-06" izz="0.000641655"/></inertial>
    <visual><origin xyz="0.002 -0.057 -0.044" rpy="0 0 0"/><geometry><box size="0.0039992 0.0364927 0.0029994"/></geometry><material name="print"/></visual>
    <collision><origin xyz="0.002 -0.057 -0.044" rpy="0 0 0"/><geometry><box size="0.0039992 0.0364927 0.0029994"/></geometry></collision>
    <visual><origin xyz="0.002 0.057 -0.044" rpy="0 0 0"/><geometry><box size="0.0039992 0.0364927 0.0029994"/></geometry><material name="print"/></visual>
    <collision><origin xyz="0.002 0.057 -0.044" rpy="0 0 0"/><geometry><box size="0.0039992 0.0364927 0.0029994"/></geometry></collision>
    <visual><origin xyz="0.002 -0.057 -0.04108" rpy="0 0 0"/><geometry><box size="0.0039992 0.0364927 0.00283943"/></geometry><material name="print"/></visual>
    <collision><origin xyz="0.002 -0.057 -0.04108" rpy="0 0 0"/><geometry><box size="0.0039992 0.0364927 0.00283943"/></geometry></collision>
    <visual><origin xyz="0.002 0.057 -0.04108" rpy="0 0 0"/><geometry><box size="0.0039992 0.0364927 0.00283943"/></geometry><material name="print"/></visual>
    <collision><origin xyz="0.002 0.057 -0.04108" rpy="0 0 0"/><geometry><box size="0.0039992 0.0364927 0.00283943"/></geometry></collision>
    <visual><origin xyz="0.002 -0.057 -0.03746" rpy="0 0 0"/><geometry><box size="0.0039992 0.0286943 0.00439912"/></geometry><material name="print"/></visual>
    <collision><origin xyz="0.002 -0.057 -0.03746" rpy="0 0 0"/><geometry><box size="0.0039992 0.0286943 0.00439912"/></geometry></collision>
    <visual><origin xyz="0.002 0.057 -0.03746" rpy="0 0 0"/><geometry><box size="0.0039992 0.0286943 0.00439912"/></geometry><material name="print"/></visual>
    <collision><origin xyz="0.002 0.057 -0.03746" rpy="0 0 0"/><geometry><box size="0.0039992 0.0286943 0.00439912"/></geometry></collision>
    <visual><origin xyz="0.002 -0.057 -0.03263" rpy="0 0 0"/><geometry><box size="0.0039992 0.0364927 0.00525895"/></geometry><material name="print"/></visual>
    <collision><origin xyz="0.002 -0.057 -0.03263" rpy="0 0 0"/><geometry><box size="0.0039992 0.0364927 0.00525895"/></geometry></collision>
    <visual><origin xyz="0.002 0.057 -0.03263" rpy="0 0 0"/><geometry><box size="0.0039992 0.0364927 0.00525895"/></geometry><material name="print"/></visual>
    <collision><origin xyz="0.002 0.057 -0.03263" rpy="0 0 0"/><geometry><box size="0.0039992 0.0364927 0.00525895"/></geometry></collision>
    <visual><origin xyz="0.002 -0.057 -0.0278" rpy="0 0 0"/><geometry><box size="0.0039992 0.0286943 0.00439912"/></geometry><material name="print"/></visual>
    <collision><origin xyz="0.002 -0.057 -0.0278" rpy="0 0 0"/><geometry><box size="0.0039992 0.0286943 0.00439912"/></geometry></collision>
    <visual><origin xyz="0.002 0.057 -0.0278" rpy="0 0 0"/><geometry><box size="0.0039992 0.0286943 0.00439912"/></geometry><material name="print"/></visual>
    <collision><origin xyz="0.002 0.057 -0.0278" rpy="0 0 0"/><geometry><box size="0.0039992 0.0286943 0.00439912"/></geometry></collision>
    <visual><origin xyz="0.002 -0.057 -0.0215" rpy="0 0 0"/><geometry><box size="0.0039992 0.0364927 0.00819836"/></geometry><material name="print"/></visual>
    <collision><origin xyz="0.002 -0.057 -0.0215" rpy="0 0 0"/><geometry><box size="0.0039992 0.0364927 0.00819836"/></geometry></collision>
    <visual><origin xyz="0.002 0.057 -0.0215" rpy="0 0 0"/><geometry><box size="0.0039992 0.0364927 0.00819836"/></geometry><material name="print"/></visual>
    <collision><origin xyz="0.002 0.057 -0.0215" rpy="0 0 0"/><geometry><box size="0.0039992 0.0364927 0.00819836"/></geometry></collision>
    <visual><origin xyz="0.002 -0.057 -0.0152" rpy="0 0 0"/><geometry><box size="0.0039992 0.0286943 0.00439912"/></geometry><material name="print"/></visual>
    <collision><origin xyz="0.002 -0.057 -0.0152" rpy="0 0 0"/><geometry><box size="0.0039992 0.0286943 0.00439912"/></geometry></collision>
    <visual><origin xyz="0.002 0.057 -0.0152" rpy="0 0 0"/><geometry><box size="0.0039992 0.0286943 0.00439912"/></geometry><material name="print"/></visual>
    <collision><origin xyz="0.002 0.057 -0.0152" rpy="0 0 0"/><geometry><box size="0.0039992 0.0286943 0.00439912"/></geometry></collision>
    <visual><origin xyz="0.002 -0.057 -0.01037" rpy="0 0 0"/><geometry><box size="0.0039992 0.0364927 0.00525895"/></geometry><material name="print"/></visual>
    <collision><origin xyz="0.002 -0.057 -0.01037" rpy="0 0 0"/><geometry><box size="0.0039992 0.0364927 0.00525895"/></geometry></collision>
    <visual><origin xyz="0.002 0.057 -0.01037" rpy="0 0 0"/><geometry><box size="0.0039992 0.0364927 0.00525895"/></geometry><material name="print"/></visual>
    <collision><origin xyz="0.002 0.057 -0.01037" rpy="0 0 0"/><geometry><box size="0.0039992 0.0364927 0.00525895"/></geometry></collision>
    <visual><origin xyz="0.002 -0.057 -0.00554" rpy="0 0 0"/><geometry><box size="0.0039992 0.0286943 0.00439912"/></geometry><material name="print"/></visual>
    <collision><origin xyz="0.002 -0.057 -0.00554" rpy="0 0 0"/><geometry><box size="0.0039992 0.0286943 0.00439912"/></geometry></collision>
    <visual><origin xyz="0.002 0.057 -0.00554" rpy="0 0 0"/><geometry><box size="0.0039992 0.0286943 0.00439912"/></geometry><material name="print"/></visual>
    <collision><origin xyz="0.002 0.057 -0.00554" rpy="0 0 0"/><geometry><box size="0.0039992 0.0286943 0.00439912"/></geometry></collision>
    <visual><origin xyz="0.002 -0.057 -0.00192" rpy="0 0 0"/><geometry><box size="0.0039992 0.0364927 0.00283943"/></geometry><material name="print"/></visual>
    <collision><origin xyz="0.002 -0.057 -0.00192" rpy="0 0 0"/><geometry><box size="0.0039992 0.0364927 0.00283943"/></geometry></collision>
    <visual><origin xyz="0.002 0.057 -0.00192" rpy="0 0 0"/><geometry><box size="0.0039992 0.0364927 0.00283943"/></geometry><material name="print"/></visual>
    <collision><origin xyz="0.002 0.057 -0.00192" rpy="0 0 0"/><geometry><box size="0.0039992 0.0364927 0.00283943"/></geometry></collision>
    <visual><origin xyz="3.27446e-06 4.6978e-10 0.00100434" rpy="0 0 0"/><geometry><box size="0.08996 0.150065 0.00299081"/></geometry><material name="print"/></visual>
    <collision><origin xyz="3.27446e-06 4.6978e-10 0.00100434" rpy="0 0 0"/><geometry><box size="0.08996 0.150065 0.00299081"/></geometry></collision>
    <visual><origin xyz="-0.0409919 -0.0408828 0.00409828" rpy="0 0 0"/><geometry><box size="0.00798268 0.0417579 0.00319625"/></geometry><material name="print"/></visual>
    <collision><origin xyz="-0.0409919 -0.0408828 0.00409828" rpy="0 0 0"/><geometry><box size="0.00798268 0.0417579 0.00319625"/></geometry></collision>
    <visual><origin xyz="-0.041 9.62712e-11 0.0041" rpy="0 0 0"/><geometry><box size="0.00799889 0.0399944 0.00319936"/></geometry><material name="print"/></visual>
    <collision><origin xyz="-0.041 9.62712e-11 0.0041" rpy="0 0 0"/><geometry><box size="0.00799889 0.0399944 0.00319936"/></geometry></collision>
    <visual><origin xyz="-0.0409946 0.0408834 0.00409828" rpy="0 0 0"/><geometry><box size="0.00798812 0.0417591 0.00319625"/></geometry><material name="print"/></visual>
    <collision><origin xyz="-0.0409946 0.0408834 0.00409828" rpy="0 0 0"/><geometry><box size="0.00798812 0.0417591 0.00319625"/></geometry></collision>
    <visual><origin xyz="-0.0286 -0.0455356 0.00409964" rpy="0 0 0"/><geometry><box size="0.0167971 0.0338629 0.00319892"/></geometry><material name="print"/></visual>
    <collision><origin xyz="-0.0286 -0.0455356 0.00409964" rpy="0 0 0"/><geometry><box size="0.0167971 0.0338629 0.00319892"/></geometry></collision>
    <visual><origin xyz="-0.0286 2.71766e-10 0.00325" rpy="0 0 0"/><geometry><box size="0.0167966 0.0543891 0.0014997"/></geometry><material name="print"/></visual>
    <collision><origin xyz="-0.0286 2.71766e-10 0.00325" rpy="0 0 0"/><geometry><box size="0.0167966 0.0543891 0.0014997"/></geometry></collision>
    <visual><origin xyz="-0.0286 0.0455363 0.00409964" rpy="0 0 0"/><geometry><box size="0.0167971 0.0338642 0.00319892"/></geometry><material name="print"/></visual>
    <collision><origin xyz="-0.0286 0.0455363 0.00409964" rpy="0 0 0"/><geometry><box size="0.0167971 0.0338642 0.00319892"/></geometry></collision>
    <visual><origin xyz="-0.0180001 -0.0479968 0.00409968" rpy="0 0 0"/><geometry><box size="0.00439909 0.0289863 0.00319899"/></geometry><material name="print"/></visual>
    <collision><origin xyz="-0.0180001 -0.0479968 0.00409968" rpy="0 0 0"/><geometry><box size="0.00439909 0.0289863 0.00319899"/></geometry></collision>
    <visual><origin xyz="-0.018 -1.69134e-10 0.00409836" rpy="0 0 0"/><geometry><box size="0.00439912 0.0609872 0.0031964"/></geometry><material name="print"/></visual>
    <collision><origin xyz="-0.018 -1.69134e-10 0.00409836" rpy="0 0 0"/><geometry><box size="0.00439912 0.0609872 0.0031964"/></geometry></collision>
    <visual><origin xyz="-0.0180001 0.0479966 0.00409968" rpy="0 0 0"/><geometry><box size="0.00439909 0.0289859 0.00319899"/></geometry><material name="print"/></visual>
    <collision><origin xyz="-0.0180001 0.0479966 0.00409968" rpy="0 0 0"/><geometry><box size="0.00439909 0.0289859 0.00319899"/></geometry></collision>
    <visual><origin xyz="-1.20658e-08 -0.0455465 0.00409848" rpy="0 0 0"/><geometry><box size="0.0315933 0.0338858 0.00319664"/></geometry><material name="print"/></visual>
    <collision><origin xyz="-1.20658e-08 -0.0455465 0.00409848" rpy="0 0 0"/><geometry><box size="0.0315933 0.0338858 0.00319664"/></geometry></collision>
    <visual><origin xyz="1.57864e-10 -0.0279 0.0041" rpy="0 0 0"/><geometry><box size="0.0315937 0.00139972 0.00319936"/></geometry><material name="print"/></visual>
    <collision><origin xyz="1.57864e-10 -0.0279 0.0041" rpy="0 0 0"/><geometry><box size="0.0315937 0.00139972 0.00319936"/></geometry></collision>
    <visual><origin xyz="-1.58044e-07 2.65963e-10 0.00325" rpy="0 0 0"/><geometry><box size="0.0315934 0.0543892 0.0014997"/></geometry><material name="print"/></visual>
    <collision><origin xyz="-1.58044e-07 2.65963e-10 0.00325" rpy="0 0 0"/><geometry><box size="0.0315934 0.0543892 0.0014997"/></geometry></collision>
    <visual><origin xyz="1.57864e-10 0.0279 0.0041" rpy="0 0 0"/><geometry><box size="0.0315937 0.00139972 0.00319936"/></geometry><material name="print"/></visual>
    <collision><origin xyz="1.57864e-10 0.0279 0.0041" rpy="0 0 0"/><geometry><box size="0.0315937 0.00139972 0.00319936"/></geometry></collision>
    <visual><origin xyz="-1.20658e-08 0.045547 0.00409848" rpy="0 0 0"/><geometry><box size="0.0315933 0.0338868 0.00319664"/></geometry><material name="print"/></visual>
    <collision><origin xyz="-1.20658e-08 0.045547 0.00409848" rpy="0 0 0"/><geometry><box size="0.0315933 0.0338868 0.00319664"/></geometry></collision>
    <visual><origin xyz="0.018 -0.0478648 0.00325" rpy="0 0 0"/><geometry><box size="0.00439912 0.0287239 0.0014997"/></geometry><material name="print"/></visual>
    <collision><origin xyz="0.018 -0.0478648 0.00325" rpy="0 0 0"/><geometry><box size="0.00439912 0.0287239 0.0014997"/></geometry></collision>
    <visual><origin xyz="0.018 -1.64185e-09 0.00409837" rpy="0 0 0"/><geometry><box size="0.00439909 0.0609872 0.00319642"/></geometry><material name="print"/></visual>
    <collision><origin xyz="0.018 -1.64185e-09 0.00409837" rpy="0 0 0"/><geometry><box size="0.00439909 0.0609872 0.00319642"/></geometry></collision>
    <visual><origin xyz="0.018 0.0478648 0.00325" rpy="0 0 0"/><geometry><box size="0.00439912 0.0287239 0.0014997"/></geometry><material name="print"/></visual>
    <collision><origin xyz="0.018 0.0478648 0.00325" rpy="0 0 0"/><geometry><box size="0.00439912 0.0287239 0.0014997"/></geometry></collision>
    <visual><origin xyz="0.0246 -0.0452952 0.00325" rpy="0 0 0"/><geometry><box size="0.00879823 0.033384 0.0014997"/></geometry><material name="print"/></visual>
    <collision><origin xyz="0.0246 -0.0452952 0.00325" rpy="0 0 0"/><geometry><box size="0.00879823 0.033384 0.0014997"/></geometry></collision>
    <visual><origin xyz="0.0246 2.71766e-10 0.00325" rpy="0 0 0"/><geometry><box size="0.00879824 0.0543891 0.0014997"/></geometry><material name="print"/></visual>
    <collision><origin xyz="0.0246 2.71766e-10 0.00325" rpy="0 0 0"/><geometry><box size="0.00879824 0.0543891 0.0014997"/></geometry></collision>
    <visual><origin xyz="0.0246 0.0452952 0.00325" rpy="0 0 0"/><geometry><box size="0.00879823 0.033384 0.0014997"/></geometry><material name="print"/></visual>
    <collision><origin xyz="0.0246 0.0452952 0.00325" rpy="0 0 0"/><geometry><box size="0.00879823 0.033384 0.0014997"/></geometry></collision>
    <visual><origin xyz="0.034 4.49249e-10 0.00409195" rpy="0 0 0"/><geometry><box size="0.00999806 0.0919818 0.00318361"/></geometry><material name="print"/></visual>
    <collision><origin xyz="0.034 4.49249e-10 0.00409195" rpy="0 0 0"/><geometry><box size="0.00999806 0.0919818 0.00318361"/></geometry></collision>
    <visual><origin xyz="0.0420002 1.38228e-10 0.00408439" rpy="0 0 0"/><geometry><box size="0.00599908 0.0259946 0.00316847"/></geometry><material name="print"/></visual>
    <collision><origin xyz="0.0420002 1.38228e-10 0.00408439" rpy="0 0 0"/><geometry><box size="0.00599908 0.0259946 0.00316847"/></geometry></collision>
    <visual><origin xyz="0.0419998 0.029812 0.00325" rpy="0 0 0"/><geometry><box size="0.00599856 0.0256196 0.0014997"/></geometry><material name="print"/></visual>
    <collision><origin xyz="0.0419998 0.029812 0.00325" rpy="0 0 0"/><geometry><box size="0.00599856 0.0256196 0.0014997"/></geometry></collision>
    <visual><origin xyz="0.0468059 1.19897e-10 0.00480001" rpy="0 0 0"/><geometry><box size="0.00361107 0.0239952 0.00179964"/></geometry><material name="print"/></visual>
    <collision><origin xyz="0.0468059 1.19897e-10 0.00480001" rpy="0 0 0"/><geometry><box size="0.00361107 0.0239952 0.00179964"/></geometry></collision>
    <visual><origin xyz="-0.041 7.67046e-11 0.00674996" rpy="0 0 0"/><geometry><box size="0.00799901 0.039995 0.00209955"/></geometry><material name="print"/></visual>
    <collision><origin xyz="-0.041 7.67046e-11 0.00674996" rpy="0 0 0"/><geometry><box size="0.00799901 0.039995 0.00209955"/></geometry></collision>
    <visual><origin xyz="3.19725e-10 -0.0279 0.00675" rpy="0 0 0"/><geometry><box size="0.0639872 0.00139972 0.00209958"/></geometry><material name="print"/></visual>
    <collision><origin xyz="3.19725e-10 -0.0279 0.00675" rpy="0 0 0"/><geometry><box size="0.0639872 0.00139972 0.00209958"/></geometry></collision>
    <visual><origin xyz="3.19725e-10 0.0279 0.00675" rpy="0 0 0"/><geometry><box size="0.0639872 0.00139972 0.00209958"/></geometry><material name="print"/></visual>
    <collision><origin xyz="3.19725e-10 0.0279 0.00675" rpy="0 0 0"/><geometry><box size="0.0639872 0.00139972 0.00209958"/></geometry></collision>
    <visual><origin xyz="0.0498253 -0.0259986 0.0434697" rpy="0 0 0"/><geometry><box size="0.0207868 0.00299678 0.0755242"/></geometry><material name="print"/></visual>
    <collision><origin xyz="0.0498253 -0.0259986 0.0434697" rpy="0 0 0"/><geometry><box size="0.0207868 0.00299678 0.0755242"/></geometry></collision>
    <visual><origin xyz="0.049819 -0.02375 0.0434645" rpy="0 0 0"/><geometry><box size="0.0207791 0.0014997 0.0755143"/></geometry><material name="print"/></visual>
    <collision><origin xyz="0.049819 -0.02375 0.0434645" rpy="0 0 0"/><geometry><box size="0.0207791 0.0014997 0.0755143"/></geometry></collision>
    <visual><origin xyz="0.0528864 -0.0207499 0.0745777" rpy="0 0 0"/><geometry><box size="0.0148303 0.00449907 0.013474"/></geometry><material name="print"/></visual>
    <collision><origin xyz="0.0528864 -0.0207499 0.0745777" rpy="0 0 0"/><geometry><box size="0.0148303 0.00449907 0.013474"/></geometry></collision>
    <visual><origin xyz="0.0537848 -0.0207439 0.0534765" rpy="0 0 0"/><geometry><box size="0.010609 0.00448664 0.0274503"/></geometry><material name="print"/></visual>
    <collision><origin xyz="0.0537848 -0.0207439 0.0534765" rpy="0 0 0"/><geometry><box size="0.010609 0.00448664 0.0274503"/></geometry></collision>
    <visual><origin xyz="0.0527322 -0.01775 0.0738009" rpy="0 0 0"/><geometry><box size="0.0151155 0.0014997 0.0150043"/></geometry><material name="print"/></visual>
    <collision><origin xyz="0.0527322 -0.01775 0.0738009" rpy="0 0 0"/><geometry><box size="0.0151155 0.0014997 0.0150043"/></geometry></collision>
    <visual><origin xyz="0.0473867 -0.016 0.0255017" rpy="0 0 0"/><geometry><box size="0.01601 0.0019996 0.0395967"/></geometry><material name="print"/></visual>
    <collision><origin xyz="0.0473867 -0.016 0.0255017" rpy="0 0 0"/><geometry><box size="0.01601 0.0019996 0.0395967"/></geometry></collision>
    <visual><origin xyz="0.0525669 -0.016 0.073051" rpy="0 0 0"/><geometry><box size="0.0154397 0.0019996 0.0173727"/></geometry><material name="print"/></visual>
    <collision><origin xyz="0.0525669 -0.016 0.073051" rpy="0 0 0"/><geometry><box size="0.0154397 0.0019996 0.0173727"/></geometry></collision>
    <visual><origin xyz="0.0471112 -0.01425 0.0238315" rpy="0 0 0"/><geometry><box size="0.015457 0.0014997 0.0362563"/></geometry><material name="print"/></visual>
    <collision><origin xyz="0.0471112 -0.01425 0.0238315" rpy="0 0 0"/><geometry><box size="0.015457 0.0014997 0.0362563"/></geometry></collision>
    <visual><origin xyz="0.054224 -0.01425 0.0901663" rpy="0 0 0"/><geometry><box size="0.0191499 0.0014997 0.0543348"/></geometry><material name="print"/></visual>
    <collision><origin xyz="0.054224 -0.01425 0.0901663" rpy="0 0 0"/><geometry><box size="0.0191499 0.0014997 0.0543348"/></geometry></collision>
    <visual><origin xyz="0.0469919 -0.0127503 0.0230053" rpy="0 0 0"/><geometry><box size="0.0152013 0.00149933 0.0346027"/></geometry><material name="print"/></visual>
    <collision><origin xyz="0.0469919 -0.0127503 0.0230053" rpy="0 0 0"/><geometry><box size="0.0152013 0.00149933 0.0346027"/></geometry></collision>
    <visual><origin xyz="0.0550934 -0.01275 0.0948791" rpy="0 0 0"/><geometry><box size="0.0213852 0.0014997 0.0666716"/></geometry><material name="print"/></visual>
    <collision><origin xyz="0.0550934 -0.01275 0.0948791" rpy="0 0 0"/><geometry><box size="0.0213852 0.0014997 0.0666716"/></geometry></collision>
    <visual><origin xyz="0.0563858 -0.0115 0.100821" rpy="0 0 0"/><geometry><box size="0.0188208 0.0009998 0.0548073"/></geometry><material name="print"/></visual>
    <collision><origin xyz="0.0563858 -0.0115 0.100821" rpy="0 0 0"/><geometry><box size="0.0188208 0.0009998 0.0548073"/></geometry></collision>
    <visual><origin xyz="0.0553439 -0.0105 0.0916784" rpy="0 0 0"/><geometry><box size="0.0168319 0.0009998 0.0480247"/></geometry><material name="print"/></visual>
    <collision><origin xyz="0.0553439 -0.0105 0.0916784" rpy="0 0 0"/><geometry><box size="0.0168319 0.0009998 0.0480247"/></geometry></collision>
    <visual><origin xyz="0.048998 -0.00925 0.0184573" rpy="0 0 0"/><geometry><box size="0.00794042 0.0014997 0.0255095"/></geometry><material name="print"/></visual>
    <collision><origin xyz="0.048998 -0.00925 0.0184573" rpy="0 0 0"/><geometry><box size="0.00794042 0.0014997 0.0255095"/></geometry></collision>
    <visual><origin xyz="0.0537251 -0.00925 0.0759059" rpy="0 0 0"/><geometry><box size="0.0136226 0.0014997 0.0151441"/></geometry><material name="print"/></visual>
    <collision><origin xyz="0.0537251 -0.00925 0.0759059" rpy="0 0 0"/><geometry><box size="0.0136226 0.0014997 0.0151441"/></geometry></collision>
    <visual><origin xyz="0.0494256 5.71089e-11 0.0208691" rpy="0 0 0"/><geometry><box size="0.0087906 0.0149974 0.0303327"/></geometry><material name="print"/></visual>
    <collision><origin xyz="0.0494256 5.71089e-11 0.0208691" rpy="0 0 0"/><geometry><box size="0.0087906 0.0149974 0.0303327"/></geometry></collision>
    <visual><origin xyz="0.0538711 5.09368e-10 0.0755279" rpy="0 0 0"/><geometry><box size="0.0139328 0.0149973 0.0115723"/></geometry><material name="print"/></visual>
    <collision><origin xyz="0.0538711 5.09368e-10 0.0755279" rpy="0 0 0"/><geometry><box size="0.0139328 0.0149973 0.0115723"/></geometry></collision>
    <visual><origin xyz="0.048998 0.00875 0.0184573" rpy="0 0 0"/><geometry><box size="0.00794042 0.0024995 0.0255095"/></geometry><material name="print"/></visual>
    <collision><origin xyz="0.048998 0.00875 0.0184573" rpy="0 0 0"/><geometry><box size="0.00794042 0.0024995 0.0255095"/></geometry></collision>
    <visual><origin xyz="0.0537501 0.00875002 0.0759252" rpy="0 0 0"/><geometry><box size="0.0136741 0.00249949 0.015107"/></geometry><material name="print"/></visual>
    <collision><origin xyz="0.0537501 0.00875002 0.0759252" rpy="0 0 0"/><geometry><box size="0.0136741 0.00249949 0.015107"/></geometry></collision>
    <visual><origin xyz="0.0536711 0.0105 0.0883666" rpy="0 0 0"/><geometry><box size="0.0134893 0.0009998 0.0414075"/></geometry><material name="print"/></visual>
    <collision><origin xyz="0.0536711 0.0105 0.0883666" rpy="0 0 0"/><geometry><box size="0.0134893 0.0009998 0.0414075"/></geometry></collision>
    <visual><origin xyz="0.0547796 0.0115 0.0953759" rpy="0 0 0"/><geometry><box size="0.0156396 0.0009998 0.0439474"/></geometry><material name="print"/></visual>
    <collision><origin xyz="0.0547796 0.0115 0.0953759" rpy="0 0 0"/><geometry><box size="0.0156396 0.0009998 0.0439474"/></geometry></collision>
    <visual><origin xyz="0.0534716 0.0125 0.0894002" rpy="0 0 0"/><geometry><box size="0.0182319 0.0009998 0.055875"/></geometry><material name="print"/></visual>
    <collision><origin xyz="0.0534716 0.0125 0.0894002" rpy="0 0 0"/><geometry><box size="0.0182319 0.0009998 0.055875"/></geometry></collision>
    <visual><origin xyz="0.0471005 0.014 0.0238071" rpy="0 0 0"/><geometry><box size="0.0154352 0.0019996 0.0362074"/></geometry><material name="print"/></visual>
    <collision><origin xyz="0.0471005 0.014 0.0238071" rpy="0 0 0"/><geometry><box size="0.0154352 0.0019996 0.0362074"/></geometry></collision>
    <visual><origin xyz="0.0535832 0.014 0.0899364" rpy="0 0 0"/><geometry><box size="0.0180113 0.0019996 0.0548054"/></geometry><material name="print"/></visual>
    <collision><origin xyz="0.0535832 0.014 0.0899364" rpy="0 0 0"/><geometry><box size="0.0180113 0.0019996 0.0548054"/></geometry></collision>
    <visual><origin xyz="0.0473851 0.016 0.0254932" rpy="0 0 0"/><geometry><box size="0.0159993 0.0019996 0.0395793"/></geometry><material name="print"/></visual>
    <collision><origin xyz="0.0473851 0.016 0.0254932" rpy="0 0 0"/><geometry><box size="0.0159993 0.0019996 0.0395793"/></geometry></collision>
    <visual><origin xyz="0.0525669 0.016 0.073051" rpy="0 0 0"/><geometry><box size="0.0154397 0.0019996 0.0173727"/></geometry><material name="print"/></visual>
    <collision><origin xyz="0.0525669 0.016 0.073051" rpy="0 0 0"/><geometry><box size="0.0154397 0.0019996 0.0173727"/></geometry></collision>
    <visual><origin xyz="0.05314 0.0199848 0.0534698" rpy="0 0 0"/><geometry><box size="0.0125741 0.00596854 0.0311466"/></geometry><material name="print"/></visual>
    <collision><origin xyz="0.05314 0.0199848 0.0534698" rpy="0 0 0"/><geometry><box size="0.0125741 0.00596854 0.0311466"/></geometry></collision>
    <visual><origin xyz="0.0527895 0.0222495 0.0738999" rpy="0 0 0"/><geometry><box size="0.015017 0.0104976 0.0148224"/></geometry><material name="print"/></visual>
    <collision><origin xyz="0.0527895 0.0222495 0.0738999" rpy="0 0 0"/><geometry><box size="0.015017 0.0104976 0.0148224"/></geometry></collision>
    <visual><origin xyz="0 0 0.0073" rpy="0 0 0"/><geometry><box size="0.06858 0.05334 0.0016"/></geometry><material name="board"/></visual>
    <collision><origin xyz="0 0 0.0073" rpy="0 0 0"/><geometry><box size="0.06858 0.05334 0.0016"/></geometry></collision>
    <visual><origin xyz="0 0 0.0199" rpy="0 0 0"/><geometry><box size="0.06858 0.05334 0.0016"/></geometry><material name="shield"/></visual>
    <collision><origin xyz="0 0 0.0199" rpy="0 0 0"/><geometry><box size="0.06858 0.05334 0.0016"/></geometry></collision>
    <visual><origin xyz="0.024 0 -0.00275" rpy="0 0 0"/><geometry><box size="0.036 0.02 0.0055"/></geometry><material name="battery"/></visual>
    <collision><origin xyz="0.024 0 -0.00275" rpy="0 0 0"/><geometry><box size="0.036 0.02 0.0055"/></geometry></collision>
    <visual><origin xyz="0.0486964 0 0.0534441" rpy="0 0 0"/><geometry><box size="0.0210532 0.04 0.0402606"/></geometry><material name="display"/></visual>
    <collision><origin xyz="0.0486964 0 0.0534441" rpy="0 0 0"/><geometry><box size="0.0210532 0.04 0.0402606"/></geometry></collision>
    <visual><origin xyz="0.0600807 0 0.103153" rpy="0 0 0"/><geometry><box size="0.0102344 0.021 0.040655"/></geometry><material name="camera"/></visual>
    <collision><origin xyz="0.0600807 0 0.103153" rpy="0 0 0"/><geometry><box size="0.0102344 0.021 0.040655"/></geometry></collision>
    <visual><origin xyz="0.02375 0.057 -0.0215" rpy="0 0 0"/><geometry><box size="0.0395 0.0205 0.042"/></geometry><material name="servo"/></visual>
    <collision><origin xyz="0.02375 0.057 -0.0215" rpy="0 0 0"/><geometry><box size="0.0395 0.0205 0.042"/></geometry></collision>
    <visual><origin xyz="0.03225 0.057 -0.0215" rpy="0 0 0"/><geometry><box size="0.0025 0.0205 0.055"/></geometry><material name="servo"/></visual>
    <collision><origin xyz="0.03225 0.057 -0.0215" rpy="0 0 0"/><geometry><box size="0.0025 0.0205 0.055"/></geometry></collision>
    <visual><origin xyz="0.02375 -0.057 -0.0215" rpy="0 0 0"/><geometry><box size="0.0395 0.0205 0.042"/></geometry><material name="servo"/></visual>
    <collision><origin xyz="0.02375 -0.057 -0.0215" rpy="0 0 0"/><geometry><box size="0.0395 0.0205 0.042"/></geometry></collision>
    <visual><origin xyz="0.03225 -0.057 -0.0215" rpy="0 0 0"/><geometry><box size="0.0025 0.0205 0.055"/></geometry><material name="servo"/></visual>
    <collision><origin xyz="0.03225 -0.057 -0.0215" rpy="0 0 0"/><geometry><box size="0.0025 0.0205 0.055"/></geometry></collision>
  </link>
  <link name="left_hip">
    <inertial><origin xyz="0.037581 0.0346936 -4.57129e-05" rpy="0 0 0"/><mass value="0.0739048"/><inertia ixx="2.75282e-05" ixy="-5.31463e-06" ixz="1.90784e-08" iyy="1.96427e-05" iyz="9.79651e-08" izz="2.46208e-05"/></inertial>
    <visual><origin xyz="0.00104786 -6.78088e-06 5.2951e-07" rpy="0 0 0"/><geometry><box size="0.00590346 0.0339785 0.0339874"/></geometry><material name="print"/></visual>
    <collision><origin xyz="0.00104786 -6.78088e-06 5.2951e-07" rpy="0 0 0"/><geometry><box size="0.00590346 0.0339785 0.0339874"/></geometry></collision>
    <visual><origin xyz="0.0128752 0.014 1.51755e-05" rpy="0 0 0"/><geometry><box size="0.0177462 0.0039992 0.0359573"/></geometry><material name="print"/></visual>
    <collision><origin xyz="0.0128752 0.014 1.51755e-05" rpy="0 0 0"/><geometry><box size="0.0177462 0.0039992 0.0359573"/></geometry></collision>
    <visual><origin xyz="0.0236999 0.0155001 2.93083e-10" rpy="0 0 0"/><geometry><box size="0.00389926 0.0069985 0.0479894"/></geometry><material name="print"/></visual>
    <collision><origin xyz="0.0236999 0.0155001 2.93083e-10" rpy="0 0 0"/><geometry><box size="0.00389926 0.0069985 0.0479894"/></geometry></collision>
    <visual><origin xyz="0.0274501 0.0178999 -1.49872e-10" rpy="0 0 0"/><geometry><box size="0.00359915 0.0117973 0.0479778"/></geometry><material name="print"/></visual>
    <collision><origin xyz="0.0274501 0.0178999 -1.49872e-10" rpy="0 0 0"/><geometry><box size="0.00359915 0.0117973 0.0479778"/></geometry></collision>
    <visual><origin xyz="0.04 0.017 2.39794e-10" rpy="0 0 0"/><geometry><box size="0.0214957 0.0039992 0.0479904"/></geometry><material name="print"/></visual>
    <collision><origin xyz="0.04 0.017 2.39794e-10" rpy="0 0 0"/><geometry><box size="0.0214957 0.0039992 0.0479904"/></geometry></collision>
    <visual><origin xyz="0.035598 0.0135 0.000386327" rpy="0 0 0"/><geometry><box size="0.012694 0.0029994 0.0344673"/></geometry><material name="print"/></visual>
    <collision><origin xyz="0.035598 0.0135 0.000386327" rpy="0 0 0"/><geometry><box size="0.012694 0.0029994 0.0344673"/></geometry></collision>
    <visual><origin xyz="0.05205 0.0193999 -4.21811e-10" rpy="0 0 0"/><geometry><box size="0.00259948 0.00879824 0.0479803"/></geometry><material name="print"/></visual>
    <collision><origin xyz="0.05205 0.0193999 -4.21811e-10" rpy="0 0 0"/><geometry><box size="0.00259948 0.00879824 0.0479803"/></geometry></collision>
    <visual><origin xyz="0.0558 0.017 4.09647e-11" rpy="0 0 0"/><geometry><box size="0.00489902 0.0039992 0.00819836"/></geometry><material name="print"/></visual>
    <collision><origin xyz="0.0558 0.017 4.09647e-11" rpy="0 0 0"/><geometry><box size="0.00489902 0.0039992 0.00819836"/></geometry></collision>
    <visual><origin xyz="-0.00125 0 -1.38778e-19" rpy="0 1.570796 0"/><geometry><cylinder radius="0.0105" length="0.0025"/></geometry><material name="horn"/></visual>
    <visual><origin xyz="0.04 0.03875 0" rpy="0 0 0"/><geometry><box size="0.0205 0.0395 0.042"/></geometry><material name="servo"/></visual>
    <collision><origin xyz="0.04 0.03875 0" rpy="0 0 0"/><geometry><box size="0.0205 0.0395 0.042"/></geometry></collision>
    <visual><origin xyz="0.04 0.04725 0" rpy="0 0 0"/><geometry><box size="0.0205 0.0025 0.055"/></geometry><material name="servo"/></visual>
    <collision><origin xyz="0.04 0.04725 0" rpy="0 0 0"/><geometry><box size="0.0205 0.0025 0.055"/></geometry></collision>
  </link>
  <link name="left_thigh">
    <inertial><origin xyz="0.000150937 -0.0103009 -0.0662956" rpy="0 0 0"/><mass value="0.0366055"/><inertia ixx="2.39106e-05" ixy="-6.79637e-08" ixz="-1.31168e-07" iyy="2.15039e-05" iyz="-3.88608e-06" izz="5.00302e-06"/></inertial>
    <visual><origin xyz="-5.58587e-10 0.002 -0.0383892" rpy="0 0 0"/><geometry><box size="0.0337255 0.0039992 0.110504"/></geometry><material name="print"/></visual>
    <collision><origin xyz="-5.58587e-10 0.002 -0.0383892" rpy="0 0 0"/><geometry><box size="0.0337255 0.0039992 0.110504"/></geometry></collision>
    <visual><origin xyz="1.70392e-11 -0.00189993 -0.036" rpy="0 0 0"/><geometry><box size="0.00799896 0.00379915 0.0319958"/></geometry><material name="print"/></visual>
    <collision><origin xyz="1.70392e-11 -0.00189993 -0.036" rpy="0 0 0"/><geometry><box size="0.00799896 0.00379915 0.0319958"/></geometry></collision>
    <visual><origin xyz="-0.01005 -0.0024 -0.075" rpy="0 0 0"/><geometry><box size="0.00259948 0.00479904 0.0312937"/></geometry><material name="print"/></visual>
    <collision><origin xyz="-0.01005 -0.0024 -0.075" rpy="0 0 0"/><geometry><box size="0.00259948 0.00479904 0.0312937"/></geometry></collision>
    <visual><origin xyz="0.01005 -0.0024 -0.075" rpy="0 0 0"/><geometry><box size="0.00259948 0.00479904 0.0312937"/></geometry><material name="print"/></visual>
    <collision><origin xyz="0.01005 -0.0024 -0.075" rpy="0 0 0"/><geometry><box size="0.00259948 0.00479904 0.0312937"/></geometry></collision>
    <visual><origin xyz="-1.38778e-19 -0.00125 0" rpy="1.570796 0 0"/><geometry><cylinder radius="0.0105" length="0.0025"/></geometry><material name="horn"/></visual>
    <visual><origin xyz="-1.73472e-18 -0.0143 -0.075" rpy="0 0 0"/><geometry><box size="0.0165 0.0286 0.0313"/></geometry><material name="servo"/></visual>
    <collision><origin xyz="-1.73472e-18 -0.0143 -0.075" rpy="0 0 0"/><geometry><box size="0.0165 0.0286 0.0313"/></geometry></collision>
    <visual><origin xyz="-1.73472e-18 -0.0205 -0.075" rpy="0 0 0"/><geometry><box size="0.0165 0.002 0.0403"/></geometry><material name="servo"/></visual>
    <collision><origin xyz="-1.73472e-18 -0.0205 -0.075" rpy="0 0 0"/><geometry><box size="0.0165 0.002 0.0403"/></geometry></collision>
  </link>
  <link name="left_shin">
    <inertial><origin xyz="0.00904494 -0.0353816 -0.0627189" rpy="0 0 0"/><mass value="0.0400271"/><inertia ixx="7.03796e-05" ixy="8.88012e-06" ixz="5.26236e-06" iyy="5.64137e-05" iyz="-1.82856e-05" izz="7.24303e-05"/></inertial>
    <visual><origin xyz="-0.0235 -0.076 -0.0795" rpy="0 0 0"/><geometry><box size="0.0129974 0.0879824 0.004999"/></geometry><material name="print"/></visual>
    <collision><origin xyz="-0.0235 -0.076 -0.0795" rpy="0 0 0"/><geometry><box size="0.0129974 0.0879824 0.004999"/></geometry></collision>
    <visual><origin xyz="-0.0165 -0.058 -0.0795" rpy="0 0 0"/><geometry><box size="0.0009998 0.123975 0.004999"/></geometry><material name="print"/></visual>
    <collision><origin xyz="-0.0165 -0.058 -0.0795" rpy="0 0 0"/><geometry><box size="0.0009998 0.123975 0.004999"/></geometry></collision>
    <visual><origin xyz="0.000499824 -0.0236638 -0.0795" rpy="0 0 0"/><geometry><box size="0.0329937 0.0553175 0.004999"/></geometry><material name="print"/></visual>
    <collision><origin xyz="0.000499824 -0.0236638 -0.0795" rpy="0 0 0"/><geometry><box size="0.0329937 0.0553175 0.004999"/></geometry></collision>
    <visual><origin xyz="0.0335005 -0.0417959 -0.0795" rpy="0 0 0"/><geometry><box size="0.0329942 0.0195889 0.004999"/></geometry><material name="print"/></visual>
    <collision><origin xyz="0.0335005 -0.0417959 -0.0795" rpy="0 0 0"/><geometry><box size="0.0329942 0.0195889 0.004999"/></geometry></collision>
    <visual><origin xyz="0.057 -0.076 -0.0795" rpy="0 0 0"/><geometry><box size="0.0139972 0.0879824 0.004999"/></geometry><material name="print"/></visual>
    <collision><origin xyz="0.057 -0.076 -0.0795" rpy="0 0 0"/><geometry><box size="0.0139972 0.0879824 0.004999"/></geometry></collision>
    <visual><origin xyz="-0.0275 -0.039 -0.074" rpy="0 0 0"/><geometry><box size="0.004999 0.0139972 0.0059988"/></geometry><material name="print"/></visual>
    <collision><origin xyz="-0.0275 -0.039 -0.074" rpy="0 0 0"/><geometry><box size="0.004999 0.0139972 0.0059988"/></geometry></collision>
    <visual><origin xyz="-0.023 -0.074 -0.074" rpy="0 0 0"/><geometry><box size="0.0039992 0.0839832 0.0059988"/></geometry><material name="print"/></visual>
    <collision><origin xyz="-0.023 -0.074 -0.074" rpy="0 0 0"/><geometry><box size="0.0039992 0.0839832 0.0059988"/></geometry></collision>
    <visual><origin xyz="-0.0175 -0.039 -0.074" rpy="0 0 0"/><geometry><box size="0.0069986 0.0139972 0.0059988"/></geometry><material name="print"/></visual>
    <collision><origin xyz="-0.0175 -0.039 -0.074" rpy="0 0 0"/><geometry><box size="0.0069986 0.0139972 0.0059988"/></geometry></collision>
    <visual><origin xyz="-0.012 -0.0215 -0.074" rpy="0 0 0"/><geometry><box size="0.0039992 0.0489902 0.0059988"/></geometry><material name="print"/></visual>
    <collision><origin xyz="-0.012 -0.0215 -0.074" rpy="0 0 0"/><geometry><box size="0.0039992 0.0489902 0.0059988"/></geometry></collision>
    <visual><origin xyz="-0.0085 -0.039 -0.074" rpy="0 0 0"/><geometry><box size="0.0029994 0.0139972 0.0059988"/></geometry><material name="print"/></visual>
    <collision><origin xyz="-0.0085 -0.039 -0.074" rpy="0 0 0"/><geometry><box size="0.0029994 0.0139972 0.0059988"/></geometry></collision>
    <visual><origin xyz="6.99398e-11 -0.039 -0.074" rpy="0 0 0"/><geometry><box size="0.0139972 0.0139972 0.0059988"/></geometry><material name="print"/></visual>
    <collision><origin xyz="6.99398e-11 -0.039 -0.074" rpy="0 0 0"/><geometry><box size="0.0139972 0.0139972 0.0059988"/></geometry></collision>
    <visual><origin xyz="6.99398e-11 -0.002 -0.074" rpy="0 0 0"/><geometry><box size="0.0139972 0.009998 0.0059988"/></geometry><material name="print"/></visual>
    <collision><origin xyz="6.99398e-11 -0.002 -0.074" rpy="0 0 0"/><geometry><box size="0.0139972 0.009998 0.0059988"/></geometry></collision>
    <visual><origin xyz="0.00825 -0.039 -0.074" rpy="0 0 0"/><geometry><box size="0.0024995 0.0139972 0.0059988"/></geometry><material name="print"/></visual>
    <collision><origin xyz="0.00825 -0.039 -0.074" rpy="0 0 0"/><geometry><box size="0.0024995 0.0139972 0.0059988"/></geometry></collision>
    <visual><origin xyz="0.0117502 -0.0215003 -0.074" rpy="0 0 0"/><geometry><box size="0.00449882 0.0489901 0.0059988"/></geometry><material name="print"/></visual>
    <collision><origin xyz="0.0117502 -0.0215003 -0.074" rpy="0 0 0"/><geometry><box size="0.00449882 0.0489901 0.0059988"/></geometry></collision>
    <visual><origin xyz="0.0345 -0.039 -0.074" rpy="0 0 0"/><geometry><box size="0.0409918 0.0139972 0.0059988"/></geometry><material name="print"/></visual>
    <collision><origin xyz="0.0345 -0.039 -0.074" rpy="0 0 0"/><geometry><box size="0.0409918 0.0139972 0.0059988"/></geometry></collision>
    <visual><origin xyz="0.057 -0.074 -0.074" rpy="0 0 0"/><geometry><box size="0.0039992 0.0839832 0.0059988"/></geometry><material name="print"/></visual>
    <collision><origin xyz="0.057 -0.074 -0.074" rpy="0 0 0"/><geometry><box size="0.0039992 0.0839832 0.0059988"/></geometry></collision>
    <visual><origin xyz="0.0615 -0.039 -0.074" rpy="0 0 0"/><geometry><box size="0.004999 0.0139972 0.0059988"/></geometry><material name="print"/></visual>
    <collision><origin xyz="0.0615 -0.039 -0.074" rpy="0 0 0"/><geometry><box size="0.004999 0.0139972 0.0059988"/></geometry></collision>
    <visual><origin xyz="-0.0115 -0.007 -0.0665" rpy="0 0 0"/><geometry><box size="0.0039992 0.0139972 0.0089982"/></geometry><material name="print"/></visual>
    <collision><origin xyz="-0.0115 -0.007 -0.0665" rpy="0 0 0"/><geometry><box size="0.0039992 0.0139972 0.0089982"/></geometry></collision>
    <visual><origin xyz="6.99398e-11 -0.002 -0.0665" rpy="0 0 0"/><geometry><box size="0.0139972 0.0039992 0.0089982"/></geometry><material name="print"/></visual>
    <collision><origin xyz="6.99398e-11 -0.002 -0.0665" rpy="0 0 0"/><geometry><box size="0.0139972 0.0039992 0.0089982"/></geometry></collision>
    <visual><origin xyz="0.0115 -0.007 -0.0665" rpy="0 0 0"/><geometry><box size="0.0039992 0.0139972 0.0089982"/></geometry><material name="print"/></visual>
    <collision><origin xyz="0.0115 -0.007 -0.0665" rpy="0 0 0"/><geometry><box size="0.0039992 0.0139972 0.0089982"/></geometry></collision>
    <visual><origin xyz="0.036 -0.039 -0.07015" rpy="0 0 0"/><geometry><box size="0.0287069 0.00472848 0.00169966"/></geometry><material name="print"/></visual>
    <collision><origin xyz="0.036 -0.039 -0.07015" rpy="0 0 0"/><geometry><box size="0.0287069 0.00472848 0.00169966"/></geometry></collision>
    <visual><origin xyz="-0.0115 -0.007 -0.042" rpy="0 0 0"/><geometry><box size="0.0039992 0.0139972 0.039992"/></geometry><material name="print"/></visual>
    <collision><origin xyz="-0.0115 -0.007 -0.042" rpy="0 0 0"/><geometry><box size="0.0039992 0.0139972 0.039992"/></geometry></collision>
    <visual><origin xyz="-0.00675 -0.002 -0.042" rpy="0 0 0"/><geometry><box size="0.0054989 0.0039992 0.039992"/></geometry><material name="print"/></visual>
    <collision><origin xyz="-0.00675 -0.002 -0.042" rpy="0 0 0"/><geometry><box size="0.0054989 0.0039992 0.039992"/></geometry></collision>
    <visual><origin xyz="1.71015e-11 -0.0039 -0.042" rpy="0 0 0"/><geometry><box size="0.00799895 0.00779796 0.0399948"/></geometry><material name="print"/></visual>
    <collision><origin xyz="1.71015e-11 -0.0039 -0.042" rpy="0 0 0"/><geometry><box size="0.00799895 0.00779796 0.0399948"/></geometry></collision>
    <visual><origin xyz="0.00675 -0.002 -0.042" rpy="0 0 0"/><geometry><box size="0.0054989 0.0039992 0.039992"/></geometry><material name="print"/></visual>
    <collision><origin xyz="0.00675 -0.002 -0.042" rpy="0 0 0"/><geometry><box size="0.0054989 0.0039992 0.039992"/></geometry></collision>
    <visual><origin xyz="0.0115 -0.007 -0.042" rpy="0 0 0"/><geometry><box size="0.0039992 0.0139972 0.039992"/></geometry><material name="print"/></visual>
    <collision><origin xyz="0.0115 -0.007 -0.042" rpy="0 0 0"/><geometry><box size="0.0039992 0.0139972 0.039992"/></geometry></collision>
    <visual><origin xyz="-0.0152412 -0.002 -0.000162703" rpy="0 0 0"/><geometry><box size="0.00348189 0.0039992 0.0200921"/></geometry><material name="print"/></visual>
    <collision><origin xyz="-0.0152412 -0.002 -0.000162703" rpy="0 0 0"/><geometry><box size="0.00348189 0.0039992 0.0200921"/></geometry></collision>
    <visual><origin xyz="-0.0115 -0.007 -0.00605" rpy="0 0 0"/><geometry><box size="0.0039992 0.0139972 0.0318936"/></geometry><material name="print"/></visual>
    <collision><origin xyz="-0.0115 -0.007 -0.00605" rpy="0 0 0"/><geometry><box size="0.0039992 0.0139972 0.0318936"/></geometry></collision>
    <visual><origin xyz="-4.86357e-10 -0.002 -0.00605" rpy="0 0 0"/><geometry><box size="0.0189965 0.0039992 0.0318942"/></geometry><material name="print"/></visual>
    <collision><origin xyz="-4.86357e-10 -0.002 -0.00605" rpy="0 0 0"/><geometry><box size="0.0189965 0.0039992 0.0318942"/></geometry></collision>
    <visual><origin xyz="0.0115 -0.007 -0.00605" rpy="0 0 0"/><geometry><box size="0.0039992 0.0139972 0.0318936"/></geometry><material name="print"/></visual>
    <collision><origin xyz="0.0115 -0.007 -0.00605" rpy="0 0 0"/><geometry><box size="0.0039992 0.0139972 0.0318936"/></geometry></collision>
    <visual><origin xyz="0.0152412 -0.002 -0.000162703" rpy="0 0 0"/><geometry><box size="0.00348189 0.0039992 0.0200921"/></geometry><material name="print"/></visual>
    <collision><origin xyz="0.0152412 -0.002 -0.000162703" rpy="0 0 0"/><geometry><box size="0.00348189 0.0039992 0.0200921"/></geometry></collision>
    <visual><origin xyz="1.19856e-10 -0.002 0.0134353" rpy="0 0 0"/><geometry><box size="0.0273036 0.0039992 0.00706957"/></geometry><material name="print"/></visual>
    <collision><origin xyz="1.19856e-10 -0.002 0.0134353" rpy="0 0 0"/><geometry><box size="0.0273036 0.0039992 0.00706957"/></geometry></collision>
    <visual><origin xyz="1.11022e-19 0.001 0" rpy="1.570796 0 0"/><geometry><cylinder radius="0.009" length="0.002"/></geometry><material name="horn"/></visual>
  </link>
  <link name="right_hip">
    <inertial><origin xyz="0.037581 -0.0346936 -4.57128e-05" rpy="0 0 0"/><mass value="0.0739048"/><inertia ixx="2.75282e-05" ixy="5.31463e-06" ixz="1.90795e-08" iyy="1.96427e-05" iyz="-9.79653e-08" izz="2.46208e-05"/></inertial>
    <visual><origin xyz="0.00104786 6.78085e-06 5.2951e-07" rpy="0 0 0"/><geometry><box size="0.00590346 0.0339785 0.0339874"/></geometry><material name="print"/></visual>
    <collision><origin xyz="0.00104786 6.78085e-06 5.2951e-07" rpy="0 0 0"/><geometry><box size="0.00590346 0.0339785 0.0339874"/></geometry></collision>
    <visual><origin xyz="0.0128752 -0.014 1.51785e-05" rpy="0 0 0"/><geometry><box size="0.0177462 0.0039992 0.0359573"/></geometry><material name="print"/></visual>
    <collision><origin xyz="0.0128752 -0.014 1.51785e-05" rpy="0 0 0"/><geometry><box size="0.0177462 0.0039992 0.0359573"/></geometry></collision>
    <visual><origin xyz="0.0236999 -0.0155002 2.93083e-10" rpy="0 0 0"/><geometry><box size="0.00389926 0.0069985 0.0479894"/></geometry><material name="print"/></visual>
    <collision><origin xyz="0.0236999 -0.0155002 2.93083e-10" rpy="0 0 0"/><geometry><box size="0.00389926 0.0069985 0.0479894"/></geometry></collision>
    <visual><origin xyz="0.0274501 -0.0178999 -1.49872e-10" rpy="0 0 0"/><geometry><box size="0.00359915 0.0117973 0.0479778"/></geometry><material name="print"/></visual>
    <collision><origin xyz="0.0274501 -0.0178999 -1.49872e-10" rpy="0 0 0"/><geometry><box size="0.00359915 0.0117973 0.0479778"/></geometry></collision>
    <visual><origin xyz="0.035598 -0.0135 0.00038626" rpy="0 0 0"/><geometry><box size="0.012694 0.0029994 0.0344672"/></geometry><material name="print"/></visual>
    <collision><origin xyz="0.035598 -0.0135 0.00038626" rpy="0 0 0"/><geometry><box size="0.012694 0.0029994 0.0344672"/></geometry></collision>
    <visual><origin xyz="0.04 -0.017 2.39794e-10" rpy="0 0 0"/><geometry><box size="0.0214957 0.0039992 0.0479904"/></geometry><material name="print"/></visual>
    <collision><origin xyz="0.04 -0.017 2.39794e-10" rpy="0 0 0"/><geometry><box size="0.0214957 0.0039992 0.0479904"/></geometry></collision>
    <visual><origin xyz="0.05205 -0.0193999 -4.21811e-10" rpy="0 0 0"/><geometry><box size="0.00259948 0.00879824 0.0479803"/></geometry><material name="print"/></visual>
    <collision><origin xyz="0.05205 -0.0193999 -4.21811e-10" rpy="0 0 0"/><geometry><box size="0.00259948 0.00879824 0.0479803"/></geometry></collision>
    <visual><origin xyz="0.0558 -0.017 4.09647e-11" rpy="0 0 0"/><geometry><box size="0.00489902 0.0039992 0.00819836"/></geometry><material name="print"/></visual>
    <collision><origin xyz="0.0558 -0.017 4.09647e-11" rpy="0 0 0"/><geometry><box size="0.00489902 0.0039992 0.00819836"/></geometry></collision>
    <visual><origin xyz="-0.00125 0 -1.38778e-19" rpy="0 1.570796 0"/><geometry><cylinder radius="0.0105" length="0.0025"/></geometry><material name="horn"/></visual>
    <visual><origin xyz="0.04 -0.03875 0" rpy="0 0 0"/><geometry><box size="0.0205 0.0395 0.042"/></geometry><material name="servo"/></visual>
    <collision><origin xyz="0.04 -0.03875 0" rpy="0 0 0"/><geometry><box size="0.0205 0.0395 0.042"/></geometry></collision>
    <visual><origin xyz="0.04 -0.04725 0" rpy="0 0 0"/><geometry><box size="0.0205 0.0025 0.055"/></geometry><material name="servo"/></visual>
    <collision><origin xyz="0.04 -0.04725 0" rpy="0 0 0"/><geometry><box size="0.0205 0.0025 0.055"/></geometry></collision>
  </link>
  <link name="right_thigh">
    <inertial><origin xyz="-0.000150937 0.0103009 -0.0662956" rpy="0 0 0"/><mass value="0.0366055"/><inertia ixx="2.39106e-05" ixy="-6.79637e-08" ixz="1.31168e-07" iyy="2.15039e-05" iyz="3.88608e-06" izz="5.00302e-06"/></inertial>
    <visual><origin xyz="5.58587e-10 -0.002 -0.0383892" rpy="0 0 0"/><geometry><box size="0.0337255 0.0039992 0.110504"/></geometry><material name="print"/></visual>
    <collision><origin xyz="5.58587e-10 -0.002 -0.0383892" rpy="0 0 0"/><geometry><box size="0.0337255 0.0039992 0.110504"/></geometry></collision>
    <visual><origin xyz="-1.70392e-11 0.00189993 -0.036" rpy="0 0 0"/><geometry><box size="0.00799896 0.00379915 0.0319958"/></geometry><material name="print"/></visual>
    <collision><origin xyz="-1.70392e-11 0.00189993 -0.036" rpy="0 0 0"/><geometry><box size="0.00799896 0.00379915 0.0319958"/></geometry></collision>
    <visual><origin xyz="0.01005 0.0024 -0.075" rpy="0 0 0"/><geometry><box size="0.00259948 0.00479904 0.0312937"/></geometry><material name="print"/></visual>
    <collision><origin xyz="0.01005 0.0024 -0.075" rpy="0 0 0"/><geometry><box size="0.00259948 0.00479904 0.0312937"/></geometry></collision>
    <visual><origin xyz="-0.01005 0.0024 -0.075" rpy="0 0 0"/><geometry><box size="0.00259948 0.00479904 0.0312937"/></geometry><material name="print"/></visual>
    <collision><origin xyz="-0.01005 0.0024 -0.075" rpy="0 0 0"/><geometry><box size="0.00259948 0.00479904 0.0312937"/></geometry></collision>
    <visual><origin xyz="-1.38778e-19 0.00125 0" rpy="1.570796 0 0"/><geometry><cylinder radius="0.0105" length="0.0025"/></geometry><material name="horn"/></visual>
    <visual><origin xyz="-1.73472e-18 0.0143 -0.075" rpy="0 0 0"/><geometry><box size="0.0165 0.0286 0.0313"/></geometry><material name="servo"/></visual>
    <collision><origin xyz="-1.73472e-18 0.0143 -0.075" rpy="0 0 0"/><geometry><box size="0.0165 0.0286 0.0313"/></geometry></collision>
    <visual><origin xyz="-1.73472e-18 0.0205 -0.075" rpy="0 0 0"/><geometry><box size="0.0165 0.002 0.0403"/></geometry><material name="servo"/></visual>
    <collision><origin xyz="-1.73472e-18 0.0205 -0.075" rpy="0 0 0"/><geometry><box size="0.0165 0.002 0.0403"/></geometry></collision>
  </link>
  <link name="right_shin">
    <inertial><origin xyz="0.00788235 0.028494 -0.0604633" rpy="0 0 0"/><mass value="0.0349233"/><inertia ixx="5.368e-05" ixy="-6.68698e-06" ixz="4.54413e-06" iyy="3.80985e-05" iyz="1.40202e-05" izz="4.02832e-05"/></inertial>
    <visual><origin xyz="-0.0235 0.039 -0.0795" rpy="0 0 0"/><geometry><box size="0.0129974 0.0139972 0.004999"/></geometry><material name="print"/></visual>
    <collision><origin xyz="-0.0235 0.039 -0.0795" rpy="0 0 0"/><geometry><box size="0.0129974 0.0139972 0.004999"/></geometry></collision>
    <visual><origin xyz="-0.00349986 0.0236911 -0.0795" rpy="0 0 0"/><geometry><box size="0.0269948 0.055372 0.004999"/></geometry><material name="print"/></visual>
    <collision><origin xyz="-0.00349986 0.0236911 -0.0795" rpy="0 0 0"/><geometry><box size="0.0269948 0.055372 0.004999"/></geometry></collision>
    <visual><origin xyz="0.0135 0.058 -0.0795" rpy="0 0 0"/><geometry><box size="0.0069986 0.123975 0.004999"/></geometry><material name="print"/></visual>
    <collision><origin xyz="0.0135 0.058 -0.0795" rpy="0 0 0"/><geometry><box size="0.0069986 0.123975 0.004999"/></geometry></collision>
    <visual><origin xyz="0.0205 0.076 -0.0795" rpy="0 0 0"/><geometry><box size="0.0069986 0.0879824 0.004999"/></geometry><material name="print"/></visual>
    <collision><origin xyz="0.0205 0.076 -0.0795" rpy="0 0 0"/><geometry><box size="0.0069986 0.0879824 0.004999"/></geometry></collision>
    <visual><origin xyz="0.0439994 0.0417808 -0.0795" rpy="0 0 0"/><geometry><box size="0.039993 0.0195587 0.004999"/></geometry><material name="print"/></visual>
    <collision><origin xyz="0.0439994 0.0417808 -0.0795" rpy="0 0 0"/><geometry><box size="0.039993 0.0195587 0.004999"/></geometry></collision>
    <visual><origin xyz="-0.022 0.039 -0.074" rpy="0 0 0"/><geometry><box size="0.0159968 0.0139972 0.0059988"/></geometry><material name="print"/></visual>
    <collision><origin xyz="-0.022 0.039 -0.074" rpy="0 0 0"/><geometry><box size="0.0159968 0.0139972 0.0059988"/></geometry></collision>
    <visual><origin xyz="-0.012 0.0215 -0.074" rpy="0 0 0"/><geometry><box size="0.0039992 0.0489902 0.0059988"/></geometry><material name="print"/></visual>
    <collision><origin xyz="-0.012 0.0215 -0.074" rpy="0 0 0"/><geometry><box size="0.0039992 0.0489902 0.0059988"/></geometry></collision>
    <visual><origin xyz="-0.0085 0.039 -0.074" rpy="0 0 0"/><geometry><box size="0.0029994 0.0139972 0.0059988"/></geometry><material name="print"/></visual>
    <collision><origin xyz="-0.0085 0.039 -0.074" rpy="0 0 0"/><geometry><box size="0.0029994 0.0139972 0.0059988"/></geometry></collision>
    <visual><origin xyz="6.99398e-11 0.002 -0.074" rpy="0 0 0"/><geometry><box size="0.0139972 0.009998 0.0059988"/></geometry><material name="print"/></visual>
    <collision><origin xyz="6.99398e-11 0.002 -0.074" rpy="0 0 0"/><geometry><box size="0.0139972 0.009998 0.0059988"/></geometry></collision>
    <visual><origin xyz="6.99398e-11 0.039 -0.074" rpy="0 0 0"/><geometry><box size="0.0139972 0.0139972 0.0059988"/></geometry><material name="print"/></visual>
    <collision><origin xyz="6.99398e-11 0.039 -0.074" rpy="0 0 0"/><geometry><box size="0.0139972 0.0139972 0.0059988"/></geometry></collision>
    <visual><origin xyz="0.00825 0.039 -0.074" rpy="0 0 0"/><geometry><box size="0.0024995 0.0139972 0.0059988"/></geometry><material name="print"/></visual>
    <collision><origin xyz="0.00825 0.039 -0.074" rpy="0 0 0"/><geometry><box size="0.0024995 0.0139972 0.0059988"/></geometry></collision>
    <visual><origin xyz="0.0117502 0.0215003 -0.074" rpy="0 0 0"/><geometry><box size="0.00449882 0.0489901 0.0059988"/></geometry><material name="print"/></visual>
    <collision><origin xyz="0.0117502 0.0215003 -0.074" rpy="0 0 0"/><geometry><box size="0.00449882 0.0489901 0.0059988"/></geometry></collision>
    <visual><origin xyz="0.017 0.074 -0.074" rpy="0 0 0"/><geometry><box size="0.0039992 0.0839832 0.0059988"/></geometry><material name="print"/></visual>
    <collision><origin xyz="0.017 0.074 -0.074" rpy="0 0 0"/><geometry><box size="0.0039992 0.0839832 0.0059988"/></geometry></collision>
    <visual><origin xyz="0.0415 0.039 -0.074" rpy="0 0 0"/><geometry><box size="0.044991 0.0139972 0.0059988"/></geometry><material name="print"/></visual>
    <collision><origin xyz="0.0415 0.039 -0.074" rpy="0 0 0"/><geometry><box size="0.044991 0.0139972 0.0059988"/></geometry></collision>
    <visual><origin xyz="-0.0115 0.007 -0.0665" rpy="0 0 0"/><geometry><box size="0.0039992 0.0139972 0.0089982"/></geometry><material name="print"/></visual>
    <collision><origin xyz="-0.0115 0.007 -0.0665" rpy="0 0 0"/><geometry><box size="0.0039992 0.0139972 0.0089982"/></geometry></collision>
    <visual><origin xyz="6.99398e-11 0.002 -0.0665" rpy="0 0 0"/><geometry><box size="0.0139972 0.0039992 0.0089982"/></geometry><material name="print"/></visual>
    <collision><origin xyz="6.99398e-11 0.002 -0.0665" rpy="0 0 0"/><geometry><box size="0.0139972 0.0039992 0.0089982"/></geometry></collision>
    <visual><origin xyz="0.0115 0.007 -0.0665" rpy="0 0 0"/><geometry><box size="0.0039992 0.0139972 0.0089982"/></geometry><material name="print"/></visual>
    <collision><origin xyz="0.0115 0.007 -0.0665" rpy="0 0 0"/><geometry><box size="0.0039992 0.0139972 0.0089982"/></geometry></collision>
    <visual><origin xyz="0.036 0.039 -0.07015" rpy="0 0 0"/><geometry><box size="0.0287069 0.00472849 0.00169966"/></geometry><material name="print"/></visual>
    <collision><origin xyz="0.036 0.039 -0.07015" rpy="0 0 0"/><geometry><box size="0.0287069 0.00472849 0.00169966"/></geometry></collision>
    <visual><origin xyz="-0.0115 0.007 -0.042" rpy="0 0 0"/><geometry><box size="0.0039992 0.0139972 0.039992"/></geometry><material name="print"/></visual>
    <collision><origin xyz="-0.0115 0.007 -0.042" rpy="0 0 0"/><geometry><box size="0.0039992 0.0139972 0.039992"/></geometry></collision>
    <visual><origin xyz="-0.00675 0.002 -0.042" rpy="0 0 0"/><geometry><box size="0.0054989 0.0039992 0.039992"/></geometry><material name="print"/></visual>
    <collision><origin xyz="-0.00675 0.002 -0.042" rpy="0 0 0"/><geometry><box size="0.0054989 0.0039992 0.039992"/></geometry></collision>
    <visual><origin xyz="1.71015e-11 0.0039 -0.042" rpy="0 0 0"/><geometry><box size="0.00799895 0.00779796 0.0399948"/></geometry><material name="print"/></visual>
    <collision><origin xyz="1.71015e-11 0.0039 -0.042" rpy="0 0 0"/><geometry><box size="0.00799895 0.00779796 0.0399948"/></geometry></collision>
    <visual><origin xyz="0.00675 0.002 -0.042" rpy="0 0 0"/><geometry><box size="0.0054989 0.0039992 0.039992"/></geometry><material name="print"/></visual>
    <collision><origin xyz="0.00675 0.002 -0.042" rpy="0 0 0"/><geometry><box size="0.0054989 0.0039992 0.039992"/></geometry></collision>
    <visual><origin xyz="0.0115 0.007 -0.042" rpy="0 0 0"/><geometry><box size="0.0039992 0.0139972 0.039992"/></geometry><material name="print"/></visual>
    <collision><origin xyz="0.0115 0.007 -0.042" rpy="0 0 0"/><geometry><box size="0.0039992 0.0139972 0.039992"/></geometry></collision>
    <visual><origin xyz="-0.0152412 0.002 -0.000162703" rpy="0 0 0"/><geometry><box size="0.00348189 0.0039992 0.0200921"/></geometry><material name="print"/></visual>
    <collision><origin xyz="-0.0152412 0.002 -0.000162703" rpy="0 0 0"/><geometry><box size="0.00348189 0.0039992 0.0200921"/></geometry></collision>
    <visual><origin xyz="-0.0115 0.007 -0.00605" rpy="0 0 0"/><geometry><box size="0.0039992 0.0139972 0.0318936"/></geometry><material name="print"/></visual>
    <collision><origin xyz="-0.0115 0.007 -0.00605" rpy="0 0 0"/><geometry><box size="0.0039992 0.0139972 0.0318936"/></geometry></collision>
    <visual><origin xyz="-4.86357e-10 0.002 -0.00605" rpy="0 0 0"/><geometry><box size="0.0189965 0.0039992 0.0318942"/></geometry><material name="print"/></visual>
    <collision><origin xyz="-4.86357e-10 0.002 -0.00605" rpy="0 0 0"/><geometry><box size="0.0189965 0.0039992 0.0318942"/></geometry></collision>
    <visual><origin xyz="0.0115 0.007 -0.00605" rpy="0 0 0"/><geometry><box size="0.0039992 0.0139972 0.0318936"/></geometry><material name="print"/></visual>
    <collision><origin xyz="0.0115 0.007 -0.00605" rpy="0 0 0"/><geometry><box size="0.0039992 0.0139972 0.0318936"/></geometry></collision>
    <visual><origin xyz="0.0152412 0.002 -0.000162703" rpy="0 0 0"/><geometry><box size="0.00348189 0.0039992 0.0200921"/></geometry><material name="print"/></visual>
    <collision><origin xyz="0.0152412 0.002 -0.000162703" rpy="0 0 0"/><geometry><box size="0.00348189 0.0039992 0.0200921"/></geometry></collision>
    <visual><origin xyz="1.19856e-10 0.002 0.0134353" rpy="0 0 0"/><geometry><box size="0.0273036 0.0039992 0.00706957"/></geometry><material name="print"/></visual>
    <collision><origin xyz="1.19856e-10 0.002 0.0134353" rpy="0 0 0"/><geometry><box size="0.0273036 0.0039992 0.00706957"/></geometry></collision>
    <visual><origin xyz="1.11022e-19 -0.001 0" rpy="1.570796 0 0"/><geometry><cylinder radius="0.009" length="0.002"/></geometry><material name="horn"/></visual>
  </link>
  <joint name="left_hip_roll" type="revolute">
    <parent link="torso"/><child link="left_hip"/>
    <origin xyz="0.049 0.057 -0.01075" rpy="0 0 0"/><axis xyz="1 0 0"/>
    <limit lower="-0.610865" upper="1.5708" effort="1.1964" velocity="5.23599"/>
    <dynamics damping="0.2285" friction="0.02"/>
  </joint>
  <joint name="left_hip_pitch" type="revolute">
    <parent link="left_hip"/><child link="left_thigh"/>
    <origin xyz="0.04 0.064 -0.01075" rpy="0 0 0"/><axis xyz="0 1 0"/>
    <limit lower="-1.5708" upper="1.0821" effort="1.1964" velocity="5.23599"/>
    <dynamics damping="0.2285" friction="0.02"/>
  </joint>
  <joint name="left_knee" type="revolute">
    <parent link="left_thigh"/><child link="left_shin"/>
    <origin xyz="-0 -0.0331 -0.0824" rpy="0 0 0"/><axis xyz="0 1 0"/>
    <limit lower="-1.5708" upper="1.5708" effort="0.304" velocity="7.48048"/>
    <dynamics damping="0.040639" friction="0.02"/>
  </joint>
  <joint name="right_hip_roll" type="revolute">
    <parent link="torso"/><child link="right_hip"/>
    <origin xyz="0.049 -0.057 -0.01075" rpy="0 0 0"/><axis xyz="1 0 0"/>
    <limit lower="-1.5708" upper="0.558505" effort="1.1964" velocity="5.23599"/>
    <dynamics damping="0.2285" friction="0.02"/>
  </joint>
  <joint name="right_hip_pitch" type="revolute">
    <parent link="right_hip"/><child link="right_thigh"/>
    <origin xyz="0.04 -0.064 -0.01075" rpy="0 0 0"/><axis xyz="0 1 0"/>
    <limit lower="-1.5708" upper="1.0821" effort="1.1964" velocity="5.23599"/>
    <dynamics damping="0.2285" friction="0.02"/>
  </joint>
  <joint name="right_knee" type="revolute">
    <parent link="right_thigh"/><child link="right_shin"/>
    <origin xyz="-0 0.0331 -0.0824" rpy="0 0 0"/><axis xyz="0 1 0"/>
    <limit lower="-1.5708" upper="1.5708" effort="0.304" velocity="7.48048"/>
    <dynamics damping="0.040639" friction="0.02"/>
  </joint>
</robot>
