eoinjordan/botbuilder/robot/microduck-look/microduck_look.urdf

<?xml version="1.0"?>
<!-- Generated by scripts/run_look.py. Do not edit. Shapes adapted from the Microduck by Pollen Robotics, CC BY-NC-SA 4.0. -->
<robot name="microduck_look">
  <link name="trunk">
    <inertial><origin xyz="-0.0437145 -0.000104637 0.00966253" rpy="0 0 0"/><mass value="0.2645"/><inertia ixx="0.000315445" ixy="1.1889e-06" ixz="-8.52671e-05" iyy="0.000575352" iyz="6.49174e-07" izz="0.000525171"/></inertial>
    <visual><origin xyz="-0.0255 -0.000320131 0.00016" rpy="0 0 0"/><geometry><box size="0.14 0.0795533 0.11268"/></geometry></visual>
    <visual><origin xyz="-0.00746541 -0.0024375 0.0263447" rpy="-1.5708 -0 0"/><geometry><mesh filename="../../stl/microduck-look/body_left.stl" scale="0.001 0.001 0.001"/></geometry></visual>
    <visual><origin xyz="-0.00741729 -0.000625 0.0265446" rpy="1.5708 -0 0"/><geometry><mesh filename="../../stl/microduck-look/body_right.stl" scale="0.001 0.001 0.001"/></geometry></visual>
    <visual><origin xyz="0.0445 -0.00031069 0.00016" rpy="0 -1.5708 0"/><geometry><mesh filename="../../stl/microduck-look/trunk_frame.stl" scale="0.001 0.001 0.001"/></geometry></visual>
    <collision><origin xyz="-0.0255 -0.000320131 0.00016" rpy="0 0 0"/><geometry><box size="0.14 0.0795533 0.11268"/></geometry></collision>
  </link>
  <link name="left_hip_yaw">
    <inertial><origin xyz="-0.0105539 -0.00488419 -0.0299952" rpy="0 0 0"/><mass value="0.072"/><inertia ixx="1.60718e-05" ixy="-3.76634e-08" ixz="-2.86777e-07" iyy="2.28836e-05" iyz="-2.21111e-07" izz="1.29924e-05"/></inertial>
    <visual><origin xyz="-0.0097 -0.003825 -0.0291875" rpy="0 0 0"/><geometry><box size="0.0454 0.02865 0.058375"/></geometry></visual>
    <visual><origin xyz="-0.01095 -0.003825 0" rpy="3.14159 -0 0"/><geometry><mesh filename="../../stl/microduck-look/left_hip_yaw.stl" scale="0.001 0.001 0.001"/></geometry></visual>
    <collision><origin xyz="-0.0097 -0.003825 -0.0291875" rpy="0 0 0"/><geometry><box size="0.0454 0.02865 0.058375"/></geometry></collision>
  </link>
  <link name="left_hip_roll">
    <inertial><origin xyz="-0.00419908 0.0189253 0.00180532" rpy="0 0 0"/><mass value="0.0035"/><inertia ixx="7.0639e-07" ixy="1.93819e-07" ixz="4.41188e-08" iyy="3.7735e-07" iyz="-6.44478e-08" izz="7.69604e-07"/></inertial>
    <visual><origin xyz="-0.011125 0.0093125 0.00225" rpy="0 0 0"/><geometry><box size="0.02825 0.042625 0.0285"/></geometry></visual>
    <visual><origin xyz="0.003 0.0093125 0.00225" rpy="0 -1.5708 0"/><geometry><mesh filename="../../stl/microduck-look/left_hip_roll.stl" scale="0.001 0.001 0.001"/></geometry></visual>
    <collision><origin xyz="-0.011125 0.0093125 0.00225" rpy="0 0 0"/><geometry><box size="0.02825 0.042625 0.0285"/></geometry></collision>
  </link>
  <link name="left_thigh">
    <inertial><origin xyz="-0.0302342 0.026704 -0.00820456" rpy="0 0 0"/><mass value="0.1502"/><inertia ixx="4.90286e-05" ixy="6.77347e-08" ixz="-2.40233e-05" iyy="0.000101175" iyz="-1.56521e-07" izz="9.44913e-05"/></inertial>
    <visual><origin xyz="-0.0244975 0.0252 -0.013719" rpy="0 0 0"/><geometry><box size="0.0824951 0.0454 0.0610619"/></geometry></visual>
    <visual><origin xyz="-0.0262975 0.0479 -0.0129438" rpy="1.5708 -0 0"/><geometry><mesh filename="../../stl/microduck-look/left_thigh.stl" scale="0.001 0.001 0.001"/></geometry></visual>
    <collision><origin xyz="-0.0244975 0.0252 -0.013719" rpy="0 0 0"/><geometry><box size="0.0824951 0.0454 0.0610619"/></geometry></collision>
  </link>
  <link name="left_shin">
    <inertial><origin xyz="-3.34663e-10 0.0188606 -0.0475487" rpy="0 0 0"/><mass value="0.072"/><inertia ixx="2.52417e-05" ixy="-1.52619e-13" ixz="-4.53736e-14" iyy="1.78044e-05" iyz="1.48646e-06" izz="1.35545e-05"/></inertial>
    <visual><origin xyz="0 0.02 -0.031875" rpy="0 0 0"/><geometry><box size="0.0263 0.046 0.08775"/></geometry></visual>
    <visual><origin xyz="0 -0.003 -0.030075" rpy="-1.5708 -0 0"/><geometry><mesh filename="../../stl/microduck-look/left_shin.stl" scale="0.001 0.001 0.001"/></geometry></visual>
    <collision><origin xyz="0 0.02 -0.031875" rpy="0 0 0"/><geometry><box size="0.0263 0.046 0.08775"/></geometry></collision>
  </link>
  <link name="left_foot">
    <inertial><origin xyz="0.00970274 -0.0283647 -0.0211311" rpy="0 0 0"/><mass value="0.0461"/><inertia ixx="2.50631e-05" ixy="3.59226e-07" ixz="-3.11919e-07" iyy="1.88837e-05" iyz="-4.12856e-06" izz="3.90904e-05"/></inertial>
    <visual><origin xyz="0.00884752 -0.0414637 -0.00918061" rpy="0 0 0"/><geometry><box size="0.0662831 0.0890725 0.0441388"/></geometry></visual>
    <visual><origin xyz="0.00884752 -0.0414637 -0.03125" rpy="0 -0 0"/><geometry><mesh filename="../../stl/microduck-look/left_foot.stl" scale="0.001 0.001 0.001"/></geometry></visual>
    <collision><origin xyz="0.00884752 -0.0414637 -0.00918061" rpy="0 0 0"/><geometry><box size="0.0662831 0.0890725 0.0441388"/></geometry></collision>
  </link>
  <link name="right_hip_yaw">
    <inertial><origin xyz="-0.0105539 0.00488419 -0.0299952" rpy="0 0 0"/><mass value="0.072"/><inertia ixx="1.60718e-05" ixy="3.76634e-08" ixz="-2.86777e-07" iyy="2.28836e-05" iyz="2.21111e-07" izz="1.29924e-05"/></inertial>
    <visual><origin xyz="-0.0097 0.003825 -0.0291875" rpy="0 0 0"/><geometry><box size="0.0454 0.02865 0.058375"/></geometry></visual>
    <visual><origin xyz="-0.01095 0.003825 0" rpy="3.14159 -0 0"/><geometry><mesh filename="../../stl/microduck-look/right_hip_yaw.stl" scale="0.001 0.001 0.001"/></geometry></visual>
    <collision><origin xyz="-0.0097 0.003825 -0.0291875" rpy="0 0 0"/><geometry><box size="0.0454 0.02865 0.058375"/></geometry></collision>
  </link>
  <link name="right_hip_roll">
    <inertial><origin xyz="-0.00419908 -0.0189253 0.00180532" rpy="0 0 0"/><mass value="0.0035"/><inertia ixx="7.0639e-07" ixy="-1.93819e-07" ixz="4.41188e-08" iyy="3.7735e-07" iyz="6.44478e-08" izz="7.69604e-07"/></inertial>
    <visual><origin xyz="-0.011125 -0.0093125 0.00225" rpy="0 0 0"/><geometry><box size="0.02825 0.042625 0.0285"/></geometry></visual>
    <visual><origin xyz="0.003 -0.0093125 0.00225" rpy="0 -1.5708 0"/><geometry><mesh filename="../../stl/microduck-look/right_hip_roll.stl" scale="0.001 0.001 0.001"/></geometry></visual>
    <collision><origin xyz="-0.011125 -0.0093125 0.00225" rpy="0 0 0"/><geometry><box size="0.02825 0.042625 0.0285"/></geometry></collision>
  </link>
  <link name="right_thigh">
    <inertial><origin xyz="-0.0302342 -0.026704 -0.00820456" rpy="0 0 0"/><mass value="0.1502"/><inertia ixx="4.90286e-05" ixy="-6.77347e-08" ixz="-2.40233e-05" iyy="0.000101175" iyz="1.56521e-07" izz="9.44913e-05"/></inertial>
    <visual><origin xyz="-0.0244975 -0.0252 -0.013719" rpy="0 0 0"/><geometry><box size="0.0824951 0.0454 0.0610619"/></geometry></visual>
    <visual><origin xyz="-0.0262975 -0.0479 -0.0129438" rpy="-1.5708 -0 0"/><geometry><mesh filename="../../stl/microduck-look/right_thigh.stl" scale="0.001 0.001 0.001"/></geometry></visual>
    <collision><origin xyz="-0.0244975 -0.0252 -0.013719" rpy="0 0 0"/><geometry><box size="0.0824951 0.0454 0.0610619"/></geometry></collision>
  </link>
  <link name="right_shin">
    <inertial><origin xyz="-3.34663e-10 -0.0188606 -0.0475487" rpy="0 0 0"/><mass value="0.072"/><inertia ixx="2.52417e-05" ixy="1.52619e-13" ixz="-4.53736e-14" iyy="1.78044e-05" iyz="-1.48646e-06" izz="1.35545e-05"/></inertial>
    <visual><origin xyz="0 -0.02 -0.031875" rpy="0 0 0"/><geometry><box size="0.0263 0.046 0.08775"/></geometry></visual>
    <visual><origin xyz="0 0.003 -0.030075" rpy="1.5708 -0 0"/><geometry><mesh filename="../../stl/microduck-look/right_shin.stl" scale="0.001 0.001 0.001"/></geometry></visual>
    <collision><origin xyz="0 -0.02 -0.031875" rpy="0 0 0"/><geometry><box size="0.0263 0.046 0.08775"/></geometry></collision>
  </link>
  <link name="right_foot">
    <inertial><origin xyz="0.00970281 0.0283595 -0.0211301" rpy="0 0 0"/><mass value="0.0461"/><inertia ixx="2.50671e-05" ixy="-3.59385e-07" ixz="-3.12051e-07" iyy="1.88892e-05" iyz="4.12917e-06" izz="3.90986e-05"/></inertial>
    <visual><origin xyz="0.00884752 0.0414637 -0.00918061" rpy="0 0 0"/><geometry><box size="0.0662831 0.0890725 0.0441388"/></geometry></visual>
    <visual><origin xyz="0.00884752 0.0414637 -0.03125" rpy="0 -0 0"/><geometry><mesh filename="../../stl/microduck-look/right_foot.stl" scale="0.001 0.001 0.001"/></geometry></visual>
    <collision><origin xyz="0.00884752 0.0414637 -0.00918061" rpy="0 0 0"/><geometry><box size="0.0662831 0.0890725 0.0441388"/></geometry></collision>
  </link>
  <link name="neck">
    <inertial><origin xyz="3.94666e-10 -0.0201043 0.0312552" rpy="0 0 0"/><mass value="0.0655"/><inertia ixx="4.83465e-05" ixy="1.33897e-13" ixz="2.19072e-16" iyy="4.52124e-05" iyz="5.01662e-09" izz="7.04715e-06"/></inertial>
    <visual><origin xyz="0 -0.019 0.03125" rpy="0 0 0"/><geometry><box size="0.0223 0.034 0.088"/></geometry></visual>
    <visual><origin xyz="0 -0.036 0.03125" rpy="-1.5708 -0 0"/><geometry><mesh filename="../../stl/microduck-look/neck.stl" scale="0.001 0.001 0.001"/></geometry></visual>
    <collision><origin xyz="0 -0.019 0.03125" rpy="0 0 0"/><geometry><box size="0.0223 0.034 0.088"/></geometry></collision>
  </link>
  <link name="head_pitch">
    <inertial><origin xyz="-1.94617e-11 -0.00650475 0.0112249" rpy="0 0 0"/><mass value="0.0024"/><inertia ixx="3.71125e-07" ixy="2.47063e-16" ixz="-6.84522e-16" iyy="2.4432e-07" iyz="1.06146e-07" izz="3.01866e-07"/></inertial>
    <visual><origin xyz="0 -0.0120625 0.003875" rpy="0 0 0"/><geometry><box size="0.022 0.030125 0.02875"/></geometry></visual>
    <visual><origin xyz="0 -0.0120625 0.01825" rpy="3.14159 -0 0"/><geometry><mesh filename="../../stl/microduck-look/head_pitch_yoke.stl" scale="0.001 0.001 0.001"/></geometry></visual>
    <collision><origin xyz="0 -0.0120625 0.003875" rpy="0 0 0"/><geometry><box size="0.022 0.030125 0.02875"/></geometry></collision>
  </link>
  <link name="head_yaw">
    <inertial><origin xyz="0.00473717 1.09199e-19 0.0192433" rpy="0 0 0"/><mass value="0.0148"/><inertia ixx="1.3492e-06" ixy="-1.78114e-23" ixz="5.51584e-08" iyy="2.95102e-06" iyz="1.21731e-22" izz="2.27557e-06"/></inertial>
    <visual><origin xyz="0.0027375 0 0.01745" rpy="0 0 0"/><geometry><box size="0.050225 0.0183 0.0309"/></geometry></visual>
    <visual><origin xyz="0.0027375 0 0.0105" rpy="0 -0 0"/><geometry><mesh filename="../../stl/microduck-look/head_yaw_carrier.stl" scale="0.001 0.001 0.001"/></geometry></visual>
    <collision><origin xyz="0.0027375 0 0.01745" rpy="0 0 0"/><geometry><box size="0.050225 0.0183 0.0309"/></geometry></collision>
  </link>
  <link name="head">
    <inertial><origin xyz="0.0343626 0.000362726 0.00869859" rpy="0 0 0"/><mass value="0.1686"/><inertia ixx="0.000219407" ixy="7.42326e-07" ixz="-5.3285e-05" iyy="0.000431994" iyz="-5.53918e-08" izz="0.000515411"/></inertial>
    <visual><origin xyz="0.0285539 -1.13e-06 0.0154258" rpy="0 0 0"/><geometry><box size="0.153358 0.114133 0.0730767"/></geometry></visual>
    <visual><origin xyz="0.0247251 3e-08 -0.0211126" rpy="0 -0 0"/><geometry><mesh filename="../../stl/microduck-look/head_base.stl" scale="0.001 0.001 0.001"/></geometry></visual>
    <visual><origin xyz="0.105233 -1.13e-06 0.0231784" rpy="0 -1.5708 0"/><geometry><mesh filename="../../stl/microduck-look/head_top.stl" scale="0.001 0.001 0.001"/></geometry></visual>
    <visual><origin xyz="0.101625 -0.00011422 0.021259" rpy="0 -1.5708 0"/><geometry><mesh filename="../../stl/microduck-look/head_face.stl" scale="0.001 0.001 0.001"/></geometry></visual>
    <visual><origin xyz="0.0746402 2e-08 -0.0114363" rpy="0 -0 0"/><geometry><mesh filename="../../stl/microduck-look/beak_top.stl" scale="0.001 0.001 0.001"/></geometry></visual>
    <collision><origin xyz="0.0285539 -1.13e-06 0.0154258" rpy="0 0 0"/><geometry><box size="0.153358 0.114133 0.0730767"/></geometry></collision>
  </link>
  <link name="beak">
    <inertial><origin xyz="0.0485263 -0.0487885 -0.0180303" rpy="0 0 0"/><mass value="0.0294"/><inertia ixx="3.79713e-05" ixy="-9.14453e-07" ixz="1.92647e-06" iyy="1.15204e-05" iyz="3.30036e-07" izz="4.737e-05"/></inertial>
    <visual><origin xyz="0.0315442 -0.048125 -0.00725277" rpy="0 0 0"/><geometry><box size="0.085396 0.113609 0.0365206"/></geometry></visual>
    <visual><origin xyz="0.0315442 -0.048125 -0.0255131" rpy="0 -0 0"/><geometry><mesh filename="../../stl/microduck-look/beak_jaw.stl" scale="0.001 0.001 0.001"/></geometry></visual>
    <collision><origin xyz="0.0315442 -0.048125 -0.00725277" rpy="0 0 0"/><geometry><box size="0.085396 0.113609 0.0365206"/></geometry></collision>
  </link>
  <joint name="left_hip_yaw" type="revolute">
    <parent link="trunk"/><child link="left_hip_yaw"/>
    <origin xyz="0.0075 0.021875 -0.00625" rpy="0 0 0"/><axis xyz="0 0 -1"/>
    <limit lower="-0.15708" upper="0.523599" effort="0.304" velocity="7.48048"/>
    <dynamics damping="0.040639" friction="0.02"/>
  </joint>
  <joint name="left_hip_roll" type="revolute">
    <parent link="left_hip_yaw"/><child link="left_hip_roll"/>
    <origin xyz="0.0155 -0.005 -0.020125" rpy="0 0 0"/><axis xyz="1 0 0"/>
    <limit lower="-0.0523599" upper="0.383972" effort="1.196" velocity="5.23599"/>
    <dynamics damping="0.22842" friction="0.02"/>
  </joint>
  <joint name="left_hip_pitch" type="revolute">
    <parent link="left_hip_roll"/><child link="left_thigh"/>
    <origin xyz="-0.01325 0.030625 0.0045" rpy="0 0 0"/><axis xyz="0 1 0"/>
    <limit lower="-1.55334" upper="1.53589" effort="1.196" velocity="5.23599"/>
    <dynamics damping="0.22842" friction="0.02"/>
  </joint>
  <joint name="left_knee" type="revolute">
    <parent link="left_thigh"/><child link="left_shin"/>
    <origin xyz="-0.0495 0 -0.0275" rpy="0 0 0"/><axis xyz="0 -1 0"/>
    <limit lower="-1.53589" upper="1.44862" effort="1.196" velocity="5.23599"/>
    <dynamics damping="0.22842" friction="0.02"/>
  </joint>
  <joint name="left_ankle" type="revolute">
    <parent link="left_shin"/><child link="left_foot"/>
    <origin xyz="0 0.0455 -0.059" rpy="0 0 0"/><axis xyz="0 1 0"/>
    <limit lower="-1.29154" upper="1.22173" effort="1.196" velocity="5.23599"/>
    <dynamics damping="0.22842" friction="0.02"/>
  </joint>
  <joint name="right_hip_yaw" type="revolute">
    <parent link="trunk"/><child link="right_hip_yaw"/>
    <origin xyz="0.0075 -0.021875 -0.00625" rpy="0 0 0"/><axis xyz="0 0 -1"/>
    <limit lower="-0.523599" upper="0.15708" effort="0.304" velocity="7.48048"/>
    <dynamics damping="0.040639" friction="0.02"/>
  </joint>
  <joint name="right_hip_roll" type="revolute">
    <parent link="right_hip_yaw"/><child link="right_hip_roll"/>
    <origin xyz="0.0155 0.005 -0.020125" rpy="0 0 0"/><axis xyz="1 0 0"/>
    <limit lower="-0.383972" upper="0.0523599" effort="1.196" velocity="5.23599"/>
    <dynamics damping="0.22842" friction="0.02"/>
  </joint>
  <joint name="right_hip_pitch" type="revolute">
    <parent link="right_hip_roll"/><child link="right_thigh"/>
    <origin xyz="-0.01325 -0.030625 0.0045" rpy="0 0 0"/><axis xyz="0 -1 0"/>
    <limit lower="-1.53589" upper="1.55334" effort="1.196" velocity="5.23599"/>
    <dynamics damping="0.22842" friction="0.02"/>
  </joint>
  <joint name="right_knee" type="revolute">
    <parent link="right_thigh"/><child link="right_shin"/>
    <origin xyz="-0.0495 0 -0.0275" rpy="0 0 0"/><axis xyz="0 1 0"/>
    <limit lower="-1.44862" upper="1.53589" effort="1.196" velocity="5.23599"/>
    <dynamics damping="0.22842" friction="0.02"/>
  </joint>
  <joint name="right_ankle" type="revolute">
    <parent link="right_shin"/><child link="right_foot"/>
    <origin xyz="0 -0.0455 -0.059" rpy="0 0 0"/><axis xyz="0 -1 0"/>
    <limit lower="-1.22173" upper="1.29154" effort="1.196" velocity="5.23599"/>
    <dynamics damping="0.22842" friction="0.02"/>
  </joint>
  <joint name="neck_pitch" type="revolute">
    <parent link="trunk"/><child link="neck"/>
    <origin xyz="0.0325 0.018125 0.0405" rpy="0 0 0"/><axis xyz="0 -1 0"/>
    <limit lower="-1.5708" upper="0.680678" effort="0.304" velocity="7.48048"/>
    <dynamics damping="0.040639" friction="0.02"/>
  </joint>
  <joint name="head_pitch" type="revolute">
    <parent link="neck"/><child link="head_pitch"/>
    <origin xyz="0 0 0.0625" rpy="0 0 0"/><axis xyz="0 1 0"/>
    <limit lower="-1.09956" upper="1.5708" effort="0.304" velocity="7.48048"/>
    <dynamics damping="0.040639" friction="0.02"/>
  </joint>
  <joint name="head_yaw" type="revolute">
    <parent link="head_pitch"/><child link="head_yaw"/>
    <origin xyz="0 -0.018125 0.01825" rpy="0 0 0"/><axis xyz="0 0 1"/>
    <limit lower="-1.5708" upper="1.5708" effort="0.157" velocity="10.472"/>
    <dynamics damping="0.014992" friction="0.02"/>
  </joint>
  <joint name="head_roll" type="revolute">
    <parent link="head_yaw"/><child link="head"/>
    <origin xyz="-0.022375 0 0.02325" rpy="0 0 0"/><axis xyz="-1 0 0"/>
    <limit lower="-0.436332" upper="0.436332" effort="0.157" velocity="10.472"/>
    <dynamics damping="0.014992" friction="0.02"/>
  </joint>
  <joint name="beak" type="revolute">
    <parent link="head"/><child link="beak"/>
    <origin xyz="0.0225 0.048125 0.004" rpy="0 0 0"/><axis xyz="0 1 0"/>
    <limit lower="0" upper="0.523599" effort="0.157" velocity="10.472"/>
    <dynamics damping="0.014992" friction="0.02"/>
  </joint>
</robot>
