eoinjordan/botbuilder/microduck/look/page.py

# SPDX-License-Identifier: MIT
"""Write docs/microduck-look.md from the reports of the Microduck-look build."""
from __future__ import annotations

import json

from . import combfeet
from .install import LICENCE_LINE, PARTS, SOURCE_MODEL, SOURCES, feet_compared
from .model import JOINTS, ROOT, parameters

PAGE = ROOT / "docs" / "microduck-look.md"
IMG = "../stl/microduck-look/images/"


def _load(name: str):
    path = ROOT / "reports" / "microduck-look" / name
    return json.loads(path.read_text(encoding="utf-8")) if path.is_file() else None


def _table(header, rows) -> list:
    out = ["| " + " | ".join(header) + " |", "|" + "---|" * len(header)]
    out += ["| " + " | ".join(str(c) for c in row) + " |" for row in rows]
    return out


def _yes(value) -> str:
    return "yes" if value else "no"


def markdown() -> str:
    rep, sim, p = _load("assembly.json"), _load("sim.json"), parameters()
    build = json.loads((ROOT / "config" / "microduck-look" / "build.json").read_text(encoding="utf-8"))
    dims, mass, stand, feet = rep["dimensions"], rep["mass"], rep["stand_pose"], rep["one_foot"]
    count = rep["servo_count"]
    L = []
    add = L.append
    add("# Biped, Microduck look")
    add("")
    add("Generated by `scripts/run_look.py` from `reports/microduck-look/`. Do not edit by hand.")
    add("")
    add(f"A second biped beside the plate biped: the shells of Pollen Robotics' Microduck, scaled by {rep['scale']} and re-split for printing, "
        f"on the servos of two TinkerKit Braccio kits. Fifteen servos at the original's fifteen positions: {count['SR431']} SR431 and {count['SR311']} SR311 "
        f"on the ten leg joints, neck pitch and head pitch, and {count['M5_180']} small position servos on head yaw, head roll and the beak.")
    add("")
    add("The three small servos must be position servos: the M5Stack Servo Kit 180 (9 g, 0 to 180 degrees). The Servo Kit 360 and the "
        "servos of a BALA-C turn continuously: a pulse sets their speed, not an angle, so they cannot hold a joint. "
        "Without the small servos the head yaw, head roll and beak joints stay as fitted and the other twelve joints work.")
    add("")
    add(f"Source model: {SOURCE_MODEL}. {LICENCE_LINE}. That covers every file in `stl/microduck-look/`, the comb feet included. "
        "The credit and the list of changes are in `stl/microduck-look/LICENSE`. The code is MIT.")
    add("")
    add("All numbers on this page come from the digital assembly and the simulation. What was assumed is in [status.md](status.md).")
    add("")
    add(f"![front]({IMG}look-front.png) ![side]({IMG}look-side.png)")
    add("")
    add(f"![three-quarter]({IMG}look-three-quarter.png) ![back]({IMG}look-back.png)")
    add("")
    add("## Size and mass")
    add("")
    L.extend(_table(["", "this build", "the original"], [
        ["scale", rep["scale"], 1],
        ["height (mm)", f"{dims['height_stand_mm']} at the stand pose, {dims['height_zero_pose_mm']} with every joint at zero", f"{dims['original_height_mm_in_the_source_meshes']} in the source meshes"],
        ["width, length (mm)", f"{dims['width_mm']}, {dims['length_mm']}", ""],
        ["mass (kg)", mass["total_kg"], f"{mass['original_kg_in_its_simulation_model']} in its simulation model; scaled by volume that is {mass['original_scaled_by_volume_kg']}"],
        ["servos", f"{count['SR431']} SR431, {count['SR311']} SR311, {count['M5_180']} small", "15 Dynamixel XL330"],
    ]))
    add("")
    add("Mass by group (g): " + ", ".join(f"{k} {v}" for k, v in mass["by_group_g"].items()) + ". Wiring is not counted.")
    add("")
    add("## Scale")
    add("")
    add("The original is built round a servo 34 x 20 x 26 mm. An SR431 is 42 x 20.5 x 39.5 mm. At 42 / 34 = 1.235 an SR431 is as long as the "
        "original's servo, scaled, and no wider; 1.25 is that rounded up. It is the smallest scale at which the knee and hip pitch servos lie under the "
        "thigh cover as the original's do and the ankle servo is the shin, as the original's is. The case is 9 mm deeper along its shaft than the scaled "
        "servo, and a leg rolled inward has to clear the hip roll servo, so the thighs stand 6 mm and the feet 8.5 mm further out than scaled. "
        "Three axes moved so that the cases, their mounting ears and the parts on them clear each other: hip pitch 4.75 mm forward, "
        "hip roll 4.5 mm down and 5 mm inward, ankle 6.5 mm down. A smaller scale needs a smaller leg servo: see the "
        "assignments below.")
    add("")
    add(f"![section through the left leg]({IMG}look-section-leg.png) ![section on the centre plane]({IMG}look-section-centre.png)")
    add("")
    add(f"![section through the hips]({IMG}look-section-hips.png)")
    add("")
    add("The servo cases are red in the sections. Hidden: hip yaw (in the trunk under the body shell), hip pitch and knee (under the thigh cover), "
        "head yaw, head roll and beak (in the head). In the open, where the original has its servos in the open: hip roll between the legs, "
        "the ankle servo as the shin, the two neck servos. The mounting ears of the hip pitch and knee servos show at the front and under the thigh cover.")
    add("")
    add("## Which servo where")
    add("")
    add("Three assignments on the same printed structure and scale. A servo is asked to hold at most half of its stall torque. "
        "The worst case is over standing on two feet, standing with all weight on one foot, the one-foot pose, a step with the hips 12 degrees "
        "either way, and the neck and head moved.")
    add("")
    rows = []
    for name, a in rep["assignments"].items():
        s = a["servos"]
        over = ", ".join(a["over_hold_limit"]) or "none"
        rows.append([name, f"{s.get('SR431', 0)} SR431, {s.get('SR311', 0)} SR311, {s.get('M5_180', 0)} small", a["mass_kg"], a["leg_mass_kg"],
                     f"{a['worst_required_over_hold_limit']} ({a['worst_joint']})", over])
    L.extend(_table(["assignment", "servos", "mass (kg)", "one leg (kg)", "worst holding torque / limit", "joints over the limit"], rows))
    add("")
    add("- One kit, lightest: the knees and ankles on SR431, hip pitch on SR311, everything else on small servos. The small servos cannot hold "
        "hip roll or the neck directly; they would need a printed 3:1 reduction, which leaves 60 degrees of travel and adds backlash where the trunk is balanced.")
    add("- Two kits, built: every leg joint and both neck joints on a Braccio servo, no gears. Heaviest, and the only one with every joint inside its limit "
        "apart from the neck at the end of its range.")
    add("- Two kits, light hips: hip yaw on small servos and hip roll on SR311 saves mass at the hips and leaves two SR431 unused; hip roll is then over its limit "
        "whenever the weight is on one foot.")
    add("")
    add("A scale of 1.0, the closest look, needs leg servos no larger than the original's. Of what is in the kits only the SR311 is (31.3 x 16.5 x 28.6 mm), "
        "and four of them cannot hold the knees and ankles: the built assignment asks " +
        f"{rep['torque']['left_ankle']['required_nm']} N m of an ankle and {rep['torque']['left_knee']['required_nm']} N m of a knee at 1.25, "
        "and about 0.4 times that at 1.0 on a lighter robot, against 0.152 N m.")
    add("")
    add("## Joints")
    add("")
    rows = []
    for j in JOINTS:
        t, r = rep["torque"][j], rep["joint_ranges"][j]
        o = r["original_range_deg"]
        stops = "; ".join(f"{end}: {r[end + '_set_by']}" for end in ("min", "max") if r[end + "_set_by"] != "servo travel" and r[end + "_deg"] not in (o[0], o[1]))
        rows.append([j, t["servo"], t["required_nm"], t["hold_limit_nm"], t["required_over_hold_limit"], t["worst_case"],
                     f"{r['min_deg']} to {r['max_deg']}", f"{o[0]} to {o[1]}", r["part_of_original_range"], stops or ""])
    L.extend(_table(["joint", "servo", "holds (N m)", "limit (N m)", "ratio", "in", "range (deg)", "original (deg)", "part", "stopped by"], rows))
    add("")
    add("Ranges are collision-free travel of one joint from the stand pose, less 3 degrees, inside the servo's 180 degrees and the original's range. "
        "The beak has no joint in the original's description; 0 to 30 degrees is this build's.")
    add("")
    sway = rep["sway_both_hips"]
    add("What is lost against the original:")
    add("")
    add("- Head yaw is 180 degrees of the original's 340: the servo's travel.")
    add("- Hip yaw outward stops early: the two hip yaw links, each carrying a hip roll servo, meet between the legs.")
    add("- One hip rolled inward alone meets the other foot's web after a few degrees. Both hips rolled the same way, "
        f"as in walking, are free for at least {min(sway['to_the_left_deg'], sway['to_the_right_deg'])} degrees each way.")
    add("- The neck holds the head 30 degrees forward at its limit; further forward it is over half of stall.")
    add("- Speed and feedback: the original's servos report position, speed and load; these do not. Its walking is a learned policy closed over an "
        "inertial sensor; this build's walk is open loop.")
    add("- No bearings: a joint hangs on its servo shaft, with a pivot screw opposite the horn at the neck, the head roll and the beak only.")
    add("")
    add("## Head and eye")
    add("")
    add("The original's eye is a camera. Default (`EYE = 'camera'`): an Espressif ESP-EYE on its side behind the face plate, lens in the centre of the "
        "eye ring. It is the project's default camera, weighs 8 g against 24 g for the display with its cell, and keeps the eye a camera. "
        "The picture is turned a quarter and has to be turned back in software. `CAMERA = 'esp32cam'` seats an AI-Thinker ESP32-CAM the same way. "
        "Option (`EYE = 'display'`): the Seeed round display as the eye. At this scale the eye ring is 37.5 mm across and the display's glass 40 mm, "
        "so one animated eye fills the ring's place; the XIAO behind it then has its camera facing backward, so this option has no forward camera. "
        "The generator makes either; the files here are the camera's.")
    add("")
    add("## Feet and balance")
    add("")
    add(f"The feet are the original's, scaled, with a {p['feet']} of 4 mm plate added under the body, 14 mm apart at the stand pose. "
        "The original's soles are 73 mm apart at this scale and its hip roll range is 22 degrees: rolling both hips that far leaves the centre of mass "
        "short of the inner edge of a sole. It walks dynamically. Open-loop hobby servos cannot, so the soles are widened inward until the centre of mass "
        "can stand over one of them. The webs do not cross the centre line. "
        "The trade: seen from the front the feet are wider than the original's and nearly meet.")
    add("")
    add("The pose on one foot below is a static one: the trunk tilted over a flat sole. The legs have no ankle roll, as the original's have none, "
        "so the robot cannot move into that pose slowly: while both soles are down a roll of both hips leans the legs and sets the soles on their edges. "
        "The simulation shows it (see below). The weight has to be rocked from foot to foot, which is what the gait does. Soles whose fingers cross the "
        "centre line, as on the plate biped, let a foot be lifted with no shift at all; they do not look like the original's feet. "
        "They are the other choice of feet: see Comb feet below.")
    add("")
    rows = [["two feet, stand pose", "", stand["margin_mm"], "", ""]]
    for side in ("left", "right"):
        f = feet[side]
        if f.get("found"):
            rows.append([f"{side} foot, other lifted", f["roll_deg"], f["margin_mm"], f["swing_sole_height_mm"], len(f["interferences"])])
        else:
            rows.append([f"{side} foot, other lifted", "not found", f.get("margin_at_22_deg_mm", ""), "", ""])
    L.extend(_table(["pose", "both hips rolled (deg)", "centre of mass inside the support (mm)", "lifted sole above the floor (mm)", "overlapping parts"], rows))
    add("")
    add("Stand pose (deg): " + ", ".join(f"{j} {v}" for j, v in stand["q_deg"].items() if v) + ". The other joints are at zero.")
    add("")
    add(f"![on one foot]({IMG}look-one-foot.png)")
    add("")
    add("Gap between the two legs (mm) for the two hip roll angles, other joints at the stand pose; a negative number is an overlap in mm3:")
    add("")
    lt = rep["leg_clearance"]
    L.extend(_table(["left (rows), right (columns)"] + [str(a) for a in lt["hip_roll_deg"]],
                    [[a] + row for a, row in zip(lt["hip_roll_deg"], lt["gap_mm_or_minus_overlap_mm3"])]))
    add("")
    comb = rep.get("comb_feet")
    if comb:
        c = comb["comb_mm"]
        add("### Comb feet")
        add("")
        add("`left_foot_comb.stl` and `right_foot_comb.stl`, made from the two feet by `microduck/look/combfeet.py`: part of each web is cut away "
            f"and fingers {c['t']:g} mm thick and {c['finger_x']['right'][0][1] - c['finger_x']['right'][0][0]:g} mm wide, each with a rib on top, "
            f"reach {c['tip_past_centre']:g} mm past the centre line. The left foot has a finger at the heel and one at the toe, the right foot one "
            f"between them, with {c['clear_x']:g} mm fore and aft between a finger and the other foot and {c['clear_tip']:g} mm at each tip. "
            "They bolt to the ankle horn as the feet do; nothing else changes. "
            f"The robot is {round(comb['mass']['total_kg'] * 1000 - mass['total_kg'] * 1000, 1)} g heavier on them.")
        add("")
        add(f"![on the comb feet]({IMG}look-comb-feet.png)")
        add("")
        rows = [["two feet, stand pose", "", comb["stand_pose"]["margin_mm"], "", ""]]
        for side in ("left", "right"):
            f = comb["one_foot"][side]
            if f.get("found"):
                rows.append([f"{side} foot, other lifted", f["roll_deg"], f["margin_mm"], f["swing_sole_height_mm"], len(f["interferences"])])
            else:
                rows.append([f"{side} foot, other lifted", "not found", f.get("margin_at_22_deg_mm", ""), "", ""])
        L.extend(_table(["pose on the comb feet", "both hips rolled (deg)", "centre of mass inside the support (mm)", "lifted sole above the floor (mm)", "overlapping parts"], rows))
        add("")
        cz, cs = comb["interferences"]["zero_pose"], comb["interferences"]["stand_pose"]
        yaw, roll = comb["joint_ranges"]["left_hip_yaw"], comb["joint_ranges"]["left_hip_roll"]
        add(f"Overlaps above 8 mm3 on the comb feet: {len(cz)} with every joint at zero, {len(cs)} at the stand pose. "
            "What they cost: with both feet level the fingers lie between each other, so one hip turned alone is free for "
            f"{yaw['min_free_deg']} to {yaw['max_free_deg']} degrees of yaw (left hip; {rep['joint_ranges']['left_hip_yaw']['min_free_deg']} to "
            f"{rep['joint_ranges']['left_hip_yaw']['max_free_deg']} on the plain feet) and {roll['min_free_deg']} to {roll['max_free_deg']} degrees of roll "
            "before the fingers meet. Both hips rolled the same way are free for at least "
            f"{min(comb['sway_both_hips']['to_the_left_deg'], comb['sway_both_hips']['to_the_right_deg'])} degrees. A foot has to be lifted before it is turned. "
            "The joint table in `robot/microduck-look/joints.json` holds the limits of the plain feet; a controller for the comb feet needs a rule "
            "for the fingers, as the plate biped's control core has for its comb soles.")
        add("")
    add("## Assembly test")
    add("")
    z, s = rep["interferences"]["zero_pose"], rep["interferences"]["stand_pose"]
    add(f"Every printed part, servo, horn and board placed from `stl/microduck-look/parameters.json`. Overlaps above 8 mm3: {len(z)} with every joint at zero, "
        f"{len(s)} at the stand pose." + ("".join(f" {h['a']} with {h['b']}: {h['volume_mm3']} mm3." for h in z + s)))
    add(f"Servo cases have {rep['servo_clearance_in_cradle_mm']} mm each side in their cups. Boards and camera, nearest printed part or servo at the stand pose: "
        + "; ".join((f"{g['part']} rests on {g['nearest']}" if g["gap_mm"] < 0.05 else f"{g['part']} {g['gap_mm']} mm from {g['nearest']}")
                    for g in rep["bought_part_gaps"]) + ".")
    add("")
    if sim:
        walk, st = sim["walk"], sim["stand"]
        add("## Simulation")
        add("")
        add(f"`robot/microduck-look/microduck_look.xml`: {sim['mass_kg']} kg, inertia of each link from its meshes, servos and boards, so a leg carries its "
            f"{rep['assignments']['two kits, built']['leg_mass_kg']} kg where the servos are. Position servos that reach stall torque at a 4 degree error, "
            "commands at 50 Hz, 120 deg/s rate limit, one tick of delay. Parts collide with the floor only.")
        add("")
        peak = max(st["torque"], key=lambda j: st["torque"][j]["peak_over_limit"])
        add(f"- Stand, 10 s: {'falls' if st['fell'] else 'stays up'}, tilt at most {st['max_tilt_deg']} degrees, load {st['foot_load_n']['left']} N and "
            f"{st['foot_load_n']['right']} N on the feet, largest torque {st['torque'][peak]['peak_over_limit']} of stall ({peak}).")
        hm = sim["head_motion_while_standing"]
        peak = max(hm["torque"], key=lambda j: hm["torque"][j]["peak_over_limit"])
        add(f"- Neck, head and beak moved while standing: {'falls' if hm['fell'] else 'stays up'}, tilt at most {hm['max_tilt_deg']} degrees, "
            f"largest torque {hm['torque'][peak]['peak_over_limit']} of stall ({peak}).")
        for side in ("left", "right"):
            o = sim["one_foot"][side]
            if "held" in o and "fell" in o:
                worst = max(o["peak_torque_over_limit"], key=o["peak_torque_over_limit"].get)
                other = "right" if side == "left" else "left"
                verdict = ("the weight comes on to that sole" if o["held"] else
                           f"it does not come on to one sole: it rests on the edges of both, {o['foot_load_n'][side]} N and {o['foot_load_n'][other]} N, "
                           f"the trunk tilted {o['trunk_tilt_deg']} degrees where the pose has {o['trunk_tilt_of_the_pose_deg']}")
                add(f"- Both hips rolled slowly towards the {side} foot, then the other leg bent: {verdict}; largest torque "
                    f"{o['peak_torque_over_limit'][worst]} of stall ({worst}); meshes overlapping in {o['mesh_overlaps']['poses_with_overlap']} of "
                    f"{o['mesh_overlaps']['poses_checked']} poses on the way.")
        add("")
        sr = walk["search"]
        add(f"Walking attempt. The gait of `microduck/gait.py` carried to this joint set (both hips rolled, hips swung with the ankles turned against them, "
            f"the unloaded leg bent), searched with `microduck/cmaes.py` and scored with `microduck/gaitsearch.gait_score`: seed {sr['seed']}, "
            f"{sr['generations']} generations of {sr['popsize']}, {sr['simulated_runs']} runs of {sr['seconds_each']} s, {sr['wall_clock_s']} s of wall clock. "
            f"Parameters: {walk['params']}.")
        add("")
        ws = walk["stepping"]
        verdict = "It truly steps" if walk["truly_steps"] else ("It falls" if walk["fell"] else "It stays up and does not truly step")
        add(f"{verdict}: {ws['steps']} swings with a sole wholly off the floor of {ws['steps_commanded']} commanded in 30 s, median clearance {ws['median_clearance_mm']} mm, "
            f"step {ws['step_length_mm']} mm, {walk['speed_mm_s']} mm/s forward, heading change {walk['heading_change_deg']} degrees, "
            f"one foot loaded {round(ws['single_support_fraction'] * 100)} percent of the time.")
        mo = walk["mesh_overlaps"]
        add(f"The commanded poses of one gait cycle put through the exact meshes: {mo['poses_with_overlap']} of {mo['poses_checked']} overlap"
            + (" (" + "; ".join(mo["pairs"]) + ")." if mo["pairs"] else "."))
        if not walk["fell"] and abs(walk["speed_mm_s"]) < 5.0:
            add(f"The search settled on a stride of {walk['params']['step_amplitude_deg']} degrees at the hips, at the small end of what it was allowed (1 to 14): "
                "the model lifts each foot in turn and marks time, creeping forward. A longer stride scored worse on the three variations of "
                "the model it was tried on. That is the finding: it stands, shifts its weight and lifts its feet; it does not yet walk at a useful speed.")
        add("")
        L.extend(_table(["floor friction", "fell", "speed (mm/s)", "truly steps", "swings", "clearance (mm)", "heading change in 20 s (deg)"],
                        [[r["floor_friction"], _yes(r["fell"]), r["speed_mm_s"], _yes(r["truly_steps"]), r["steps"], r["clearance_mm"], r["heading_change_deg"]]
                         for r in walk["by_floor_friction"]]))
        add("")
        L.extend(_table(["joint", "peak torque walking (N m)", "stall (N m)", "peak / stall"],
                        [[j, walk["torque"][j]["peak_nm"], walk["torque"][j]["limit_nm"], walk["torque"][j]["peak_over_limit"]] for j in JOINTS if not j.startswith("right")]))
        add("")
        cur = walk["estimated_supply_current_a"]
        add("Supply current while walking, each servo taken to draw in proportion to its torque: "
            + "; ".join(f"{name} {v['mean']} A mean, {v['peak']} A peak" for name, v in cur.items()) + ". Each shield has a 4 A supply.")
        add("")
    both = feet_compared(sim)
    if both:
        cw = sim["comb_feet"]
        walk_c, sr = cw["walk"], cw["walk"]["search"]
        add("### Walking on each set of feet")
        add("")
        add(f"`robot/microduck-look/microduck_look_comb.xml` is the same model on the comb feet ({cw['mass_kg']} kg), each foot the slab under its sole "
            f"and fingers. The same search was run on it: seed {sr['seed']}, {sr['generations']} generations of {sr['popsize']}, {sr['simulated_runs']} runs of "
            f"{sr['seconds_each']} s, {sr['wall_clock_s']} s of wall clock. The simulation lets the two feet pass through each other, so on the comb feet the "
            "search also puts the feet of every candidate through their exact meshes for one gait cycle and refuses a gait in which they overlap. "
            f"Parameters found: {walk_c['params']} (`config/microduck-look/gait_comb.json`).")
        add("")
        rows = []
        for option, label in (("flat", "as generated, with the web"), ("comb", "comb")):
            r = both[option]
            rows.append([label, _yes(r["truly_steps"]), _yes(r["fell"]), r["speed_mm_s"], f"{r['steps']} of {r['steps_commanded']}", r["median_clearance_mm"],
                         r["step_length_mm"], round(r["single_support_fraction"] * 100), r["heading_change_deg"], r["max_tilt_deg"], r["poses_with_mesh_overlap"]])
        L.extend(_table(["feet", "truly steps", "fell", "speed (mm/s)", "swings in 30 s", "clearance (mm)", "step (mm)", "one foot loaded (percent)",
                         "heading change (deg)", "largest tilt (deg)", "poses of one cycle with overlapping meshes"], rows))
        add("")
        cst = cw["stand"]
        add(f"On the comb feet it stands for 10 s with a tilt of at most {cst['max_tilt_deg']} degrees.")
        for side in ("left", "right"):
            o = cw["one_foot"][side]
            if "held" in o and "fell" in o:
                other = "right" if side == "left" else "left"
                add(f"- Comb feet, the {other} leg bent slowly with the weight meant for the {side} foot: "
                    + ("the weight comes on to that sole" if o["held"] else
                       f"{'it falls' if o['fell'] else 'the weight does not come wholly on to that sole'}: {o['foot_load_n'][side]} N and {o['foot_load_n'][other]} N")
                    + f", largest tilt {o['max_tilt_deg']} degrees; meshes overlapping in {o['mesh_overlaps']['poses_with_overlap']} of "
                    f"{o['mesh_overlaps']['poses_checked']} poses on the way.")
        cross = cw.get("walk_with_the_gait_of_the_plain_feet")
        if cross:
            add(f"- The gait found for the plain feet, played on the comb feet: {'falls' if cross['fell'] else 'stays up'}, "
                f"{'truly steps' if cross['truly_steps'] else 'does not truly step'}, {cross['speed_mm_s']} mm/s, "
                f"{cross['stepping']['steps']} swings of {cross['stepping']['steps_commanded']}, the feet's meshes overlapping in "
                f"{cross['feet_overlap']['poses_with_overlap']} of {cross['feet_overlap']['poses_checked']} poses of one cycle.")
        add("")
        fast = both["faster"]
        if fast == "comb":
            add(f"In this simulation the comb feet walk faster: {both['comb']['speed_mm_s']} mm/s against {both['flat']['speed_mm_s']} mm/s.")
        elif fast == "flat":
            add(f"In this simulation the comb feet do not walk faster: {both['comb']['speed_mm_s']} mm/s against {both['flat']['speed_mm_s']} mm/s on the feet as generated.")
        else:
            add("In this simulation neither set of feet gives a gait that truly steps without the meshes overlapping.")
        strides = [both[option]["gait"]["step_amplitude_deg"] for option in ("flat", "comb")]
        if max(strides) < 2.0:
            add(f"Both gaits have a stride of {strides[0]} and {strides[1]} degrees at the hips, the small end of the 1 to 14 searched: "
                "on either set of feet the model lifts its feet in turn and creeps forward.")
        add("One search on one model for each: a difference of a few mm/s is within what another seed would move.")
        add("")
    add("## Signals and power")
    add("")
    L.extend(_table(["joint", "servo", "driven by", "output", "UNO Q pin"],
                    [[j, v["servo"], v["driven_by"], v["output"], v["pin"] if v["pin"] is not None else ""] for j, v in build["signals"].items()]))
    add("")
    for line in build["signal_notes"]:
        add("- " + line)
    sup = build["supply"]
    add(f"- Supply. Stalled demand of all fifteen servos: {sup['stall_demand_a']} A ({sup['per_board_stall_a']['board 1']} A on the first board with the driver, "
        f"{sup['per_board_stall_a']['board 2']} A on the second). The two kit supplies give {sup['kit_supplies_a']} A together, 4 A per shield. "
        "They cover standing and the walk above; they do not cover several servos stalled at once. Keep one supply per shield, fuse each, "
        "and do not join the two 5 V rails. For margin use a regulated 5 V 10 A supply per shield.")
    add("- The camera runs from its own USB supply. With the display as the eye, the display and its XIAO run from their own cell.")
    add("")
    add("## Control")
    add("")
    add("The firmware and the control core in this repository (`microduck/protocol.py` and its C++ twin) drive six joints on one board with soft limits, "
        "a speed limit, a watchdog and a leg clearance rule. Firmware for this build is not written. It needs: the joint table of "
        "`robot/microduck-look/joints.json` (fifteen joints, ranges, zero and direction per horn), the two boards acting as one controller or one board "
        "with a driver for all fifteen, the I2C driver for the three small servos, and a leg rule for the webs, which the table above shows can meet.")
    add("")
    add("## Print list")
    add("")
    rows = []
    for part in p["parts"]:
        if part["file"].startswith("right_"):
            continue
        name = part["file"].replace("left_", "left_ and right_") if part["file"].startswith("left_") else part["file"]
        rows.append([f"`{name}`", " x ".join(f"{v:.0f}" for v in part["size_mm"]), part["mass_g"], part["orientation"], part["supports"]])
    if combfeet.have():
        for part in combfeet.record()["parts"]:
            rows.append([f"`{part['file']}` (in place of `{part['replaces']}`)", " x ".join(f"{v:.0f}" for v in part["size_mm"]), part["mass_g"],
                         part["orientation"], part["supports"]])
    L.extend(_table(["file in `stl/microduck-look/`", "size as printed (mm)", "mass (g)", "orientation", "supports"], rows))
    add("")
    tri = rep["triangles"]
    add(f"Print the fit pieces first. The shells keep the source's walls, scaled: about 2.5 mm on the body and head, 1.2 mm on the thigh covers. "
        f"The files hold {tri['parts']} triangles; the source parts they come from hold {tri['source_parts_used']}. They follow the scaled surface "
        f"to within {tri['simplification_tolerance_mm']} mm (0.7 mm on the soles); texture finer than that is gone.")
    add("")
    add("## Parts")
    add("")
    L.extend(_table(["part", "quantity", "note"], [[part["name"], part["qty"], part["note"]] for part in PARTS]))
    add("")
    add("## What to order")
    add("")
    add("### To match the original exactly")
    add("")
    add("Build the original. Its parts, from Pollen Robotics' and Robotis' pages:")
    add("")
    add(f"- Fifteen Dynamixel XL330 servos: fourteen joints and the beak ({SOURCES['microduck']}). Pollen's files name the XL330 and not the variant. "
        f"Robotis lists two: XL330-M288-T, 0.52 N m at 5 V, 103 rev/min ({SOURCES['xl330_m288']}), and XL330-M077-T, 0.215 N m at 5 V, 383 rev/min "
        f"({SOURCES['xl330_m077']}); both 20 x 34 x 26 mm, 18 g, half-duplex TTL. The original's simulation limits its joints to 0.96 N m, which neither "
        "reaches at 5 V; the M288 is the nearer. Ask Pollen which one before ordering.")
    add(f"- A Radxa Zero 3 computer (RK3566, {SOURCES['radxa_zero_3']}) driving the servo bus at 1 Mbit/s, two inertial sensors, a camera, a distance "
        f"sensor and an NP-F battery, as their documents describe ({SOURCES['microduck']}). For a bench set-up Robotis' U2D2 joins a computer to the bus ({SOURCES['u2d2']}).")
    add("- Printed at scale 1.0 from Pollen's own files, the shells need no enlargement, and their published walking policies and runtime target "
        "exactly that hardware. Pollen Robotics also sell the robot.")
    add("")
    add("### From the parts you have")
    add("")
    add("What it matches: the shapes of the body, head, thigh covers and feet at 1.25 times the size; all fifteen servo positions; "
        "the ranges in the joint table. What it does not: the size, the mass (about 1.7 times), the width of the feet, the backpack of two boards where the "
        "original has a battery, head yaw beyond 90 degrees each way, and the walk, which is open loop and slow where the original's is learned and closed loop.")
    add("")
    add("To order:")
    add("")
    add(f"- Two M5Stack Servo Kit 180 ({SOURCES['m5_servo_kit_180']}): three position servos are needed, a kit holds two. 1.6 kg cm at 4.8 V, 750 mA stalled.")
    add(f"- One 16-channel PCA9685 servo driver board ({SOURCES['pca9685']}; for example {SOURCES['pca9685_board']}), unless one of your driver boards is that type.")
    add("- Supply: the two kit supplies are enough to stand and to try the walk. For margin, one regulated 5 V 10 A supply per shield, each fused.")
    add("- An inertial sensor only if the walk is to be closed loop: a 6-axis I2C breakout at 3.3 V on the UNO Q's second I2C bus. "
        "The open-loop gait here does not use one, and the UNO Q's data sheet lists none on the board.")
    add("- Fasteners: five M3 x 10 screws, three M3 x 16 screws, about twenty small cable ties. Horns and horn screws come with the servos.")
    add("")
    add("## Files")
    add("")
    add("- `stl/microduck-look/`: the parts, the comb feet with `comb_feet.json`, `parameters.json`, `LICENSE`, the pictures.")
    add("- `config/microduck-look/build.json`: servos, signal map, supply, parts, sources. `config/microduck-look/gait.json` and `gait_comb.json`: the gaits found.")
    add("- `robot/microduck-look/`: `joints.json`, `microduck_look.xml` (MJCF), `microduck_look.urdf`, `microduck_look_comb.xml` (MJCF on the comb feet).")
    add("- `reports/microduck-look/`: `assembly.json`, `sim.json`, `summary.json` (the entry the configurator reads).")
    add("- `microduck/look/`: model, assembly test, description, simulation, this page. `scripts/run_look.py` runs them.")
    add("")
    return "\n".join(L)


def write() -> None:
    PAGE.write_text(markdown(), encoding="utf-8", newline="\n")
