eoinjordan/botbuilder/(commit log)

2026-11-11 assembly: digital fit and balance test of the printed biped
    Builds the robot from the seven STLs and a parametric SR431/SR311 model,
    then checks interference, joint sweeps, cradle fit, board clearance, mass
    and static balance with manifold3d booleans. The STLs are read from the
    local design directory and stay out of the history until the licence of
    the meshes they derive from is settled.
    [assembly.py, model.py, protocol.py, render.py, report.py]
2026-11-11 robot: generate URDF and MJCF from the assembly model
    One generator writes the URDF, the MuJoCo model, the joint table and the
    viewer primitives from the STLs, the servo data and the assembly report,
    so limits, masses and inertias cannot drift apart. Collision shapes are
    boxes cut from the parts at their flat levels; the STLs themselves are
    only referenced by the local visual model under build/.
    [microduck.urdf]
2026-11-11 sim: MuJoCo standing test and open-loop gait experiment
    The simulator takes the same command lines as the firmware, through the
    same controller logic, so soft limits, the speed limit and the watchdog
    are exercised before any hardware exists. The gait result is reported as
    found: it stands, and it shuffles rather than walks.
    [gait.csv, gait_best.csv, stand.csv]
2026-11-11 firmware: joint command agent for the UNO Q and a trajectory player
    One line protocol carries joint angles in degrees to the simulator and to
    the board. The control core (soft limits, speed limit, watchdog, one-joint
    calibration) is plain C++ shared by the sketch and a host build, with a
    Python twin that drives the simulator. Servo output reuses the sketchbot
    approach: RoboServo channels, 16-bit duty, soft start, staggered attach.
    The sketch is unbuilt: no arduino:zephyr core on this machine. Hardware
    links in the player open only with --real.
2026-11-11 tests: headless suite and a workflow to run it on push
    Covers mesh solidity, the assembly report's invariants, the generated
    URDF and MJCF in MuJoCo, standing and falling in simulation, the command
    format and calibration, trajectory limits, and the firmware core compiled
    for the host against the Python reference. Tests that need the STLs skip
    when they are absent, as they are in CI.
    [gait_best.csv]
2026-11-11 site: GitHub Pages site with findings, 3D joint viewer and results
    A static page in the style of the sketchbot setup site, filled from the
    generated reports: status box, assembly findings and pictures, a three.js
    view with sliders held to the collision-free limits, simulation results
    and the sim-to-real checklist. Relative paths only, so it works from the
    repository base path; three.js is pinned on a CDN; no trackers. The Pages
    workflow builds site/data from committed files and never ships the STLs.
    [experiments.py, test_repo.py, test_site.py]
2026-11-11 docs: README, licence, notices, sim-to-real, power and regeneration
    States the status plainly (simulation only, never assembled or powered),
    the findings with numbers, every assumption, and the open licence question
    of the meshes the printable parts derive from, which is why those STLs
    are kept out of the history. MIT, as the sketchbot repository.
2026-11-11 docs: say where the plate outlines came from
    The parts are flat plates that do not resemble the Microduck; only the
    starting silhouettes were taken from its meshes. The check-before-
    publishing warning is replaced by a plain note of that origin.
    [test_repo.py]
2026-11-11 assembly: camera mount at the deck front in place of the head
    The torso part lost its head and neck and gained a mount for an ESP32
    camera board at the front edge of the deck. Add the three camera presets
    to the hardware configuration with sources, place the default board
    (AI-Thinker ESP32-CAM) in the model, check its fit, its clearance to the
    UNO Q stack and the cone kept clear in front of the lens, and rerun the
    assembly test, the description, the simulation and the reports.
    Forward is taken from the toes; the camera looks the same way. The
    overlap of the UNO Q with the neck root is gone with the neck. The two
    hip roll servos still run into the deck.
    Document the camera firmware arrangem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
    [gait.csv, gait_best.csv, microduck.urdf, stand.csv]
2026-11-11 config: controller bases and a compatibility table for the configurator
    The owner wants to pick a controller (UNO Q, Raspberry Pi, 51515 hub, EV3
    brick, M5Stack Core), a locomotion (biped, crank walker, wheels), drive,
    camera and head, and get a recipe for that robot. bases.json records what
    the makers publish about each base, with URLs, and marks the rest assumed
    or not verified. compat.json holds the one table of which locomotion each
    controller supports through which drive, the reasons for the rest, and the
    rules that fill a recipe, so that no combination lives in code.
2026-11-11 recipe: pure function from a selection to a recipe, mirrored in JS
    evaluate() walks config/compat.json: status first, then files, parts,
    wiring, supply sizing, software, analysis and assembly, and for an
    impossible selection the reason and the nearest possible one. Walker and
    wheeled entries take their status and numbers from the variants summary
    when another branch has written it and are 'being analysed' until then.
    site/build.js walks the same data the same way; the tests evaluate every
    combination in Python, check none is empty or self-contradictory, and
    compare with the JavaScript run under Node.
2026-11-11 site: Build yours configurator page
    A static page that renders the recipe for the selected parts, with the
    status and the not-built line at the top of every recipe. The selection
    is kept in the address so a recipe can be linked, remembered in
    localStorage inside try/catch, and can be printed or downloaded as JSON.
    The site build writes one data file for it from the same JSON the Python
    function reads.
2026-11-11 assembly: pin holes and studs compatible with LEGO elements, decoration budget
    The parts gained pin holes in pads of beam thickness and studs. Check
    that each hole is open and walled over a full beam thickness, how far each
    feature is from a joint axis and from other parts, that none is in the
    camera cone, and rerun the sweeps, the description and the simulation with
    them in place. Add the mass the stand pose tolerates at six places, as
    static balance only.
    [microduck.urdf]
2026-11-11 docs: describe the configurator, its data and what is not verified
    Says what each status means, what the joint-count and Pixy findings are
    and where they come from, and what shape of manifest and summary file the
    recipes pick up from the other branches.
2026-11-11 control: add motion manifest, safety layer and board-served server
    A page on https GitHub Pages cannot call http or ws on a local network and
    cannot open the agent's TCP port, so the control page has to be served next
    to the robot, as the sketchbot's Studio is. This adds that server in the App
    Lab app directory, the layer that decides whether a joint target is passed
    on (motion off by default, armed session, held enable, rate limit, clamp),
    and the manifest that says which motions exist so the page can disable the
    rest with a reason. The site build exports the manifest and its
    trajectories. No line is added to the command set: a stop is the status
    line followed by a J line repeating the repo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
2026-11-11 site: link Flash and Control, test both pages in headless Chrome
    Navigation links on the index page, a short README section and the NOTICE
    entries for what follows the sketchbot. The browser tests drive an installed
    Chrome over the DevTools protocol with a synthetic gamepad, in the simulator
    target and against the virtual robot through the control server; they skip
    when Chrome or the websockets package is missing.
    [test_control_page.py, test_site_pages.py]
2026-11-11 stl: commit the generated printable parts with a manifest
    The owner decided the derived printable STLs belong in the repository.
    fetch_stls.py now copies them into stl/ and writes a manifest (what each
    file is, the options it belongs to, triangles, volume, bounding box, size,
    sha256, the design commit). The assembly test reads stl/, the site serves
    the files as downloads and uses them in the 3D view, and tests check the
    manifest against the files. The 15 source meshes stay out.
    [01_torso_unoq_cam_esp32_s3_eye.stl, 01_torso_unoq_cam_esp32cam.stl, 01_torso_unoq_cam_esp_eye.stl, fit_SR311.stl, fit_SR431.stl, fit_cam_esp32_s3_eye.stl, fit_cam_esp32cam.stl, fit_cam_esp_eye.stl]
2026-11-11 assembly: hip roll servos seat under the deck, two ties clear the shaft
    The design lowered the torso cradles 2.5 mm, cut the deck corner away for
    the upper servo ear and gave every cradle four tie slot pairs. Follow it
    in the model, check the gap under the deck and beside the ear and the deck
    width left at the cut, count the tie paths that clear the shaft, and rerun
    the chain. Nothing interferes at the neutral pose now; a test asserts it.
    [01_torso_unoq_cam_esp32_s3_eye.stl, 01_torso_unoq_cam_esp32cam.stl, 01_torso_unoq_cam_esp_eye.stl, fit_SR311.stl, fit_SR431.stl, left_hip_roll_pitch_yoke.stl, left_thigh_knee_cradle.stl, microduck.urdf]
2026-11-11 site: make the configurator the landing page and follow the new biped
    Main now has the camera mount in place of the head, pin holes and studs
    on the parts and the STLs committed with a manifest, so the recipe data
    was stale. The biped's print list is taken from stl/manifest.json, its
    verdict per camera preset from what the reports cover (simulated for the
    report's preset, assembly-checked for the others, neither for an empty
    mount or parts without the pin holes), and the default camera from
    config/assembly.json so one switch changes both.
    The configurator becomes index.html for the renamed project and the biped
    findings move to biped.html. Both carry one navigation block; links to
    pages oth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
2026-11-11 stl: publish the crank walker parts with a manifest
    The two LEGO-motor walkers are the owner's own designs and are to be printable from this repository. Fifteen STLs, 5.1 MB, with purpose, quantity, size, SHA-256 and design commit for each. The repository tests now allow meshes under stl/ only, with a separate size budget, and keep the 5 MB limit for everything else.
    [camera_head.stl, camera_head_pantilt.stl, chassis.stl, crank_print_4.stl, fit_coupon.stl, gear_16t_print_6.stl, left_leg.stl, right_leg.stl]
2026-11-11 walkers: assembly and balance test of the two crank walkers
    Places the printed parts, gears, cranks, motors, controller and camera, with every placement the design leaves open stated, and checks interference through the crank cycle, the gear mesh, mass, centre of mass and whether the centre of mass stays over the stance foot at each phase. Component data carries its source or the reason for an assumed value.
    [assembly.py, model.py]
2026-11-11 walkers: MuJoCo models and crank gait experiments
    One generated model per build with the crank linkage closed by a pin constraint and a gear constraint, and motors limited by LEGO's stall torque and speed. Experiments: straight walking over a range of speeds, floor friction, unequal side speeds, starting and stopping, slopes, a step and phase errors between the sides.
    [experiments.py, mjcf.py, sim.py]
2026-11-11 docs: report on the crank walkers and a summary for the configurator
    Generated from the assembly and simulation reports: parts and sources, the Pixy2 finding, placements, balance, simulation results, what is unverified. reports/variants/summary.json gives one entry per base and locomotion type.
2026-11-11 site: page for the crank walkers with a 3D crank cycle
    Shows both builds from the reports, animates the legs and cranks from the kinematics using the published STLs, and offers the print list as downloads. The site build copies stl/lego into the site, so the no-STL test now exempts that directory.
2026-11-11 tests: pin the walker assembly and simulation results
    Checks the manifest against the files, the report against a fresh mass and balance calculation, the generated models and documents against their generators, and the steady walking results by running them.
2026-11-11 assembly: optional turning head with a pan servo, and a Pixy plate
    Add the design's turning head to the assembly test as an option beside
    the fixed mount: pan travel to the printed stops, the hand-set tilt range,
    interference at neutral and at the stops, the legs' travel with it on, the
    view cone, mass and balance at the extremes. Record what the M5Stack
    servos are (the 360 kit is continuous rotation) and what that means for a
    camera joint in docs/head.md, with the Pixy pan-tilt notes. The head is
    not in the URDF, the MJCF, the simulation or the joint commands.
    Fix the path of the STLs in the visual model: since the STLs moved to
    stl/ the recordings had failed and the committed GIFs were on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
    [01_torso_unoq_pan_head.stl, fit_sg90_cradle.stl, head_pan_platform.stl, head_pixy_plate_pixy1.stl, head_pixy_plate_pixy2.stl, head_tilt_cradle_esp32_s3_eye.stl, head_tilt_cradle_esp32cam.stl, head_tilt_cradle_esp_eye.stl]
2026-11-11 assembly: other controllers on the deck, fit and static balance
    The design gained torso variants for a Raspberry Pi Zero 2 W, a full-size
    Raspberry Pi and the LEGO 51515 hub. Add their outlines and masses to the
    hardware configuration with what is published and what is assumed, place
    each as one block, and report overlap, clearance to the camera, mass,
    centre of mass, the stand pose and margin and the static hip pitch torque
    per controller, with an EV3 brick on the hub torso for comparison. Static
    only; none was simulated. The STL size limit goes to 8 MB for 27 files.
    [01_torso_hub51515_cam_esp32cam.stl, 01_torso_pi_cam_esp32cam.stl, 01_torso_pi_zero_2w_cam_esp32cam.stl]
2026-11-11 stl: add the wheeled variant parts to the manifest
    Support posts and tips, printed wheels with O-ring or band grooves, hubs and TPU tyres, cradles for TT motors and 9 g servos, a driver plate and fit pieces: 32 files, 2.9 MB, so stl/lego is now 8.1 MB.
    [driver_plate.stl, fit_bore_cross.stl, fit_bore_horn.stl, fit_bore_tt.stl, fit_servo_cradle.stl, fit_tt_cradle.stl, hub_tpu_cross_d43.stl, hub_tpu_cross_d56.stl]
2026-11-11 walkers: wheeled variants of every controller base
    Two driven wheels on the walker chassis and a skid or ball under the shelf, for LEGO motors, 360-degree servos and TT motors. For each variant: mass, centre of mass, margins, acceleration and slope limits for wheels at the back and at the front, then a generated MuJoCo model driven straight, in a spin, in an arc, to a stop, up slopes and over steps, and the same robot on each wheel option.
2026-11-11 walkers: two-speed drive sketches for the wheeled builds
    Pybricks for the EV3 and the 51515 hub, buildhat, and gpiozero for a Pi with servos or a TB6612FNG. Syntax-checked only and marked as not run on hardware; the servo and TT ones say they are open loop.
2026-11-11 docs: report on the wheeled variants and summary entries
    Generated from the wheeled reports: bases and drives, servo against TT motor, which end the wheels belong at, skid against ball, wheels and tyres, control signals, what is unverified. The summary gains one wheeled entry per base and drive with its wheel options.
2026-11-11 site: wheeled variants on the walkers page
    A chooser per base and drive with the four support and end options, the tyre comparison, the servo and TT comparison and three recordings, with its own status box.
2026-11-11 tests: pin the wheeled analysis and simulation results
    Sources on every fact, ring sizes against the printed geometry, balance by calculation, current models and documents, and live straight, spin and slope runs.
2026-11-11 sim: model the servo dead zone, delays, compliance and supply
    The first model drove ideal position servos with no command delay. The motion study needs the parts that decide whether a step or a hop survives on hardware: transport and PWM frame latency, pulse rounding, dead band plus gear play, a series spring between horn and link, and the 4 A supply. Robot presets are built from the generated MJCF so a design variant can be tried without touching the published geometry, and the head mass is a parameter so results can be rerun when the head end changes.
2026-11-11 experiments: walk, turn, jump and sit on drawn and comb feet
    Answers the owner's request with numbers: the drawn geometry does not truly step and its jump is a hop; a variant with interleaved comb soles steps and turns. Writes the report, the docs page, the recordings, the trajectories with a manifest and the gait parameters with the tested envelope that the gamepad page reads. Jumps need the speed limit raised and are kept in trajectories/restricted.
    [comb_feet_jump.csv, comb_feet_sit.csv, comb_feet_stand_up.csv, comb_feet_turn_left.csv, comb_feet_turn_right.csv, comb_feet_walk.csv, drawn_jump.csv, drawn_sit.csv]
2026-11-11 tests: pin the motion study and check every trajectory
    Reruns the headline walk, jump and sit numbers with tolerances, checks each trajectory in the manifest against the soft limits and its speed limit through protocol.Controller, and holds the model to the published servo figures.
    [test_motion.py]
2026-11-11 recipe: choose biped files by the manifest's options, statuses from reports
    The manifest grew controller decks, a turning head and Pixy plates, and
    the biped's print list swept them all in because it took every file
    without a camera option. Files are now chosen by the option fields each
    one carries (part, controller, head, camera), so a recipe lists one torso,
    the legs, and only the fit pieces and head parts that belong to it.
    Statuses follow what the reports now hold: the Pi Zero 2 W and full-size
    Pi decks and the turning head are assembly checked, not simulated; the
    51515 hub and the EV3 brick appear on the biped only as a carried block
    with a balance figure, shown as a note under the unc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
2026-11-11 recipe: part pictures, a PDF and a zip of the whole recipe
    The owner wants the printed parts shown on the recipe and downloaded
    with it. Every STL under stl/ gets a small picture drawn by the software
    rasteriser and recorded in the manifest with the checksum of the STL it
    shows, so a changed part cannot keep an old picture. The print list is a
    grid of cards with picture, name, purpose, quantity and size, fit pieces
    first.
    Download PDF writes the recipe as a PDF in the page with no library: a
    PNG's compressed rows are what a PDF image with a PNG predictor holds, so
    the pictures go in unchanged and the text stays real text. That keeps the
    site free of a new CDN dependency and lets the output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
2026-11-11 assembly: default head is the round display as the eyes with the camera above
    The design's default torso now carries a Seeed Studio Round Display for
    XIAO, screen forward, with the camera board on a shelf above it and the
    display's LiPo cell strapped under the deck. Add the display and the cell
    to the hardware configuration with what Seeed publishes and what is
    assumed, place them in the model, and rerun the chain on that head.
    Compare the camera above and below the display (view cone against the
    legs, mass, balance), keep the camera-only mounts as short-form presets,
    and tag every torso and tilt cradle in the manifest with controller, head,
    face and camera. docs/camera.md says which way the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
    [01_torso_unoq_eyes_above_esp32cam.stl, 01_torso_unoq_eyes_above_esp_eye.stl, 01_torso_unoq_eyes_below_esp32cam.stl, 01_torso_unoq_stack_camera_forward.stl, fit_round_display.stl, head_tilt_cradle_eyes_above_esp32cam.stl, head_tilt_cradle_eyes_above_esp_eye.stl, head_tilt_cradle_eyes_below_esp32cam.stl]
2026-11-11 stl: add the 51515 hub walker and give the manifest option fields
    The hub walker's seven parts join stl/lego (10.6 MB in 54 files). The manifest takes the shape of the repository's stl/manifest.json, files[] with file, what and options, using the configurator's ids, so the recipe code can select these parts the way it selects the biped's; --merge puts the entries into that file.
    [camera_head.stl, chassis.stl, crank_print_4.stl, fit_coupon.stl, gear_16t_print_6.stl, left_leg.stl, right_leg.stl]
2026-11-11 walkers: 51515 hub crank walker through assembly and simulation
    The owner wants a walker for the Robot Inventor hub as well as the EV3. Same chain as the other two: placement, interference, mass with the hub's published 63 g and an assumed battery, balance, where the hub must sit, MuJoCo walk and limits.
    [assembly.py, mjcf.py, model.py]
2026-11-11 walkers: every wheel type for each wheeled build, with option ids
    The configurator offers wheel type, support and end per controller, so each combination is now analysed and simulated (96 variants), tagged with the configurator's ids, and given placement data for a 3D view.
2026-11-11 programs: loadable programs for the EV3 and 51515 builds
    Walker and two-wheel programs for both LEGO controllers in the two languages Robot Creator generates for each family, with ports and loading steps in the header and an index the site reads. Only calls confirmed from the Pybricks and ev3dev documentation or already generated by Robot Creator are used. The Pi programs move here from walkers/controllers.
2026-11-11 docs: summary entries the configurator can read, three walkers
    One flat entry per build with controller, locomotion, drive and wheel options by the configurator's ids, status, mass, stability, limits, STL files with quantities, parts and programs. The README section drops the status wording; the reports keep it.
    [report.py, wheeled_report.py]
2026-11-11 site: split walkers and two-wheeled pages, plain tone, downloads
    Two-wheeled builds get their own page with a chooser, a 3D view, files, parts and programs per build. Both pages take the shared navigation block and drop the status boxes; practical instructions stay. The old index page's link is removed because the landing page changes at the merge.
2026-11-11 tests: allow one controller tick between the stop's two lines
    The bridge test failed now and then at its last line. Stop reads the
    commanded position and sends it back as the hold target, two lines on the
    socket; the virtual robot ticks in real time, so a 20 ms tick can fall
    between them. The position read straight after the stop is then one tick
    of travel (2.4 degrees at the speed limit) past the target and settles
    back onto it. The test compared that reading with the settled one to 0.3
    degrees. It now allows one tick of travel and checks the robot then stays
    put. The robot's behaviour is unchanged; an atomic hold command in the
    line format would remove the step back itself.
    [test_control.py]
2026-11-11 site: neutral tags, greyed-out options with reasons, fewer refusals
    The owner prints and checks each build himself and does not want pages
    and recipes covered in caveats, and he found the configurator refusing
    builds that work. Two changes that touch the same recipe text, so they
    are made together.
    Tone: the not-built banners, status boxes and per-item assumed and
    unverified tags are gone from the pages, the recipes and the PDF. Each
    recipe keeps a short tag (Simulated, Assembly checked, Designed, In
    analysis, Needs a part, Not possible). Nothing claims a build was made:
    a mark appears only from config/validated.json, which is empty. Safety
    instructions, fit pieces first, 'measure' and 'Not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
    [recipe.py, test_build_page.py, test_control_page.py, test_flash.py, test_recipe.py]
2026-11-11 assembly: comb feet as the default soles, faces on the turning head
    The design's default shins now have comb soles whose fingers cross the
    centre line between those of the other sole. Read them in the model, keep
    the flat-soled shins as a tagged alternative, and rerun the chain.
    Joint limits come from sweeps with contact between the two shin parts
    left out, because whether the soles meet depends on both legs; a new
    section says how far the legs may move against each other. Report
    balance on one foot alone with its support polygon. Collision boxes of a
    printed slab that fills little of its bounding box are cut again across
    x and y, so the gaps between fingers stay gaps in the URDF and MJCF.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
    [01_torso_unoq_pan_head.stl, gait.csv, gait_best.csv, left_shin_comb_foot.stl, left_shin_flat_foot.stl, microduck.urdf, right_shin_comb_foot.stl, right_shin_flat_foot.stl]
2026-11-11 admin: record a printed and checked build through an issue form
    The owner wants to mark a build as validated from the site with his
    GitHub login. The site is static, so the Admin page opens a prefilled
    issue form on github.com and a workflow applies it: only an issue whose
    author is the repository owner is acted on, the form text is read from
    the event file and never reaches a command line, and each field is
    checked before config/validated.json is written. A photo is accepted
    only as a PNG or JPEG from GitHub's own attachment hosts. The workflow
    has not been run: it runs on GitHub when the form is submitted.
    [test_validated.py]
2026-11-11 protocol: refuse commands that bring one leg into the other
    With comb soles one joint inside its own limits can swing a sole into the other, so per-joint limits are not enough. The control core and its C++ twin now carry a box model of the two legs and refuse a J target or a calibration nudge that would bring them together, and do not take a tick's step that would. The test uses its own sine so the Python, C++ and page copies agree bit for bit. Checked against the exact meshes over 42400 poses: no accepted collision.
    [comb_feet_jump.csv, comb_feet_sit.csv, comb_feet_stand_up.csv, comb_feet_turn_left.csv, comb_feet_turn_right.csv, comb_feet_walk.csv, drawn_jump.csv, drawn_sit.csv]
2026-11-11 motion: rerun the study on the comb soles and the new head
    The geometry the first study proposed now exists as real parts, with a heavier head and new joint limits. The gait is searched in the parameters of gait.py so the control page can play it, every shipped trajectory is checked over its whole length against the leg clearance rule and the leg meshes, power-off and stop behaviour are measured, and the manifest is written in the shape the control page reads. Flat soles are kept as the comparison.
    [jump.csv, sit.csv, stand_up.csv, turn_left.csv, turn_right.csv, walk.csv]
2026-11-11 protocol: add a one-line hold and mirror the leg rule on the page
    A stop was the status line and then a J line with the reported angles, and a controller tick between the two let a joint travel 2.4 degrees more before settling back. H holds the commanded angles of the instant in one line; S and J are unchanged and a board without H still gets the old pair. The control page now carries the leg clearance rule operation for operation, refuses a jog into the other sole and says so, and the board-served server passes a refusal back instead of treating it as a link error. Python, the host-compiled C++ and the page agree on 6000 commands and 20000 poses.
    [DuckControl.hpp, motions.py, protocol.py, test_control.py, test_control_page.py, test_firmware.py]
2026-11-11 sim: one gait file, sweep under the leg rule, power-off on the stops
    The tuned gait becomes config/gait.json, the one file the control page, the simulator and the trajectories read. The first simulator's sweep no longer runs parameter sets whose commands the firmware would refuse, and its joints are free over the servo travel, so a relaxed robot sinks onto the travel stops instead of falling off a soft limit; the condition that rests on is in the status notes. The motion study moves to the biped page and the recipe's simulated verdict now carries its numbers.
    [gait.csv, gait_best.csv]
2026-11-11 site: pick a finished build first, configurator as a sidebar
    The landing page opened on the configurator, so a visitor had to make
    eleven choices before seeing a robot. It now opens with five finished
    builds as cards; choosing one shows its recipe, and the configurator is
    a sidebar beside the recipe for drilling into a custom build.
    The builds are data, config/builds.json: the UNO Q biped, the EV3, 51515
    hub and Pi Build HAT crank walkers, and the Pi two-wheeled build on TT
    motors with the wheels at the back. Each names only the fields that make
    it, so the biped's camera keeps following config/assembly.json. A test
    fails for a build that is no longer tagged Simulated, has a file without
    a p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
    [buildpics.py, recipe.py, test_build_browser.py, test_build_page.py, test_builds.py, test_tone.py]
2026-11-11 assembly: ESP-EYE as the default camera, mounted connector up
    The design made the ESP-EYE the default camera on the eyes_above head,
    standing with its USB connector up so that the head is 124 mm tall and not
    149 mm. Follow it in the configuration and the hardware data, analyse the
    ESP-EYE above and below the display beside the ESP32-CAM, and rerun the
    chain: assembly, description, simulation, the motion study with the
    committed gait, trajectories, recordings, STLs, manifest and thumbnails.
    The committed gait still steps on the new head (44.4 mm/s, 99 percent of
    its steps, peak torque 0.647, 30 of 30 perturbed runs upright), so it was
    not searched again.
    docs/camera.md gives the steps to fl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
    [01_torso_hub51515_cam_esp_eye.stl, 01_torso_pi_cam_esp_eye.stl, 01_torso_pi_zero_2w_cam_esp_eye.stl, 01_torso_unoq_cam_esp_eye.stl, 01_torso_unoq_eyes_above_esp_eye.stl, 01_torso_unoq_eyes_below_esp_eye.stl, fit_cam_esp_eye.stl, head_tilt_cradle_esp_eye.stl]
2026-11-11 site: show pictures of the bought parts in the form and recipes
    The printed parts had rendered thumbnails; the bought ones were names
    only. Every choice in the sidebar now shows a picture of the chosen
    option, "Pictures" under a field lists its options as picture buttons
    that set the native list, and the parts list of a recipe shows each
    bought part with its picture. The PDF carries the same pictures and a
    credits section on its last page.
    Sources, as the owner asked: openly licensed photographs from Wikimedia
    Commons and, where none was found, drawings. config/component_images.json
    records origin, author, licence and source for every picture.
    scripts/fetch_component_photos.py reads each fi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
2026-11-11 site: add a logo: robot head in a gear with a screwdriver
    The masthead carried the letters BB in a box and the site had no browser
    icon or link preview. The owner asked for a logo with a screwdriver, a
    bot head and gears.
    The mark is original and small: a rounded head with two round eyes, as
    the biped's round display, inside a twelve-tooth gear, with a screwdriver
    standing on the head as its antenna. It uses the site's green and ink on
    white, one stroke weight and rounded joins, and has a one-colour variant
    in currentColor.
    scripts/make_logo.py holds the mark once, as a list of shapes on a 64
    unit grid, with the gear computed from its tooth count. From that list
    it writes the SVG files (th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
2026-11-11 site: add a guided tour of the features
    A new visitor had no way to learn what the site offers beyond reading
    each page. The owner asked for a click-through that guides new users to
    the features.
    site/tour.js shows eleven steps, each a short card beside the control
    it is about with the rest of the page dimmed: what Botbuilder is, the
    finished builds, the recipe, the PDF and zip, the Customise sidebar and
    its greyed-out options, the pictures of the parts, then the Biped,
    Flash, Control and Admin pages and the Arms link. The steps are content
    in config/tour.json, copied to the site by the build.
    A first-time visitor on the landing page gets a small "New here?" card
    to start the tour or send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
    [test_build_page.py, test_control_page.py, test_site.py, test_site_pages.py, test_tour.py, test_walkers.py]
2026-11-11 site: follow the ESP-EYE default after merging main
    After the merge the biped card's picture was older than the geometry and
    its test said so. python -m microduck.buildpics redraws it with the
    ESP-EYE torso and records the new inputs.
    The card gave the biped's speed as the best of the parameter sweep in
    reports/sim.json, 33.6 mm/s. The recipe verdict and the biped page quote
    the walk of the motion study, 44.4 mm/s, so the card now reads that
    figure from reports/motion.json and a test ties it to the verdict.
    tests/test_tone.py looked two recipes up by a query that named the
    ESP32-CAM as the default camera; it now uses the configured camera.
    The two Raspberry Pi board photographs showed the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
2026-11-11 look: add a biped that keeps the Microduck's shells
    The plate biped does not look like the robot it started from. This build keeps the original's body, head, thigh covers and feet at 1.25 times the size, on twelve Braccio servos and three small position servos at the original's fifteen servo positions.
    Parts in stl/microduck-look with their manifest entries and pictures, the assembly test, URDF and MJCF with inertias from the meshes, the standing simulation and a walking attempt under microduck/look, reports and docs/microduck-look.md. scripts/fetch_stls.py lists the parts again after it rewrites the manifest.
    The parts reproduce Pollen Robotics' shells, so they carry CC BY-NC-SA 4.0 with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
    [beak_jaw.stl, beak_top.stl, body_left.stl, body_right.stl, fit_M5_180.stl, fit_SR311.stl, fit_SR431.stl, fit_eye_esp_eye.stl]
2026-11-11 recipe: offer the Microduck-look biped in the configurator
    The build is offered as a locomotion of its own, 'Biped, Microduck look', with the drive 'twelve Braccio servos on two Braccio shields', on the UNO Q. Every rule of the six-servo biped is keyed on locomotion biped, so a separate id leaves those rules, their files and their numbers untouched; a style switch on the biped would have meant editing seventeen of them and both evaluators.
    Its files, parts and numbers come from reports/microduck-look/summary.json, which recipe.variants() now reads beside the variants summary (EXTRA_SUMMARIES). site/build.js is unchanged: the evaluator needs no new code. The licence line of the parts is in t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
2026-11-11 site: a coloured masthead, plainer words, About and not-found pages
    The masthead was black text on white and looked like no part of the
    logo. The owner asked for a title bar with colour and a friendlier, more
    complete site.
    Masthead. A band from a deep green to the logo's green with a warm line
    under it, the one-colour mark in white, the name larger, and the tabs as
    pills with the current page as a white pill. On a phone the tabs are one
    row that scrolls inside the band. The palette gains three named colours
    in site/style.css. Contrast, WCAG 2 relative luminance:
    white on --green #087f60 4.98 band text, lightest end
    white on --green-deep #065a45 8.22 band text, darkest e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
2026-11-12 look: comb feet for the Microduck-look biped, simulated on both
    The two feet with part of the web cut away and fingers that cross the
    centre line between the other foot's, made from the committed feet by
    microduck/look/combfeet.py. The assembly test, the MJCF and the walking
    search run on either set of feet; the search on the comb feet refuses a
    gait in which the two feet's meshes overlap.
    In the simulation the comb feet walk at 6.3 mm/s against 3.3 mm/s on the
    feet as generated, with one foot loaded 76 percent of the time against 9.
    The comb feet carry the terms of the parts they are made from.
    [left_foot_comb.stl, right_foot_comb.stl]
2026-11-12 tests: raise the size limits for the Microduck-look parts
    Printable files 24 to 25 MB, everything else 8.8 to 9.2 MB, the whole
    checkout 32 to 34 MB. Measured: 24.7, 8.9 and 33.6 MB.
2026-11-12 site: the Microduck-look biped as the sixth finished build
    A card on the landing page, on its comb feet, with its own picture; the
    feet are a choice in the sidebar for it as for the plate biped, and each
    choice has its own entry in the build's summary. Its recipe links to a
    flash page that says what to do in place of the six-joint agent's
    commands, and to a section about it on the biped page.
